federicohyo/OSCAR/data/README.md

# data

Archived result datasets — the inputs the plotting scripts in
`../measurements/` read. The shipped results cover LNA, wet-pad, array
characterisation, synaptic calibration, olfaction classification, and the
curated bias operating points.

| Directory | Contents |
|---|---|
| `olfaction/` | Olfaction classification: `olf_validate/*.npz` (nine held-out acquisitions), `olfaction_class_curve.json` / `_emul.json`, `olfaction_k3.json`, the hybrid score/slot/payoff JSONs, comparator JSONs, and the extra-panel inputs that ship here (`selfheal_*.json` drift summaries, the hybrid transfer/run arrays). |
| `synapse/` | Synaptic calibration: `onset_n5*.json` / `.csv` (weight-code ladder) and the rate-transfer CSVs. |
| `array/` | Array characterisation: `neuron_fi_allneurons.csv` (16-neuron FI sweep) and `scope_{14,17,20}_neu14_if.csv` (neuron-14 membrane traces used as FI insets). |
| `biases/` | Curated `*.biases` operating points referenced by the plotting table (25 MHz reference points, synapse-characterisation patterns, comparator levels, LNA biases). |

The derived result files here come from third-party metal-oxide gas-sensor
measurements; see `NOTICE` for attribution.

See `../docs/PLOTTING.md` for which figure reads which file.
