federicohyo/OSCAR/docs/figures/fig_hardware_layout.pdf

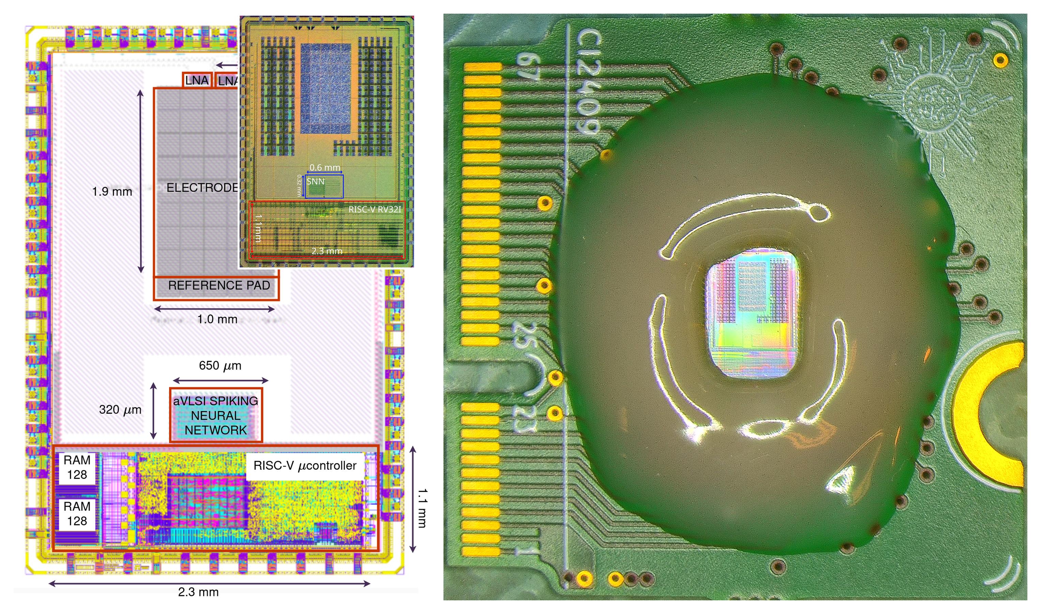
[picture p2: page 1]
