federicohyo/OSCAR/docs/figures/domain_map.pdf

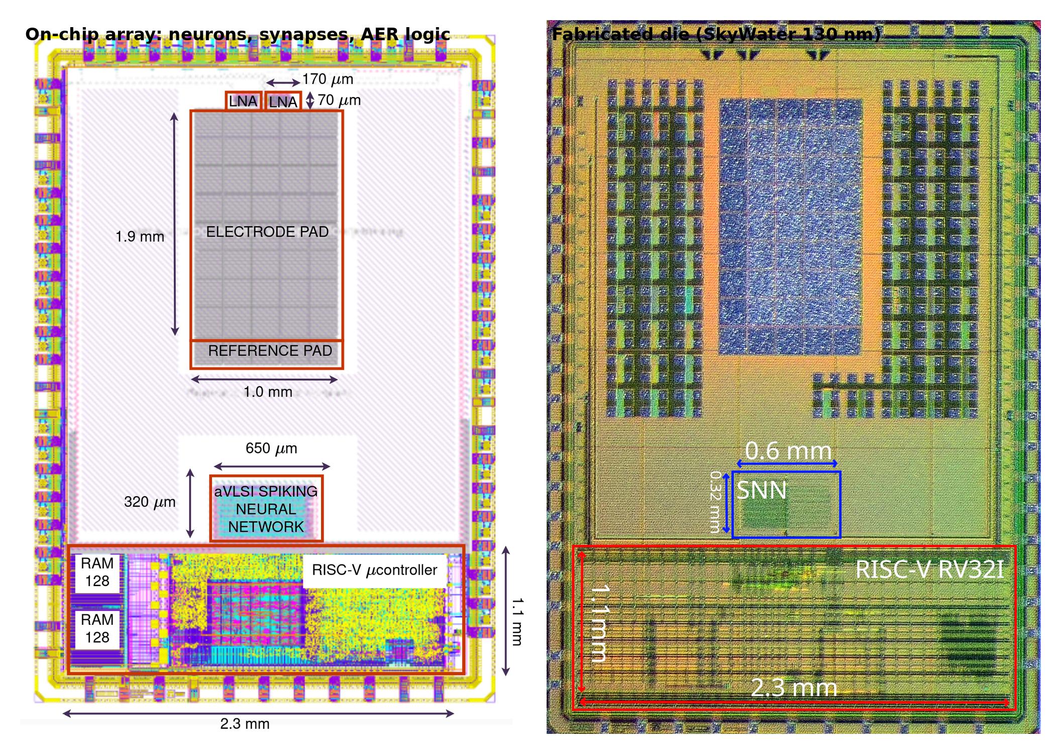
[picture p3: page 1]
