federicohyo/OSCAR/design/python/figures/neuron_analog_tb.png

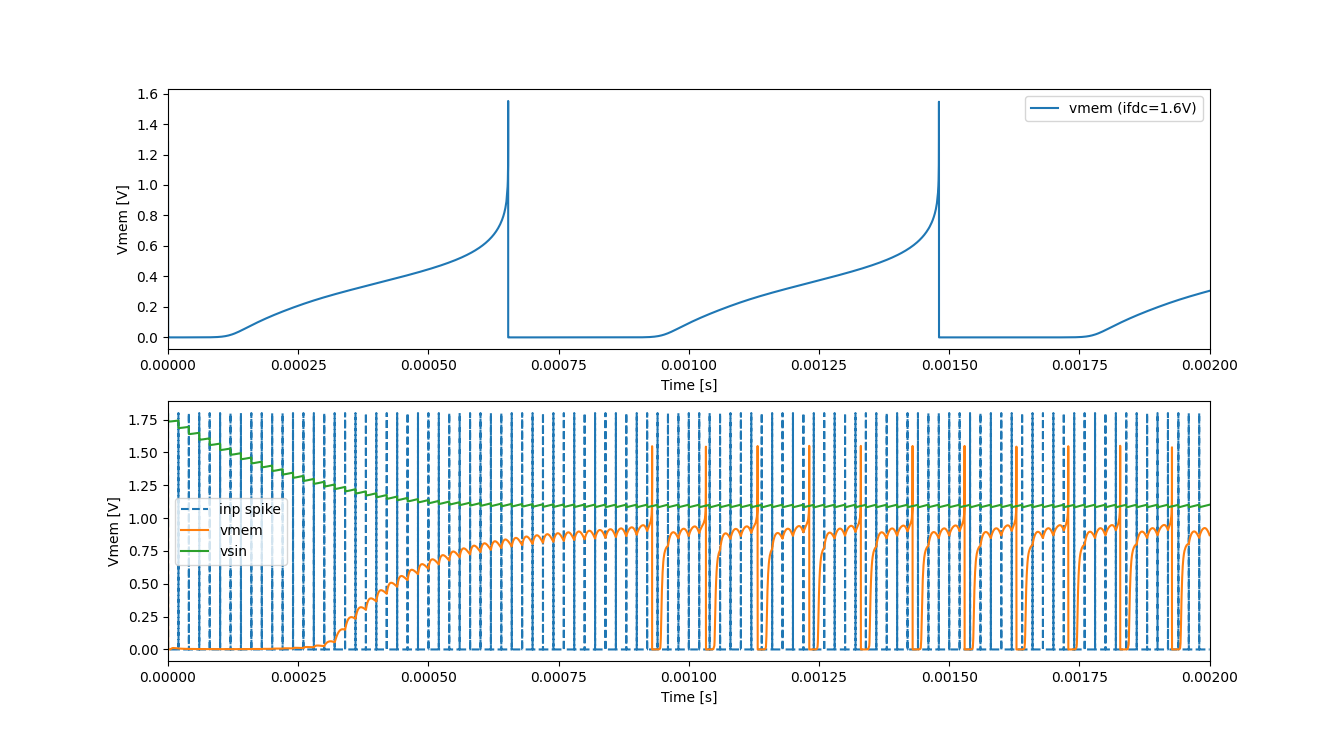
design/python/figures/neuron_analog_tb.png
