federicohyo/OSCAR/design/python/figures/neuron_analog_tb_v1.png

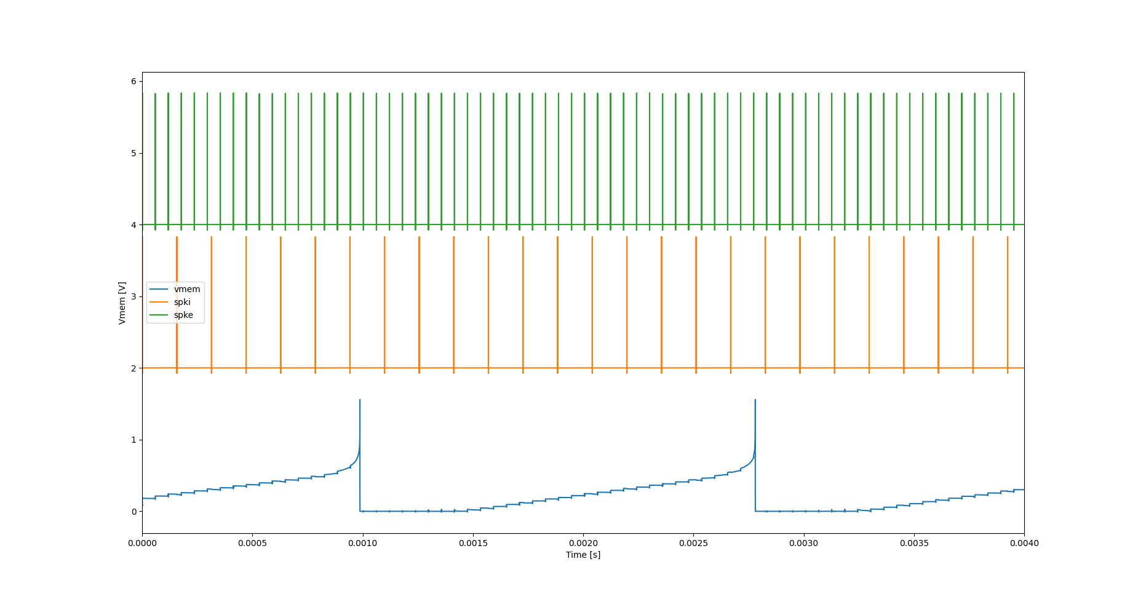
design/python/figures/neuron_analog_tb_v1.png
