federicohyo/OSCAR/design/python/figures/neuron_analog_tb_v1_ff.png

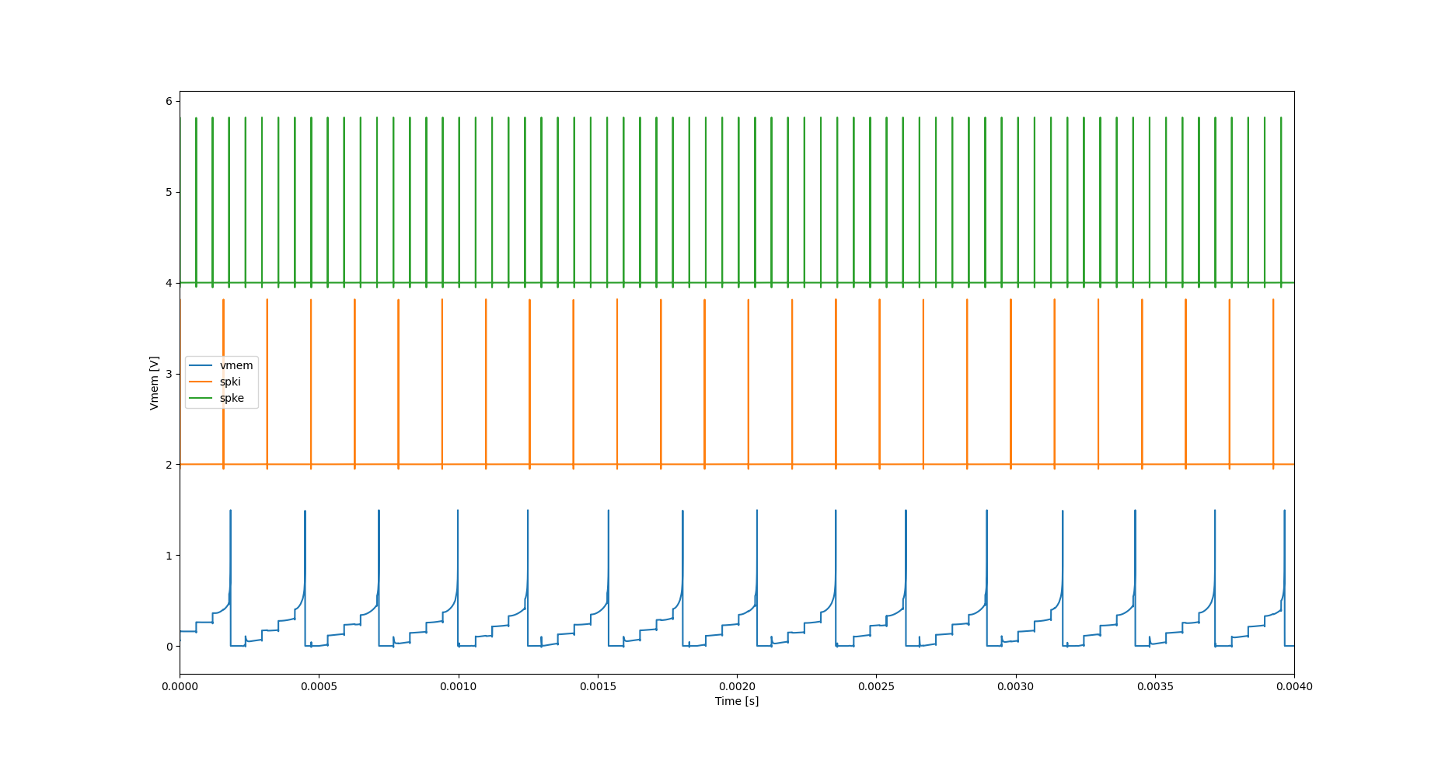
design/python/figures/neuron_analog_tb_v1_ff.png
