federicohyo/OSCAR/docs/figures/arch_overview.png

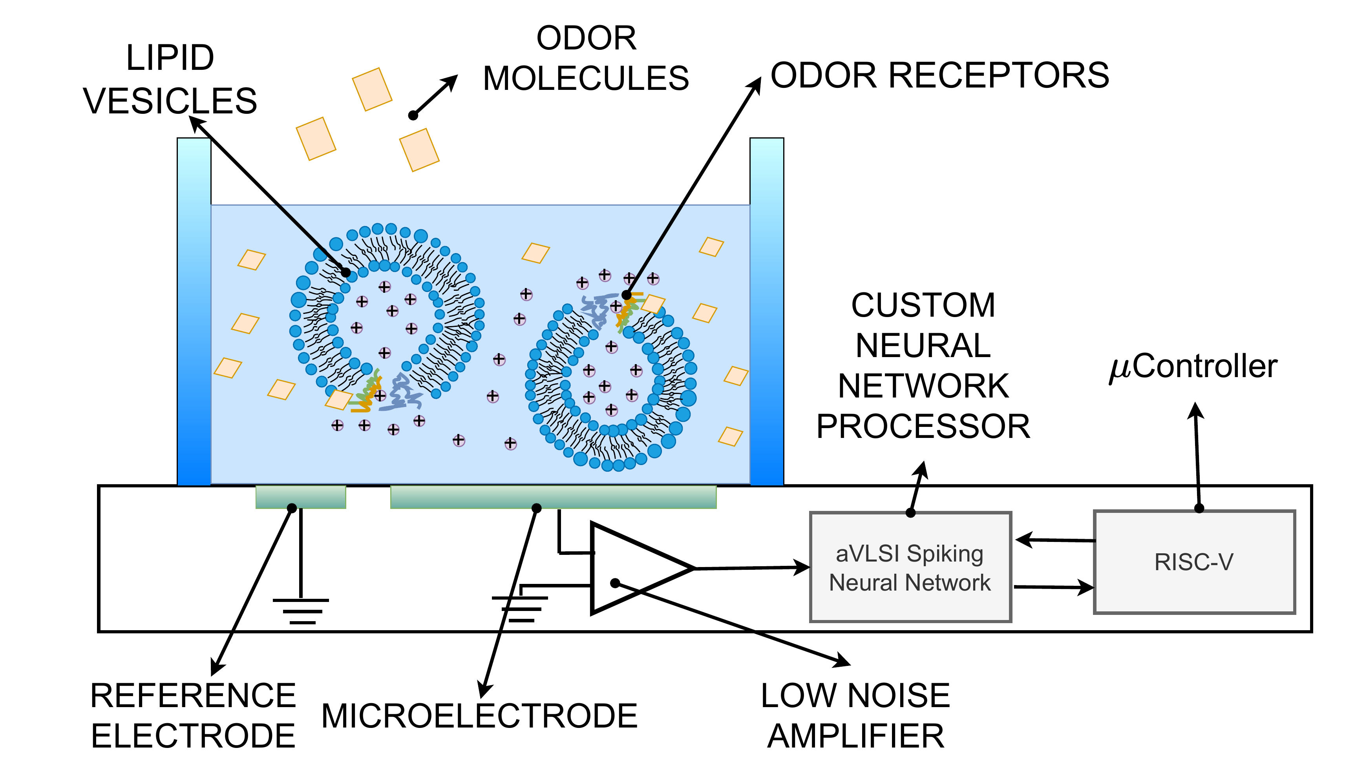
docs/figures/arch_overview.png
