federicohyo/OSCAR/measurements/plotting/figures/olfaction_cost.pdf

analog
array

all-digital
same pipeline

0

5000

10000

15000

20000

25000

30000

35000

40000

### energy per decision (μJ)

projection

kernel
features

0.76 voted 0.82 voted

tree kernels 158--220 μJ

(a)

input DSP: projection + encode output DSP: kernel features + classi

fier
AER interface (LA handshake) neurons: analog rail
neurons: digital emulation

digital
emulation

analog
array

0

10

20

30

40

50

### energy per neuron-step (nJ)

bar to beat

(b)

43.4 nJ

19.3 nJ

analog rail
AER read-out

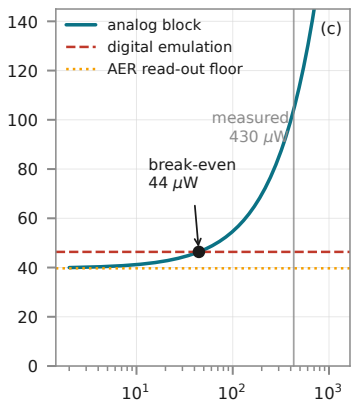
[picture p8: figure]
break-even 44 μW; measured 430 μW; analog block; digital emulation AER read-out; floor

a

n

### alo

g

r

### ail p

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
### neuron block, energy per chunk (μJ)
