federicohyo/OSCAR/measurements/lna/figures/tio2_dilute3x.pdf

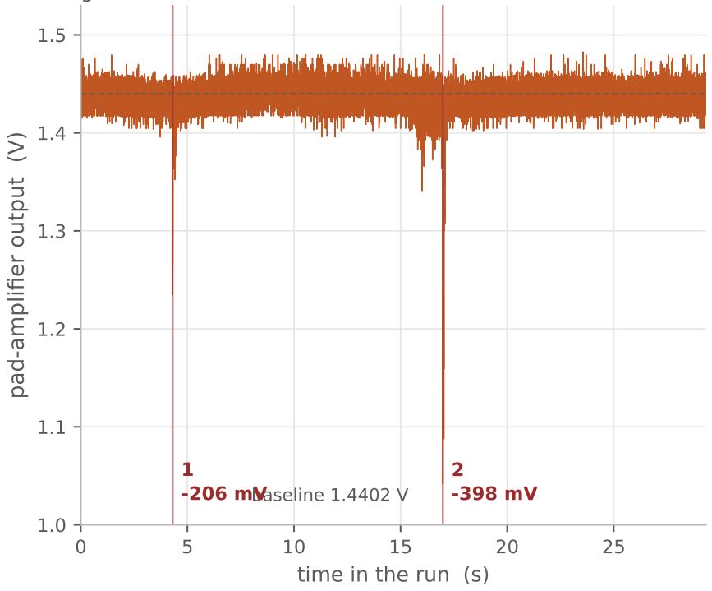
[picture p9: figure]
time in the run (s); pad-ampli; fier output (V); baseline 1.4402 V
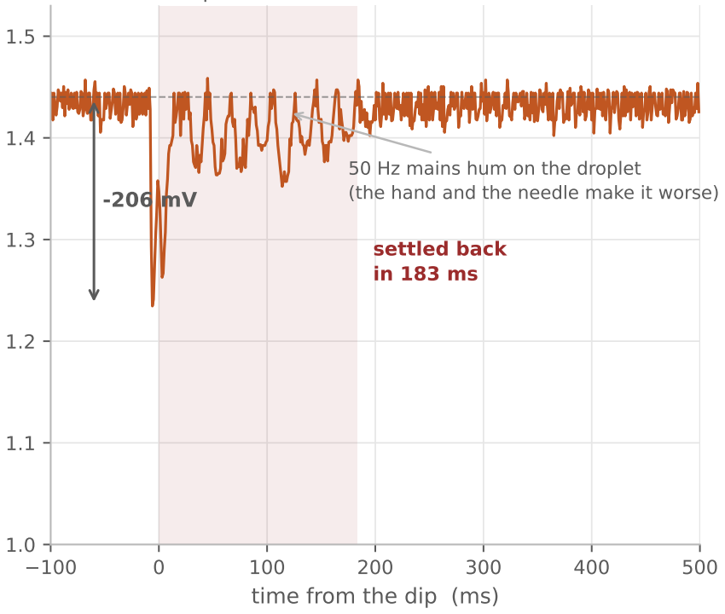
[picture p10: figure]
time from the dip (ms); settled back in 183 ms; 50 Hz mains hum on the droplet (the hand and the needle make it worse)
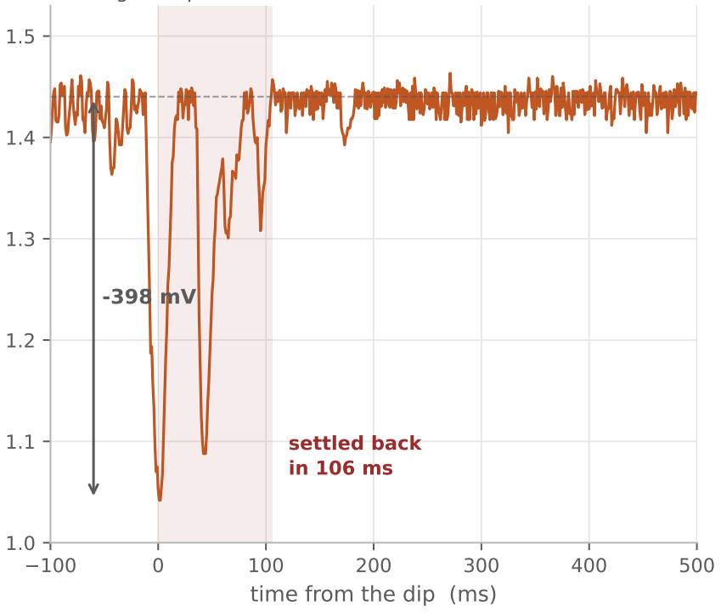
[picture p11: figure]
time from the dip (ms); settled back in 106 ms

graded, and the baseline comes back both times

## 1 — two injections

the smaller aliquot: -206 mV, no residual offset

## 2 — first injection

the larger aliquot: -398 mV, no residual offset

## 3 — second injection

# TiO₂ pad, saline diluted 3× and the biases moved off the clamp

scope_20260829_103015.csv, one continuous 1 kHz record, lna_iref = 1.157 V. Two injections into the droplet: both are graded, both recover, nothing saturates.
