federicohyo/OSCAR/measurements/lna/figures/tio2_injection_recovery.pdf

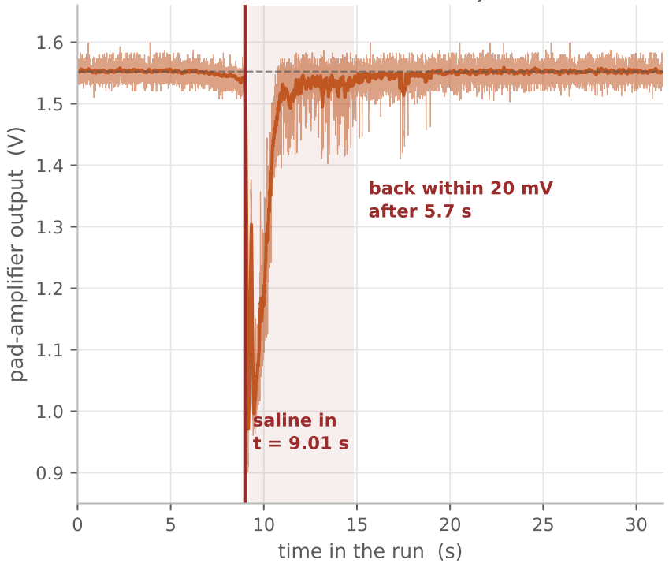
[picture p12: figure]
time in the run (s); pad-ampli; fier output (V); saline in t = 9.01 s; back within 20 mV after 5.7 s
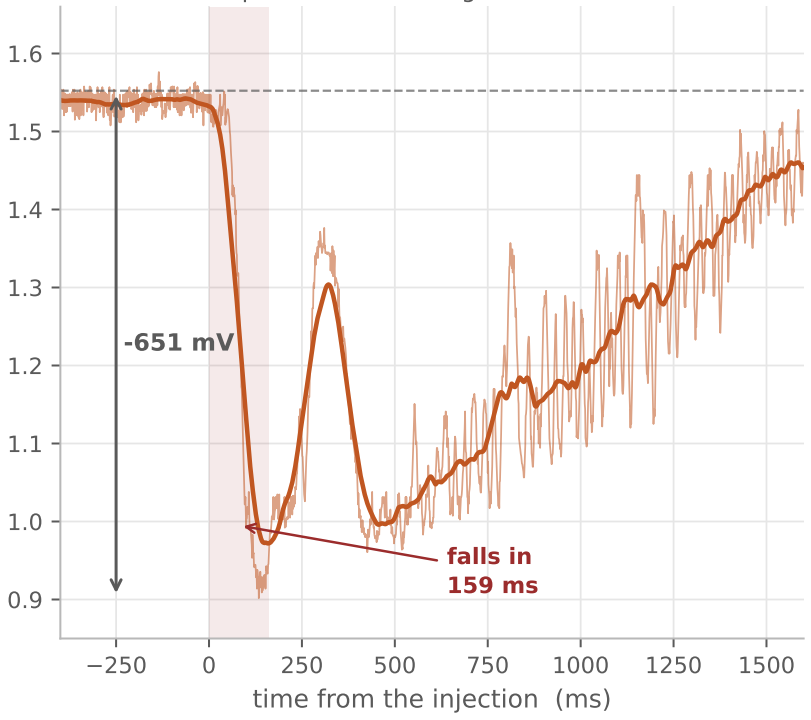
[picture p13: figure]
time from the injection (ms); falls in 159 ms
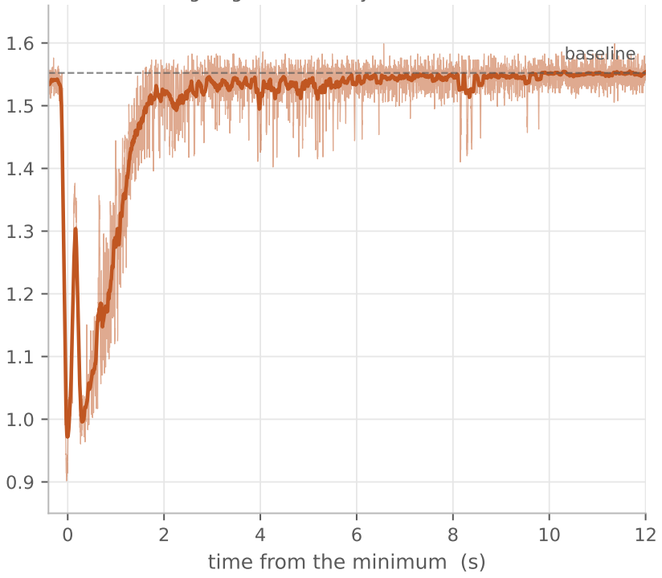
[picture p14: figure]
time from the minimum (s); baseline

baseline 1.5523 V, and it comes all the way back

### 1 — one injection

fast in, and far past the linear range

### 2 — the edge

the whole rising edge, all the way back

### 3 — the recovery

## TiO₂ pad: one saline injection, and the recovery

scope_20260829_110950-saline-injection&recovery.csv, one continuous 1 kHz record. Thin trace raw, thick trace smoothed over 101 ms (which nulls the 50 Hz mains pickup on the droplet).
