federicohyo/OSCAR/measurements/lna/figures/tio2_three_panel.pdf

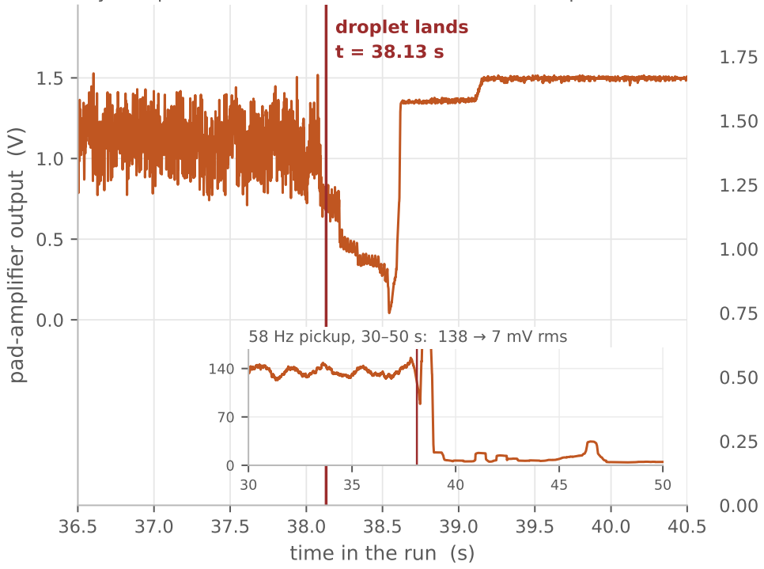
[picture p15: figure]
time in the run (s); pad-ampli; fier output (V); droplet lands t = 38.13 s; 58 Hz pickup, 30–50 s: 138 → 7 mV rms

dry, the pad is an antenna; water lands and that stops

### 1 — wetting

output holds 1.497 V for 5 s; 7 mV rms

### 2 — it settles, and stays quiet

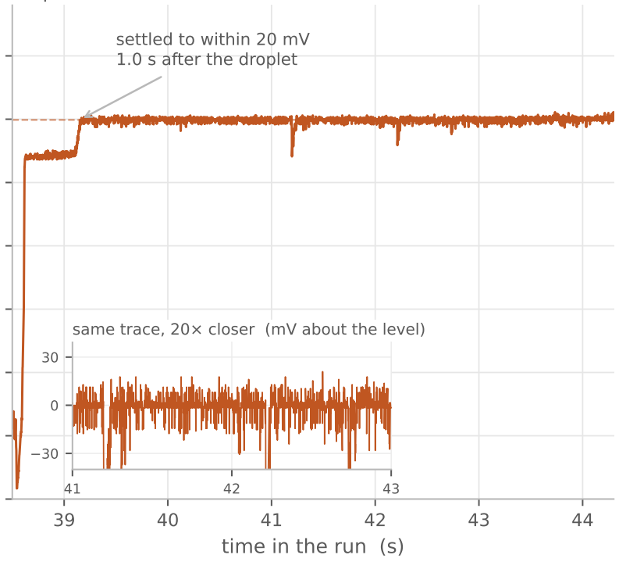
[picture p16: figure]
time in the run (s); settled to within 20 mV 1.0 s after the droplet

same trace, 20× closer (mV about the level) the salt drives the output +308 mV, up to the rail

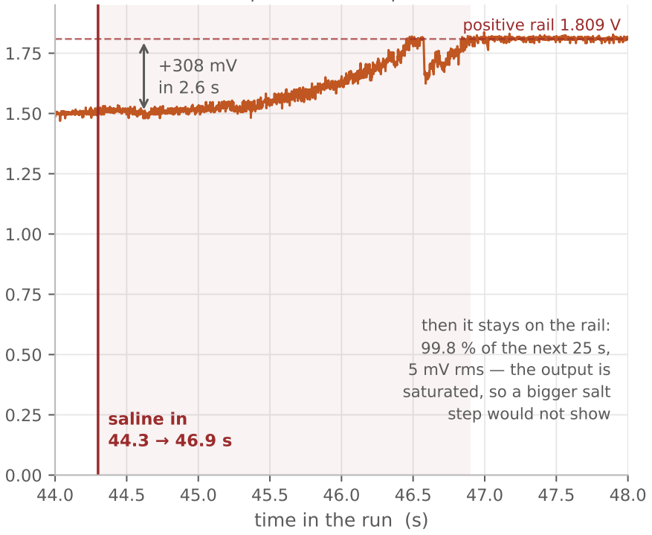
[picture p17: figure]
time in the run (s); positive rail 1.809 V

| | then it stays on the rail: 99.8 % of the next 25 s,
saline in | 5 mV rms — the output is saturated, so a bigger salt | step would not show

### 3 — saline, and the output signal

## TiO₂ water pad — output of the on-chip pad amplifier (scope ch2)

one continuous 1 kHz record, scope_20260829_094236.csv. The second amplifier (ch1, jack input) is not driven here and is not shown.
