federicohyo/OSCAR/measurements/plotting/figures/ecg_frontier.pdf

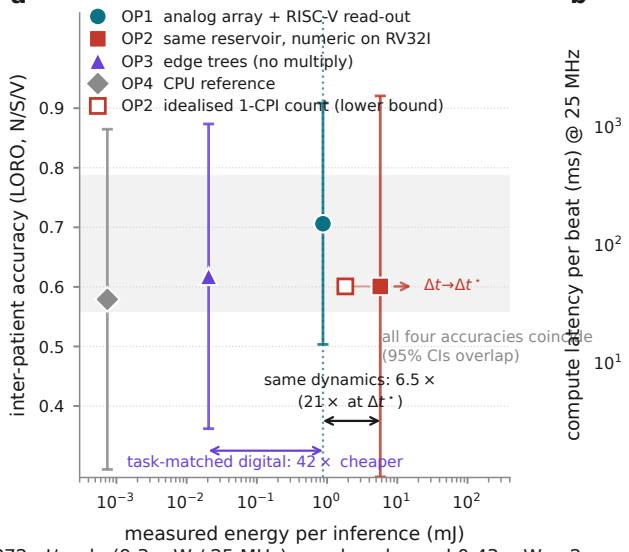
[picture p18: figure]
measured energy per inference (mJ); inter-patient accuracy (LORO, N/S/V); all four accuracies coincide (95% CIs overlap) same dynamics: 6.5 × (21 × at Δt; task-matched digital: 42 × cheaper; OP1 analog array + RISC-V read-out OP2 same reservoir, numeric on RV32I OP3 edge trees (no multiply) OP4 CPU reference OP2 idealised 1-CPI count (lower bound); compute latency per beat (ms) @ 25 MHz

372 pJ/cycle (9.3 mW / 25 MHz) · analog charged 0.43 mW × 2 s

a

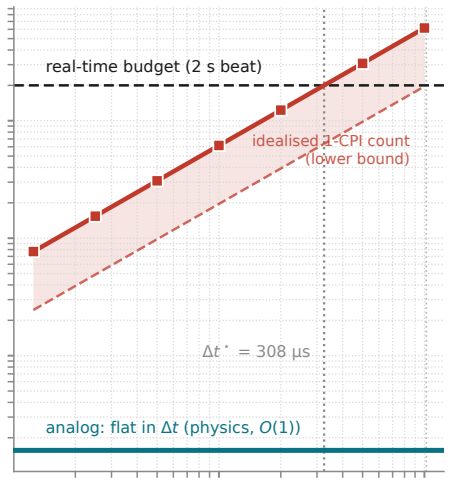
[picture p19: figure]
idealised 1-CPI count (lower bound); real-time budget (2 s beat); analog: flat in Δt (physics, O(1))

10

3 | 10

4
temporal-resolution demand 1/Δt (Hz)

numeric, measured: ∝ N/Δt

b
