federicohyo/OSCAR/measurements/lna/clean_2026-08-26/derived/transfer.csv

tag | block | utc | freq_hz | jack_vpp | divider | vin_pp | settle_s | window_s | vout_pp | gain | gain_db | dc_v | peak_v | trough_v | h2 | h3 | resid_rms_v | amp_se_v | drift_mv_s | n_samples | frac_at_rail | frac_at_zero | raw_npz | flag
quiet_before | transfer | 18:14:03 | 88.5700 | 0.00000 | 0.028 | 0.000000 | 20.0 | 8.0 | 0.000460 | nan |  | 1.6757 | 1.6759 | 1.6755 | 1.7291 | 1.1520 | 0.015729 | 0.000248 | 0.169 | 8046 | 0.0000 | 0.0000 | raw/transfer/quiet_before.npz | no drive
F00_0.2125Hz | transfer | 18:15:32 | 0.2125 | 0.01786 | 0.028 | 0.000500 | 60.0 | 28.235294117647058 | 0.003534 | 7.07 | 16.986 | 1.6757 | 1.6774 | 1.6739 | 0.1312 | 0.1439 | 0.015769 | 0.000132 | 0.024 | 28380 | 0.0000 | 0.0000 | raw/transfer/F00_0.2125Hz.npz
F01_0.3099Hz | transfer | 18:16:52 | 0.3099 | 0.01786 | 0.028 | 0.000500 | 60.0 | 19.36108422071636 | 0.008686 | 17.37 | 24.797 | 1.6754 | 1.6798 | 1.6711 | 0.1153 | 0.1061 | 0.015800 | 0.000160 | -0.089 | 19456 | 0.0000 | 0.0000 | raw/transfer/F01_0.3099Hz.npz
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
