federicohyo/OSCAR/measurements/plotting/figures/bias_mismatch_heatmap.pdf

0.20

0.21

## Vleakn (V)

n0 | n1 | n2 | n3

0.20

0.21

## Vleakn (V)

n4 | n5 | n6 | n7

0.20

0.21

## Vleakn (V)

n8 | n9 | n10 | n11

1.275 1.300 Ifdcp (V)

0.20

0.21

## Vleakn (V)

n12

1.275 1.300 Ifdcp (V)

n13

1.275 1.300 Ifdcp (V)

n14

1.275 1.300 Ifdcp (V)

n15

### Firing rate (Hz)
