federicohyo/OSCAR/measurements/plotting/figures/comparator_drift2.pdf

## (a) die 1: five-day drift, then repair

## (b) die 2: one session, top of the ladder wanders

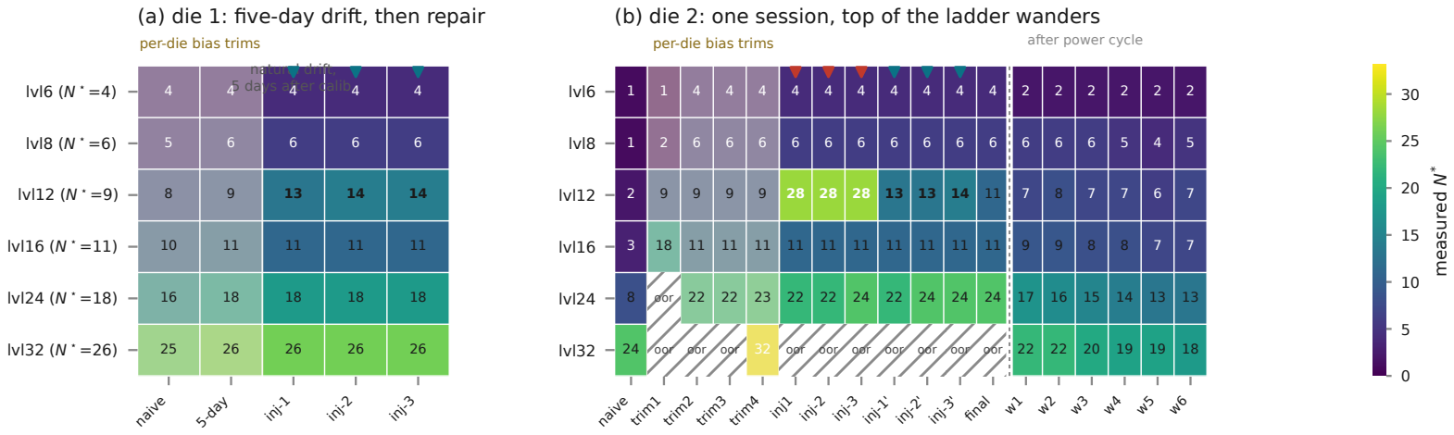
[picture p20: page 1]

naive

5-day
inj-1

inj-2

inj-3

lvl6 (N

⋆ =4)

lvl8 (N

⋆ =6)

lvl12 (N

⋆ =9)

lvl16 (N

⋆ =11)

lvl24 (N

⋆ =18)

lvl32 (N

⋆ =26)

per-die bias trims
natural drift,
5 days after calib.
4 | 4 | 4 | 4 | 4
5 | 6 | 6 | 6 | 6
8 | 9 | 13 | 14 | 14
10 | 11 | 11 | 11 | 11
16 | 18 | 18 | 18 | 18
25 | 26 | 26 | 26 | 26

naive
trim1

trim2

trim3

trim4

inj1

inj-2

inj-3

inj-1'

inj-2'
inj-3'

final
w1

w2

w3

w4

w5

w6

lvl6

lvl8

lvl12

lvl16

lvl24

lvl32

per-die bias trims | after power cycle
1 | 1 | 4 | 4 | 4 | 4 | 4 | 4 | 4 | 4 | 4 | 4 | 2 | 2 | 2 | 2 | 2 | 2
1 | 2 | 6 | 6 | 6 | 6 | 6 | 6 | 6 | 6 | 6 | 6 | 6 | 6 | 6 | 5 | 4 | 5
2 | 9 | 9 | 9 | 9 | 28 | 28 | 28 | 13 | 13 | 14 | 11 | 7 | 8 | 7 | 7 | 6 | 7
3 | 18 | 11 | 11 | 11 | 11 | 11 | 11 | 11 | 11 | 11 | 11 | 9 | 9 | 8 | 8 | 7 | 7
8 | oor | 22 | 22 | 23 | 22 | 22 | 24 | 22 | 24 | 24 | 24 | 17 | 16 | 15 | 14 | 13 | 13
24 | oor | oor | oor | 32 | oor | oor | oor | oor | oor | oor | oor | 22 | 22 | 20 | 19 | 19 | 18
0

5

10

15

20

25

30

### measured N

*
