federicohyo/OSCAR/measurements/plotting/figures/comparator_drift2_a.pdf

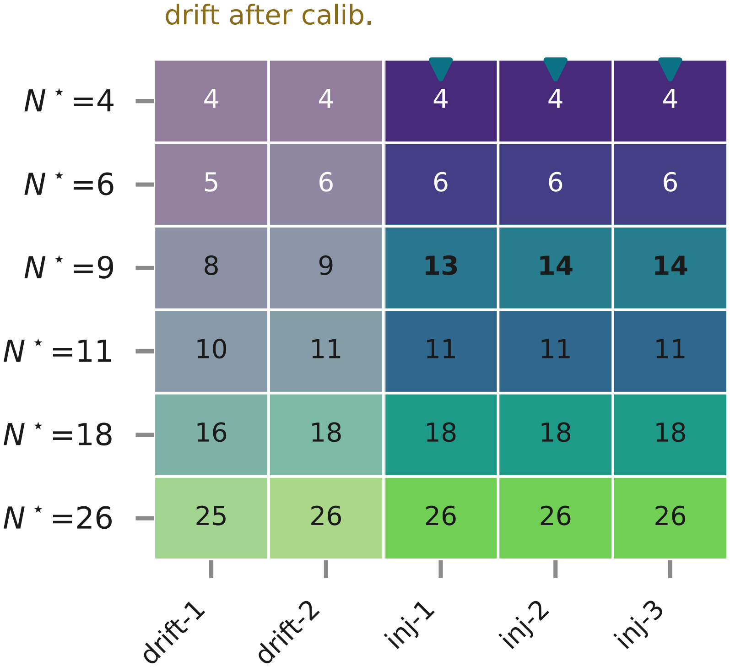
[picture p21: page 1]

drift-1

drift-2

inj-1

inj-2

inj-3

N

⋆ =4

N

⋆ =6

N

⋆ =9

N

⋆ =11

N

⋆ =18

N

⋆ =26

drift after calib.

4 | 4 | 4 | 4 | 4
5 | 6 | 6 | 6 | 6
8 | 9 | 13 | 14 | 14
10 | 11 | 11 | 11 | 11
16 | 18 | 18 | 18 | 18
25 | 26 | 26 | 26 | 26
