federicohyo/OSCAR/measurements/plotting/figures/comparator_drift2d.pdf

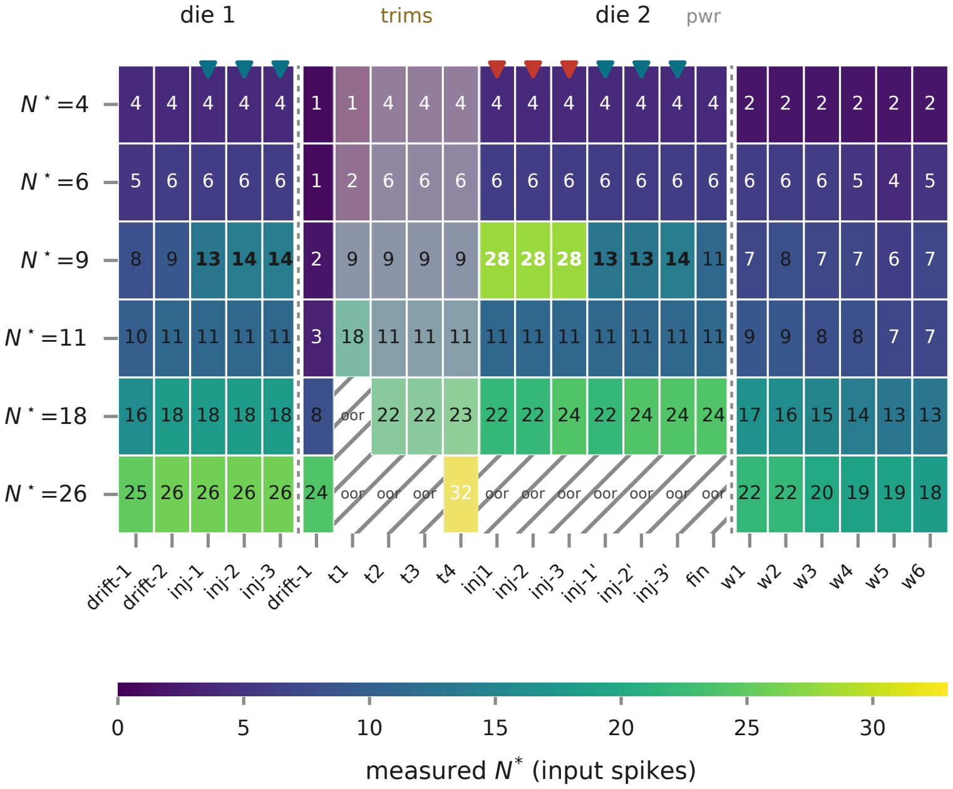
[picture p22: page 1]

drift-1

drift-2
inj-1
inj-2

inj-3

drift-1
t1
t2

t3

t4

inj1

inj-2

inj-3
inj-1'
inj-2'

inj-3'
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
⋆ =4

N

⋆ =6

N

⋆ =9

N

⋆ =11

N

⋆ =18

N

⋆ =26

die 1 | trims | die 2 | pwr
4 | 4 | 4 | 4 | 4 | 1 | 1 | 4 | 4 | 4 | 4 | 4 | 4 | 4 | 4 | 4 | 4 | 2 | 2 | 2 | 2 | 2 | 2
5 | 6 | 6 | 6 | 6 | 1 | 2 | 6 | 6 | 6 | 6 | 6 | 6 | 6 | 6 | 6 | 6 | 6 | 6 | 6 | 5 | 4 | 5
8 | 9 | 13 | 14 | 14 | 2 | 9 | 9 | 9 | 9 | 28 | 28 | 28 | 13 | 13 | 14 | 11 | 7 | 8 | 7 | 7 | 6 | 7
10 | 11 | 11 | 11 | 11 | 3 | 18 | 11 | 11 | 11 | 11 | 11 | 11 | 11 | 11 | 11 | 11 | 9 | 9 | 8 | 8 | 7 | 7
16 | 18 | 18 | 18 | 18 | 8 | oor | 22 | 22 | 23 | 22 | 22 | 24 | 22 | 24 | 24 | 24 | 17 | 16 | 15 | 14 | 13 | 13
25 | 26 | 26 | 26 | 26 | 24 | oor | oor | oor | 32 | oor | oor | oor | oor | oor | oor | oor | 22 | 22 | 20 | 19 | 19 | 18
0 | 5 | 10 | 15 | 20 | 25 | 30

### measured N

*

### (input spikes)
