federicohyo/OSCAR/measurements/plotting/figures/olfaction_scaling.pdf

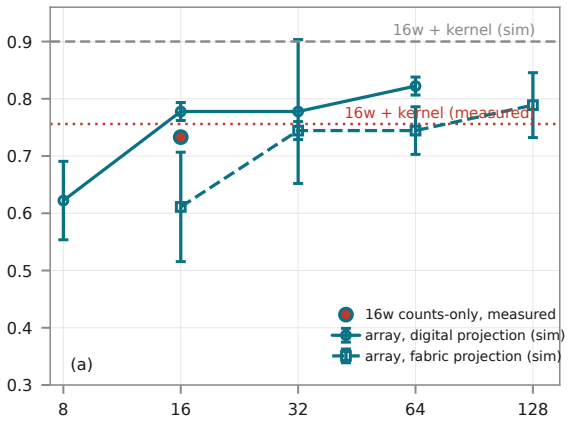
[picture p23: figure]
16w + kernel (sim); 16w + kernel (measured); 16w counts-only, measured; array, digital projection (sim) array, fabric projection (sim)

### neurons in the layer

### voted accuracy (counts only)

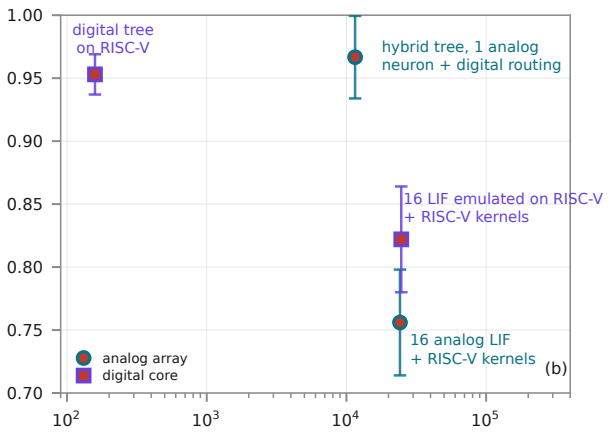
[picture p24: figure]
16 analog LIF + RISC-V kernels; 16 LIF emulated on RISC-V + RISC-V kernels; digital tree; on RISC-V; hybrid tree, 1 analog; neuron + digital routing; digital core; (b) analog array

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
### cisio

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
### voted accuracy
