federicohyo/OSCAR/measurements/plotting/figures/olfaction_scaling_b.pdf

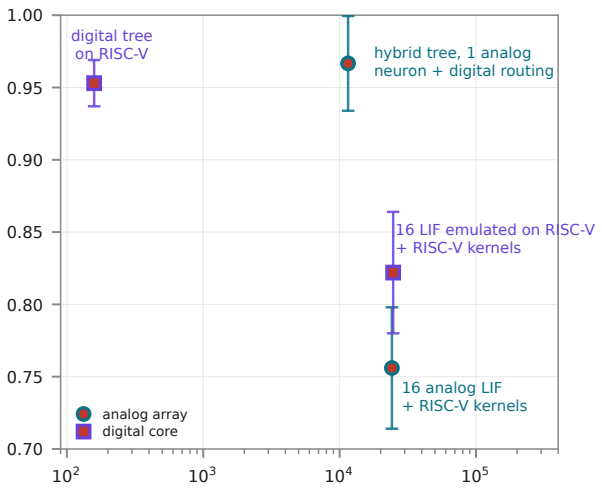
[picture p25: figure]
16 analog LIF + RISC-V kernels; 16 LIF emulated on RISC-V + RISC-V kernels; digital tree; on RISC-V; hybrid tree, 1 analog; neuron + digital routing; analog array digital core

### energy per decision (μJ), voted over 5 chunks

### voted accuracy
