federicohyo/OSCAR/measurements/plotting/figures/positive_controls.pdf

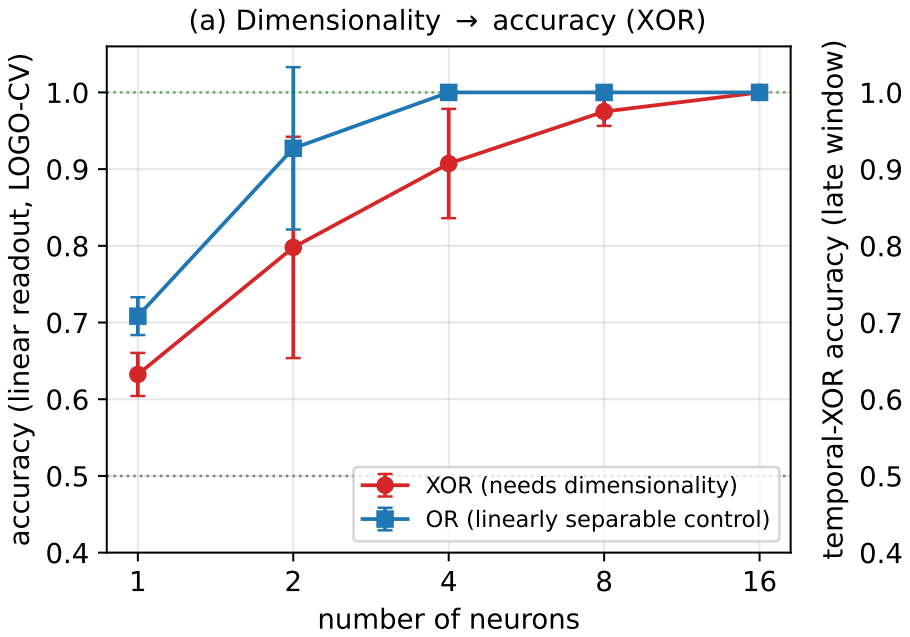
[picture p26: figure]
number of neurons; accuracy (linear readout, LOGO-CV); Dim; sio; alit; XOR (needs dimensionality) OR (linearly separable control); temporal-XOR accuracy (late window)
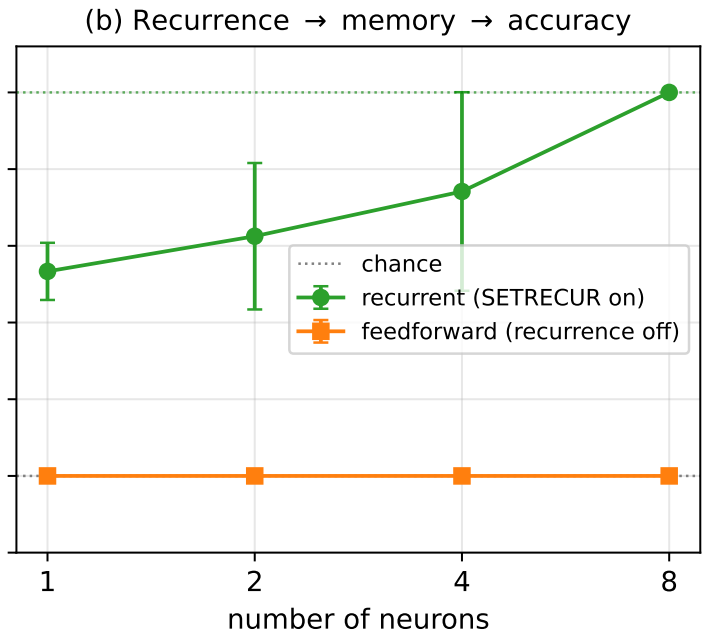
[picture p27: figure]
number of neurons; chance recurrent (SETRECUR on) feedforward (recurrence o
