federicohyo/OSCAR/measurements/plotting/figures/synfire_raster.pdf

0 | 500 | 1000 | 1500 | 2000
Time (ms)

0369

12

15

Neuron index (AER)
