federicohyo/OSCAR/measurements/plotting/figures/weight_vs_rate.pdf

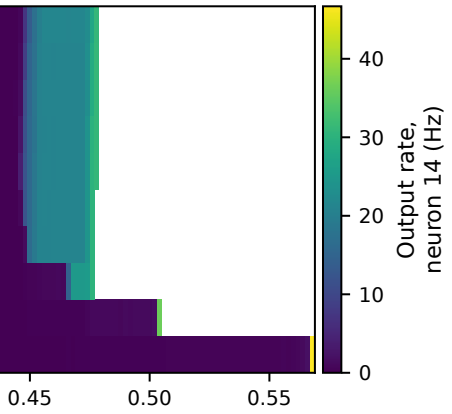
[picture p28: figure]
Output rate,; neuron 14 (Hz)

Excitatory synaptic weight bias JExcWn0 (V)

200

400

600

800

1000
Input stimulation rate (Hz)
