federicohyo/OSCAR/measurements/lna/clean_2026-08-26/derived/gain_crosscheck.csv

tag | block | utc | freq_hz | jack_vpp | divider | vin_pp | settle_s | window_s | vout_pp | gain | gain_db | dc_v | peak_v | trough_v | h2 | h3 | resid_rms_v | amp_se_v | drift_mv_s | n_samples | frac_at_rail | frac_at_zero | raw_npz | flag
C0_100uVpp | gain_crosscheck | 18:56:27 | 88.5700 | 0.00357 | 0.028 | 0.000100 | 60.0 | 12.0 | 0.027581 | 275.81 | 48.812 | 1.6328 | 1.6466 | 1.6190 | 0.0139 | 0.0082 | 0.014245 | 0.000183 | -0.028 | 12142 | 0.0000 | 0.0000 | raw/gain_crosscheck/C0_100uVpp.npz
C1_150uVpp | gain_crosscheck | 18:57:40 | 88.5700 | 0.00536 | 0.028 | 0.000150 | 60.0 | 12.0 | 0.042609 | 284.06 | 49.068 | 1.6551 | 1.6764 | 1.6338 | 0.0054 | 0.0064 | 0.015074 | 0.000193 | 0.316 | 12142 | 0.0000 | 0.0000 | raw/gain_crosscheck/C1_150uVpp.npz
C2_200uVpp | gain_crosscheck | 18:58:53 | 88.5700 | 0.00714 | 0.028 | 0.000200 | 60.0 | 12.0 | 0.056725 | 283.63 | 49.055 | 1.6531 | 1.6815 | 1.6247 | 0.0073 | 0.0086 | 0.015204 | 0.000195 | -0.231 | 12142 | 0.0000 | 0.0000 | raw/gain_crosscheck/C2_200uVpp.npz
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
