federicohyo/OSCAR/measurements/lna/clean_2026-08-26/derived/gain_vs_level.csv

tag | block | utc | freq_hz | jack_vpp | divider | vin_pp | settle_s | window_s | vout_pp | gain | gain_db | dc_v | peak_v | trough_v | h2 | h3 | resid_rms_v | amp_se_v | drift_mv_s | n_samples | frac_at_rail | frac_at_zero | raw_npz | flag
quiet_before | gain_vs_level | 18:02:15 | 88.5700 | 0.00000 | 0.028 | 0.000000 | 20.0 | 8.0 | 0.001023 | nan |  | 1.6727 | 1.6732 | 1.6722 | 0.4789 | 0.2884 | 0.015637 | 0.000247 | 0.296 | 8046 | 0.0000 | 0.0000 | raw/gain_vs_level/quiet_before.npz | no drive
L0_150uVpp | gain_vs_level | 18:03:23 | 88.5700 | 0.00536 | 0.028 | 0.000150 | 60.0 | 8.0 | 0.043991 | 293.27 | 49.345 | 1.6732 | 1.6952 | 1.6512 | 0.0142 | 0.0161 | 0.015512 | 0.000245 | -0.011 | 8046 | 0.0000 | 0.0000 | raw/gain_vs_level/L0_150uVpp.npz
L1_300uVpp | gain_vs_level | 18:04:32 | 88.5700 | 0.01071 | 0.028 | 0.000300 | 60.0 | 8.0 | 0.082796 | 275.99 | 48.818 | 1.6700 | 1.7114 | 1.6286 | 0.0222 | 0.0144 | 0.015087 | 0.000238 | -0.489 | 8045 | 0.0000 | 0.0000 | raw/gain_vs_level/L1_300uVpp.npz
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
