federicohyo/OSCAR/measurements/lna/clean_2026-08-26/derived/odor_response.csv

t_s | vout_mean_v | vout_sem_v | expected_v | n_repeats
-0.2990 | -0.0288951 | 0.0012223 | -0.0100116 | 10
-0.2980 | -0.0291031 | 0.0011557 | -0.0101982 | 10
-0.2970 | -0.0291085 | 0.0011063 | -0.0101525 | 10
-0.2960 | -0.0289025 | 0.0010783 | -0.0098826 | 10
-0.2950 | -0.0284850 | 0.0010721 | -0.0094064 | 10
-0.2940 | -0.0278627 | 0.0010836 | -0.0087482 | 10
-0.2930 | -0.0270477 | 0.0011066 | -0.0079357 | 10
-0.2920 | -0.0260561 | 0.0011346 | -0.0069965 | 10
-0.2910 | -0.0249059 | 0.0011623 | -0.0059555 | 10
-0.2900 | -0.0236169 | 0.0011867 | -0.0048329 | 10
-0.2890 | -0.0222091 | 0.0012068 | -0.0036434 | 10
-0.2880 | -0.0207026 | 0.0012235 | -0.0023965 | 10
-0.2870 | -0.0191180 | 0.0012385 | -0.0010974 | 10
-0.2860 | -0.0174759 | 0.0012538 | 0.0002512 | 10
-0.2850 | -0.0157981 | 0.0012705 | 0.0016468 | 10
-0.2840 | -0.0141076 | 0.0012889 | 0.0030852 | 10
-0.2830 | -0.0124293 | 0.0013079 | 0.0045581 | 10
-0.2820 | -0.0107902 | 0.0013257 | 0.0060513 | 10
-0.2810 | -0.0092196 | 0.0013398 | 0.0075437 | 10
-0.2800 | -0.0077487 | 0.0013481 | 0.0090069 | 10
-0.2790 | -0.0064097 | 0.0013493 | 0.0104057 | 10
-0.2780 | -0.0052348 | 0.0013431 | 0.0116992 | 10
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
