federicohyo/OSCAR/measurements/lna/clean_2026-08-26/raw/scope/scope_34.csv

x-axis | 1
second | Volt
-25.00000E-03 | +217.31157E-03
-24.97500E-03 | +209.27137E-03
-24.95000E-03 | +209.27137E-03
-24.92500E-03 | +209.27137E-03
-24.90000E-03 | +217.31157E-03
-24.87500E-03 | +209.27137E-03
-24.85000E-03 | +209.27137E-03
-24.82500E-03 | +209.27137E-03
-24.80000E-03 | +209.27137E-03
-24.77500E-03 | +209.27137E-03
-24.75000E-03 | +209.27137E-03
-24.72500E-03 | +217.31157E-03
-24.70000E-03 | +209.27137E-03
-24.67500E-03 | +209.27137E-03
-24.65000E-03 | +209.27137E-03
-24.62500E-03 | +209.27137E-03
-24.60000E-03 | +217.31157E-03
-24.57500E-03 | +209.27137E-03
-24.55000E-03 | +217.31157E-03
-24.52500E-03 | +217.31157E-03
-24.50000E-03 | +225.35177E-03
-24.47500E-03 | +241.43217E-03
-24.45000E-03 | +249.47237E-03
-24.42500E-03 | +257.51257E-03
-24.40000E-03 | +265.55277E-03
-24.37500E-03 | +265.55277E-03
-24.35000E-03 | +257.51257E-03
-24.32500E-03 | +249.47237E-03
-24.30000E-03 | +249.47237E-03
-24.27500E-03 | +241.43217E-03
-24.25000E-03 | +241.43217E-03
-24.22500E-03 | +241.43217E-03
-24.20000E-03 | +225.35177E-03
-24.17500E-03 | +209.27137E-03
-24.15000E-03 | +201.23117E-03
-24.12500E-03 | +193.19097E-03
-24.10000E-03 | +185.15076E-03
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
