federicohyo/OSCAR/measurements/array/figures/neuron_fi_reference.png

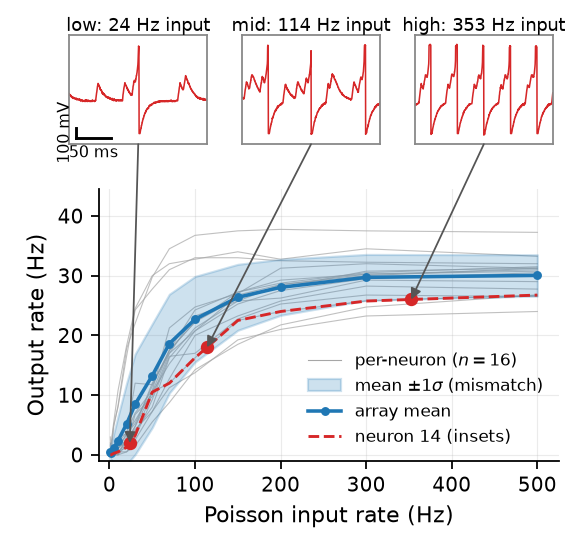
measurements/array/figures/neuron_fi_reference.png
