federicohyo/OSCAR/measurements/lna/clean_2026-08-26/figures/gain_vs_frequency.png

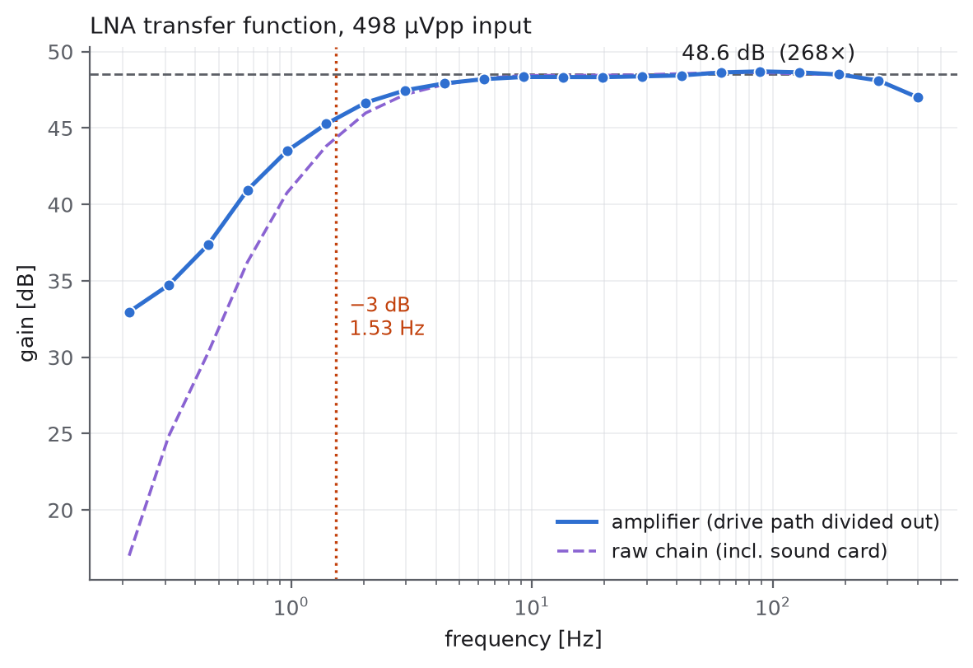
measurements/lna/clean_2026-08-26/figures/gain_vs_frequency.png
