federicohyo/OSCAR/measurements/lna/figures/chip_bath.jpg

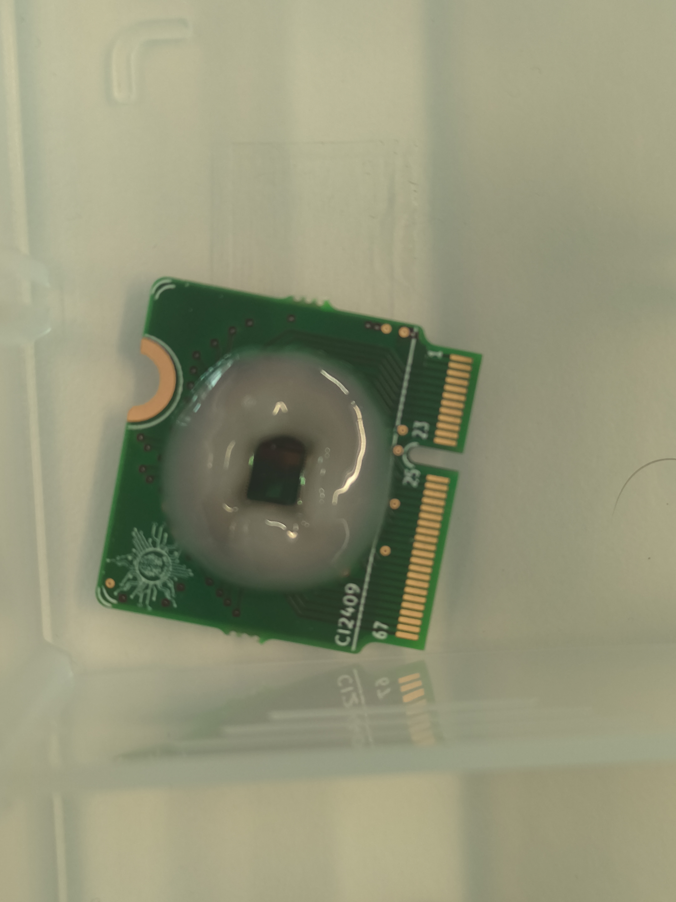
measurements/lna/figures/chip_bath.jpg
