federicohyo/OSCAR/measurements/lna/figures/fig12_lna_transfer.png

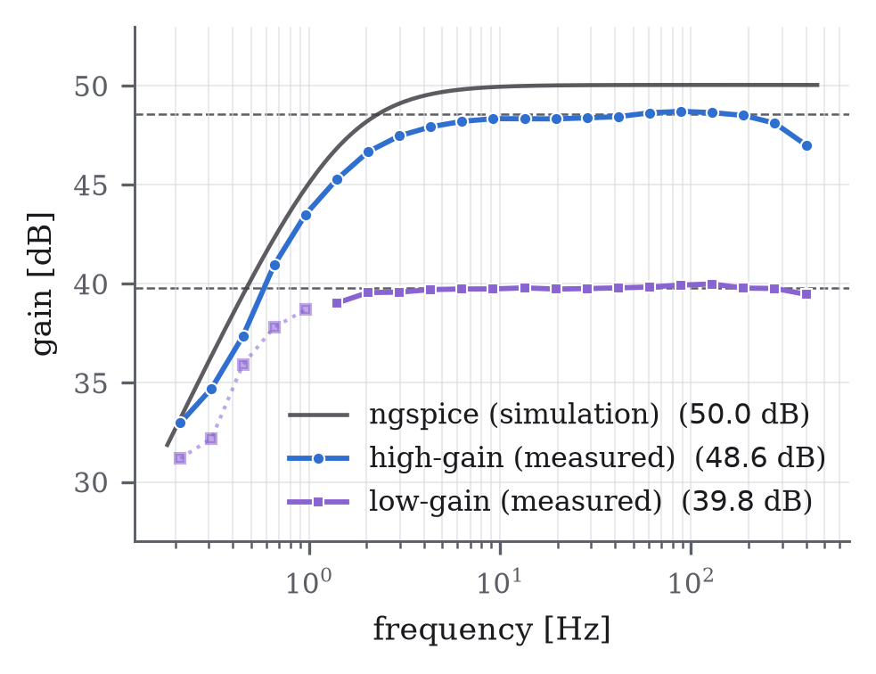
measurements/lna/figures/fig12_lna_transfer.png
