federicohyo/OSCAR/measurements/lna/figures/fig14_lna_noise.png

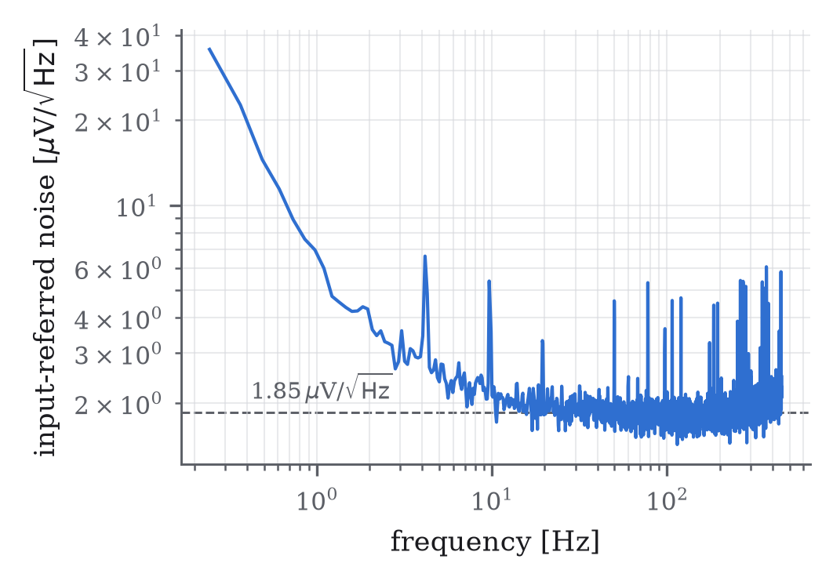
measurements/lna/figures/fig14_lna_noise.png
