federicohyo/OSCAR/measurements/lna/figures/gain_vs_level_highgain.png

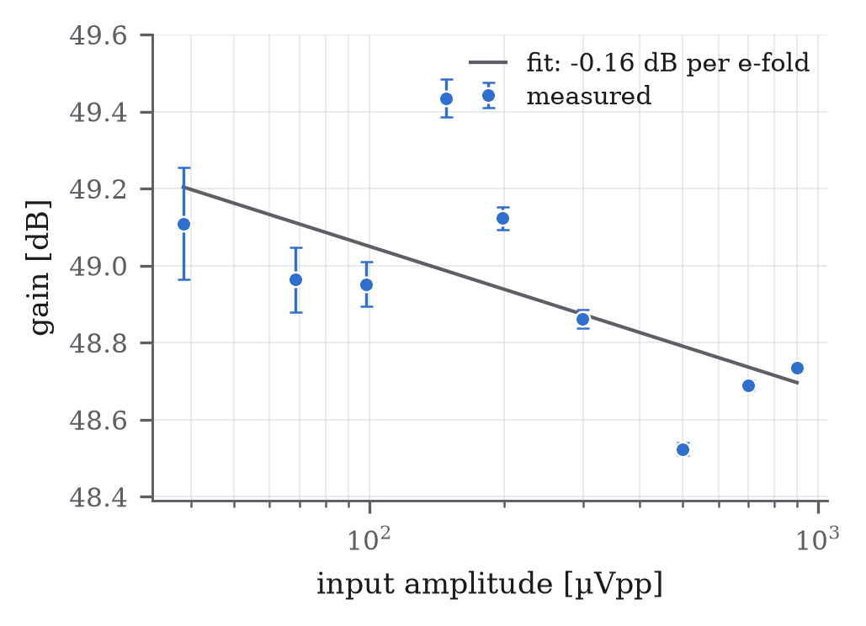
measurements/lna/figures/gain_vs_level_highgain.png
