federicohyo/OSCAR/measurements/lna/figures/lna_distortion_vs_level.png

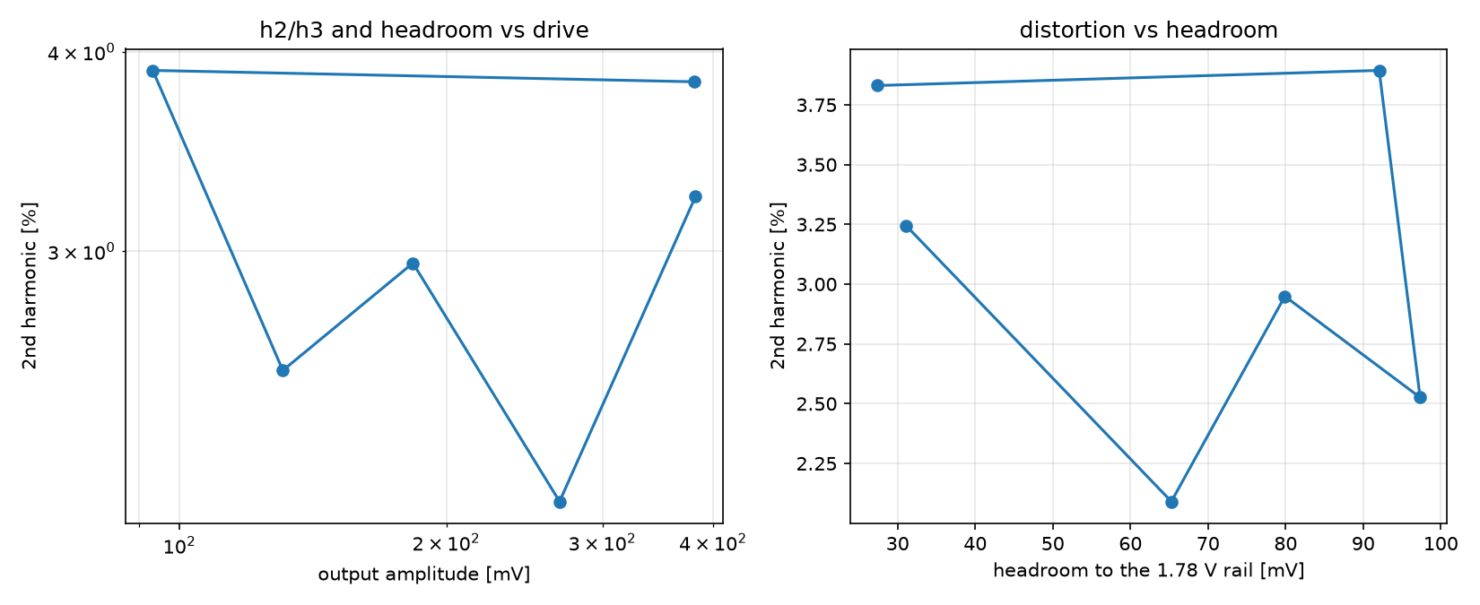
measurements/lna/figures/lna_distortion_vs_level.png
