federicohyo/OSCAR/measurements/lna/figures/lna_gain_400uv.png

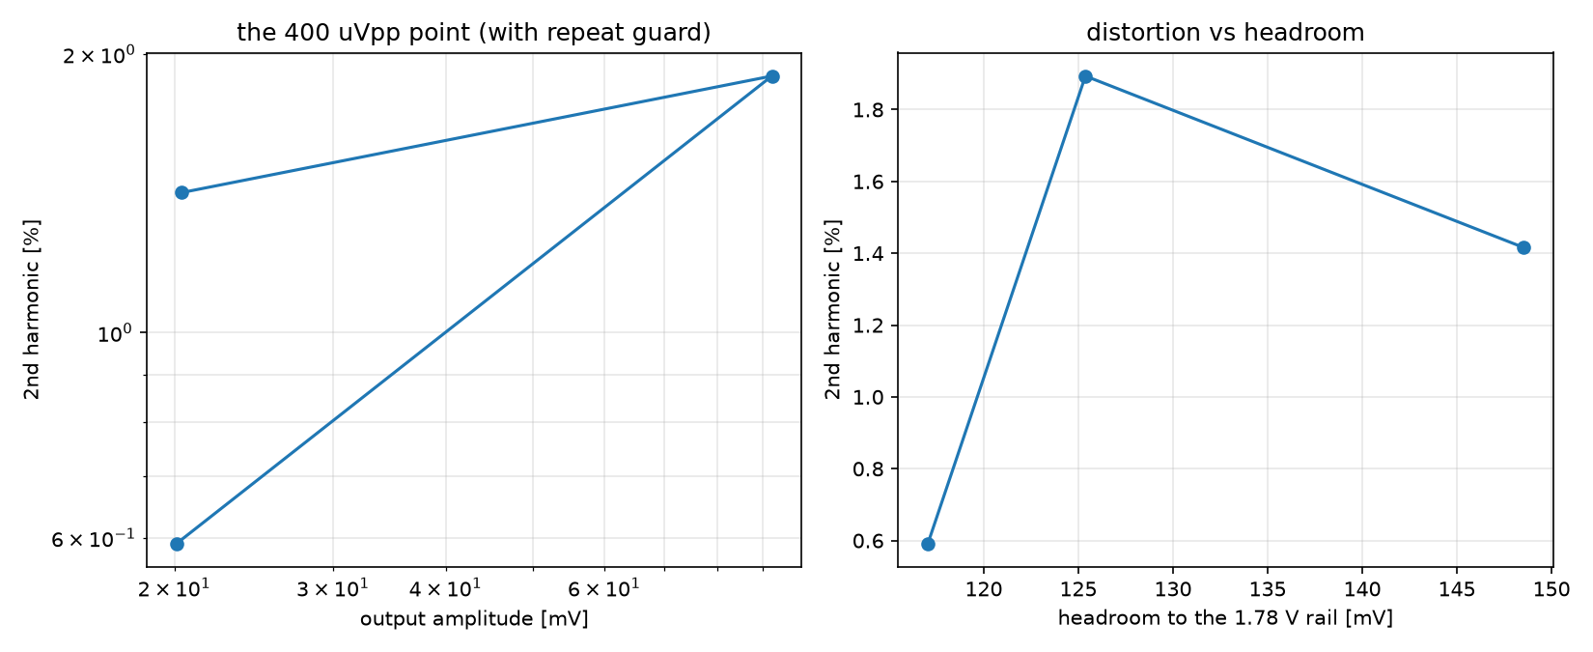
measurements/lna/figures/lna_gain_400uv.png
