federicohyo/OSCAR/measurements/lna/figures/lna_gain_vs_level.png

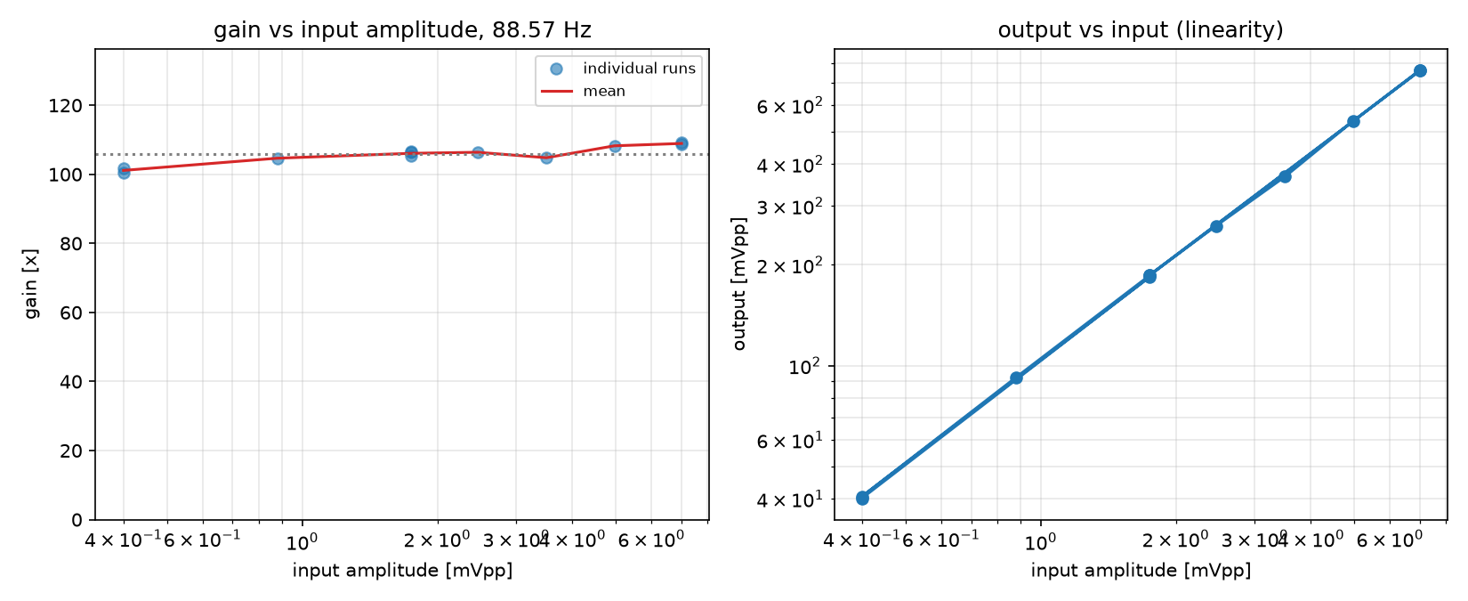
measurements/lna/figures/lna_gain_vs_level.png
