federicohyo/OSCAR/measurements/lna/figures/lna_noise.png

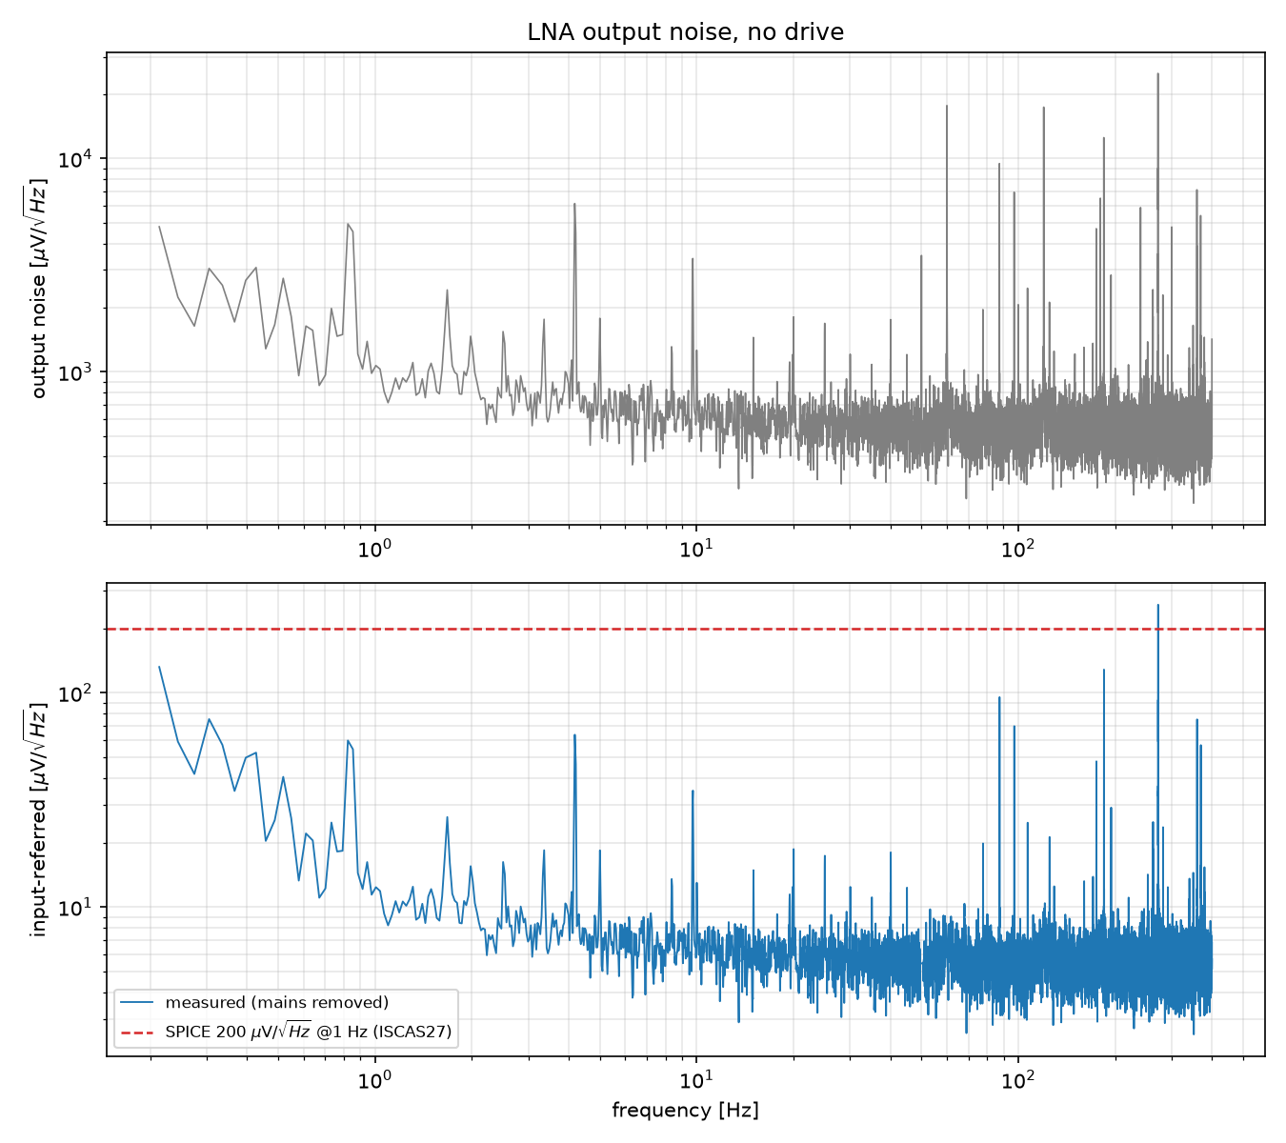
measurements/lna/figures/lna_noise.png
