federicohyo/OSCAR/measurements/lna/figures/lna_settling.png

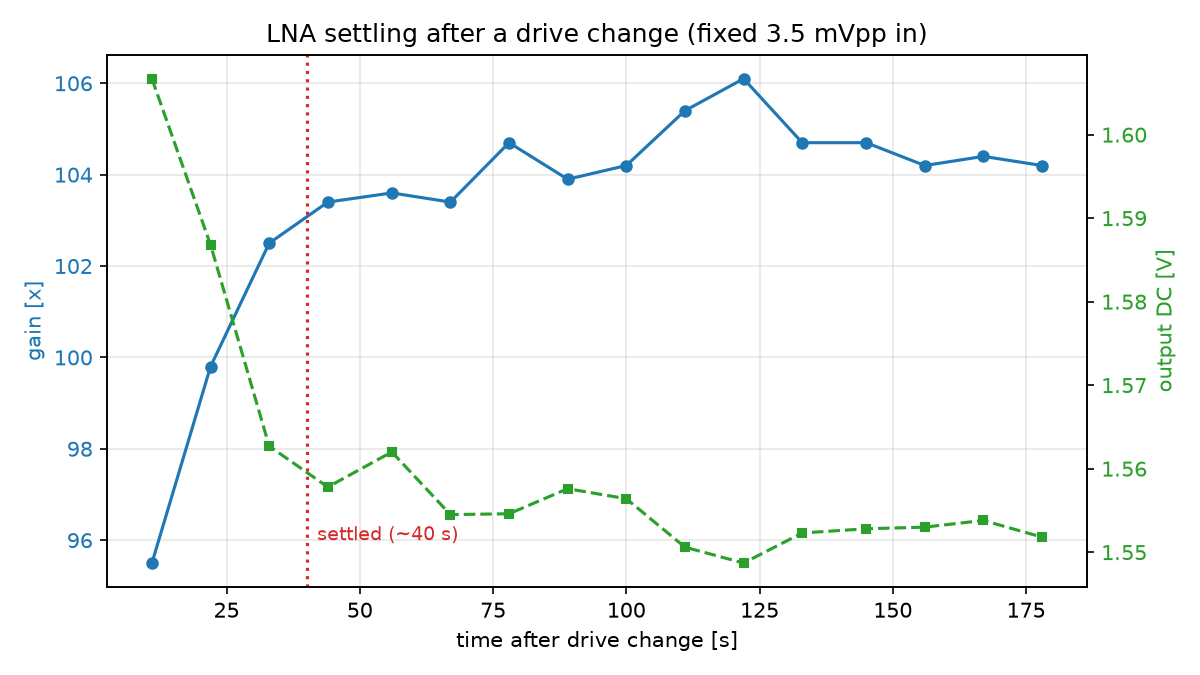
measurements/lna/figures/lna_settling.png
