federicohyo/OSCAR/measurements/lna/figures/lna_sim_vs_meas.png

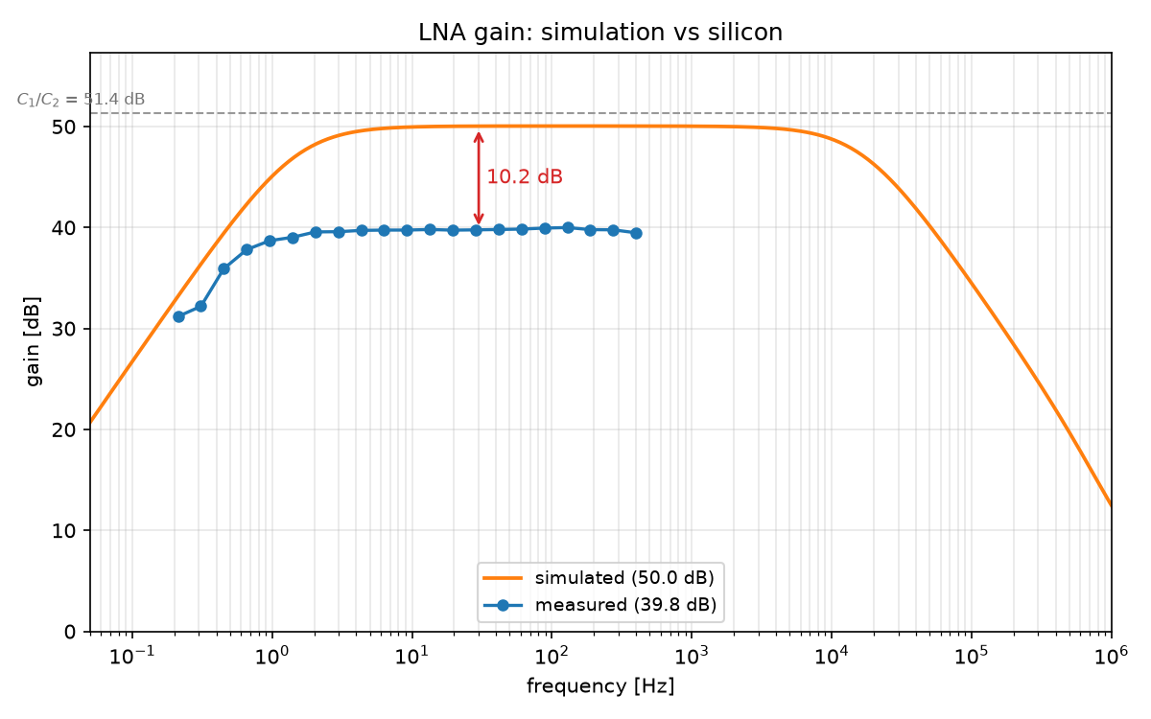
measurements/lna/figures/lna_sim_vs_meas.png
