federicohyo/OSCAR/measurements/lna/figures/lna_transfer_out.png

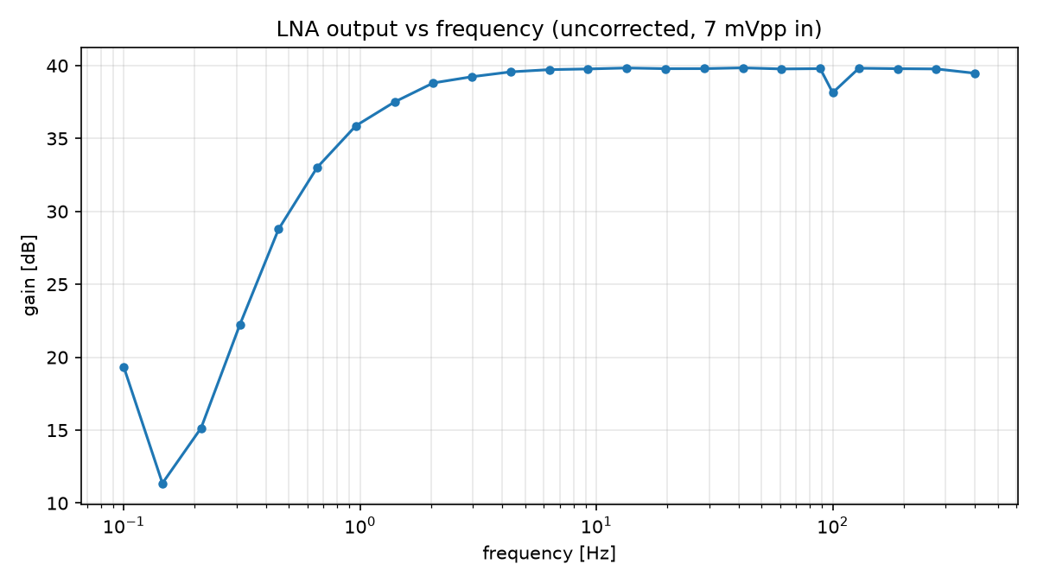
measurements/lna/figures/lna_transfer_out.png
