federicohyo/OSCAR/measurements/lna/figures/lna_transfer_ref.png

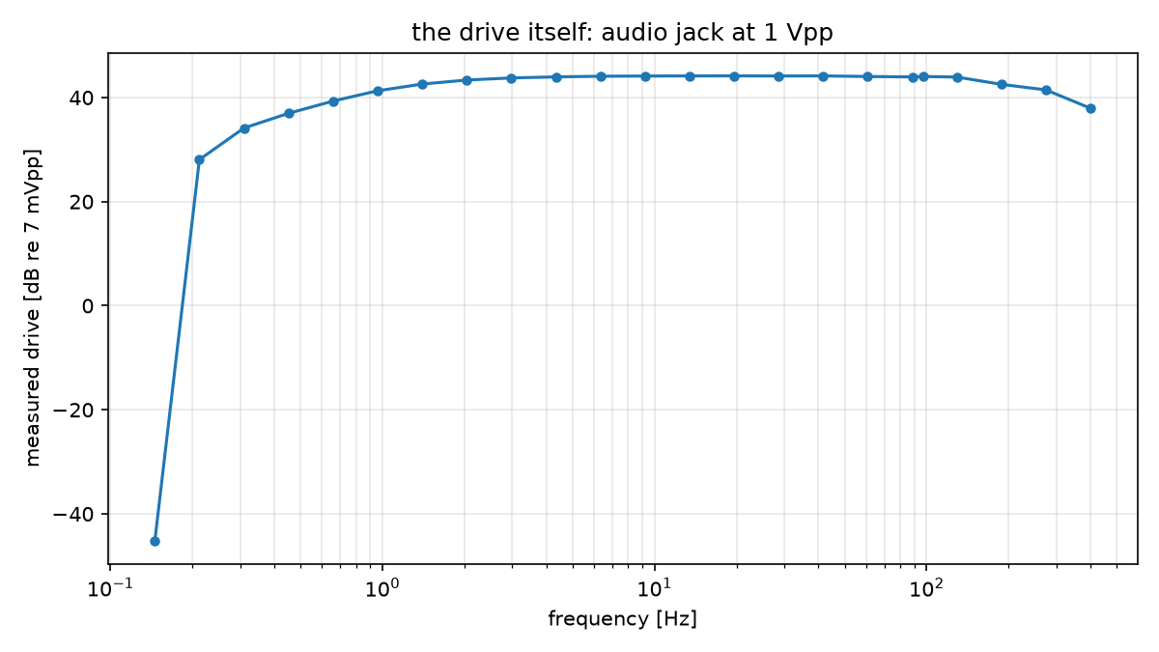
measurements/lna/figures/lna_transfer_ref.png
