federicohyo/OSCAR/measurements/lna/figures/odor_chain_dual.png

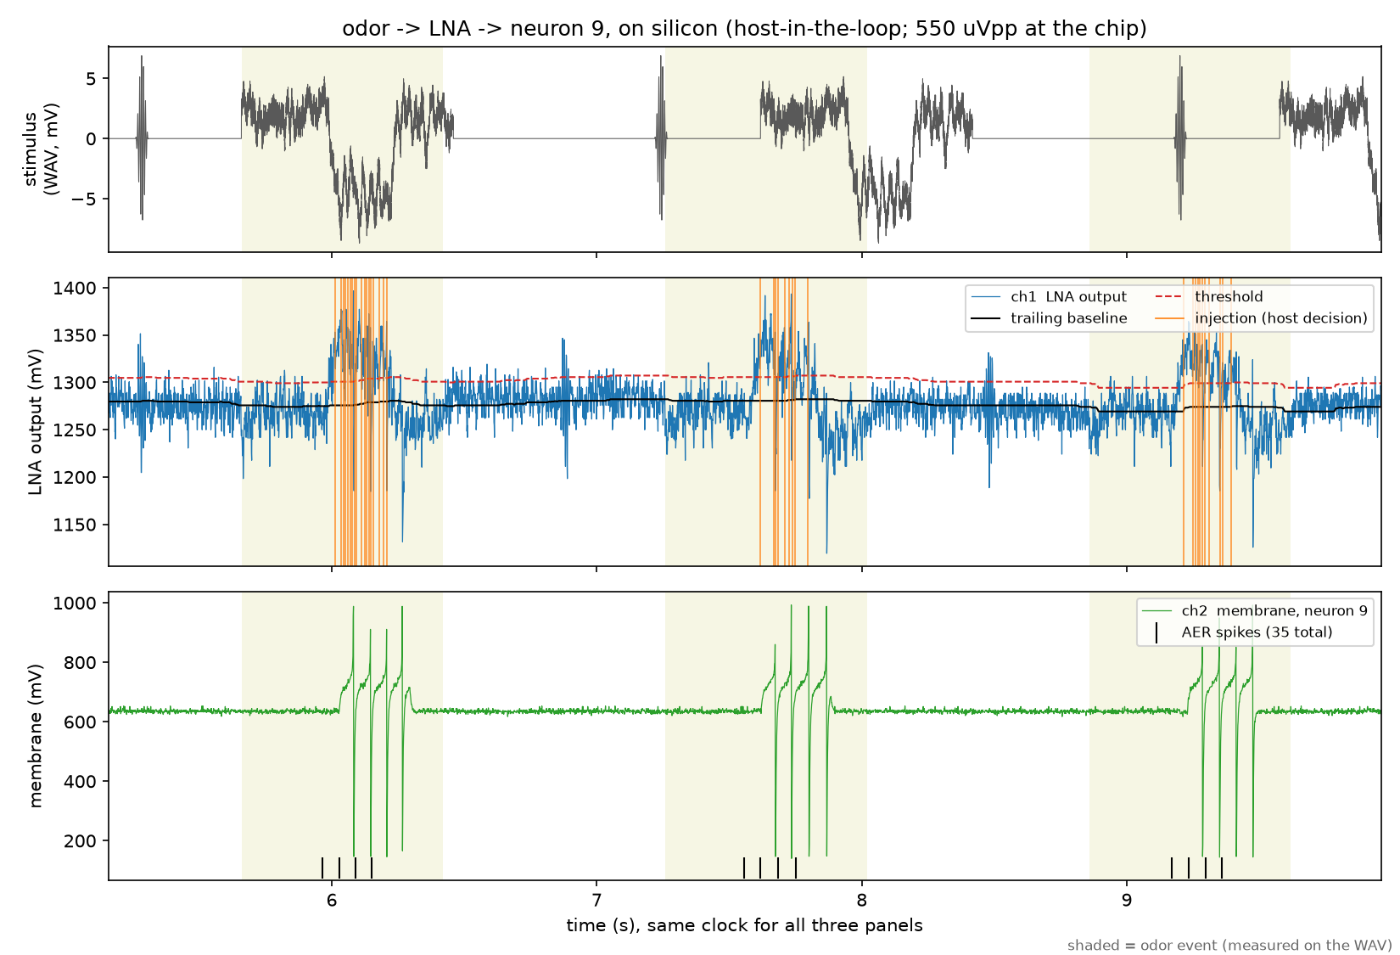
measurements/lna/figures/odor_chain_dual.png
