federicohyo/OSCAR/measurements/lna/figures/pad_evoked_chip1_n11.png

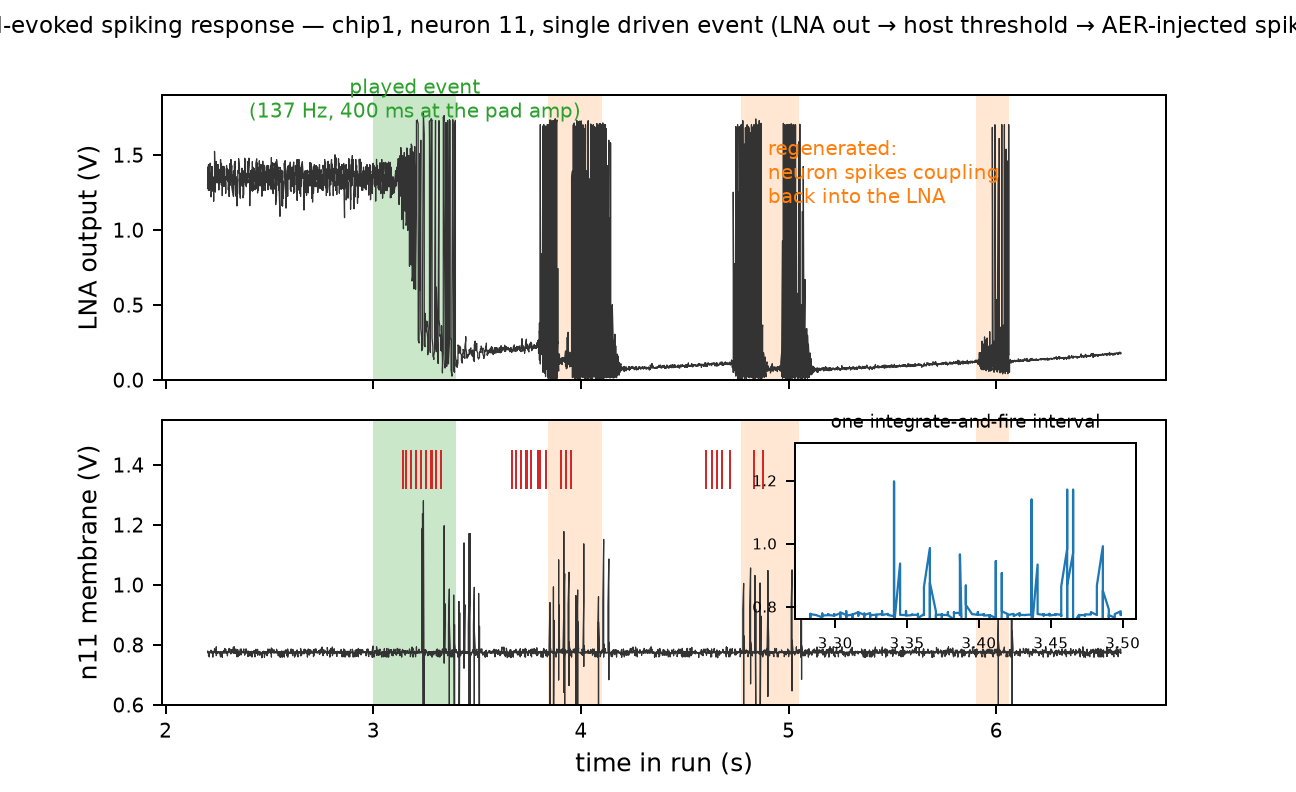
measurements/lna/figures/pad_evoked_chip1_n11.png
