federicohyo/OSCAR/measurements/lna/figures/pad_evoked_chip1_n11_saline.png

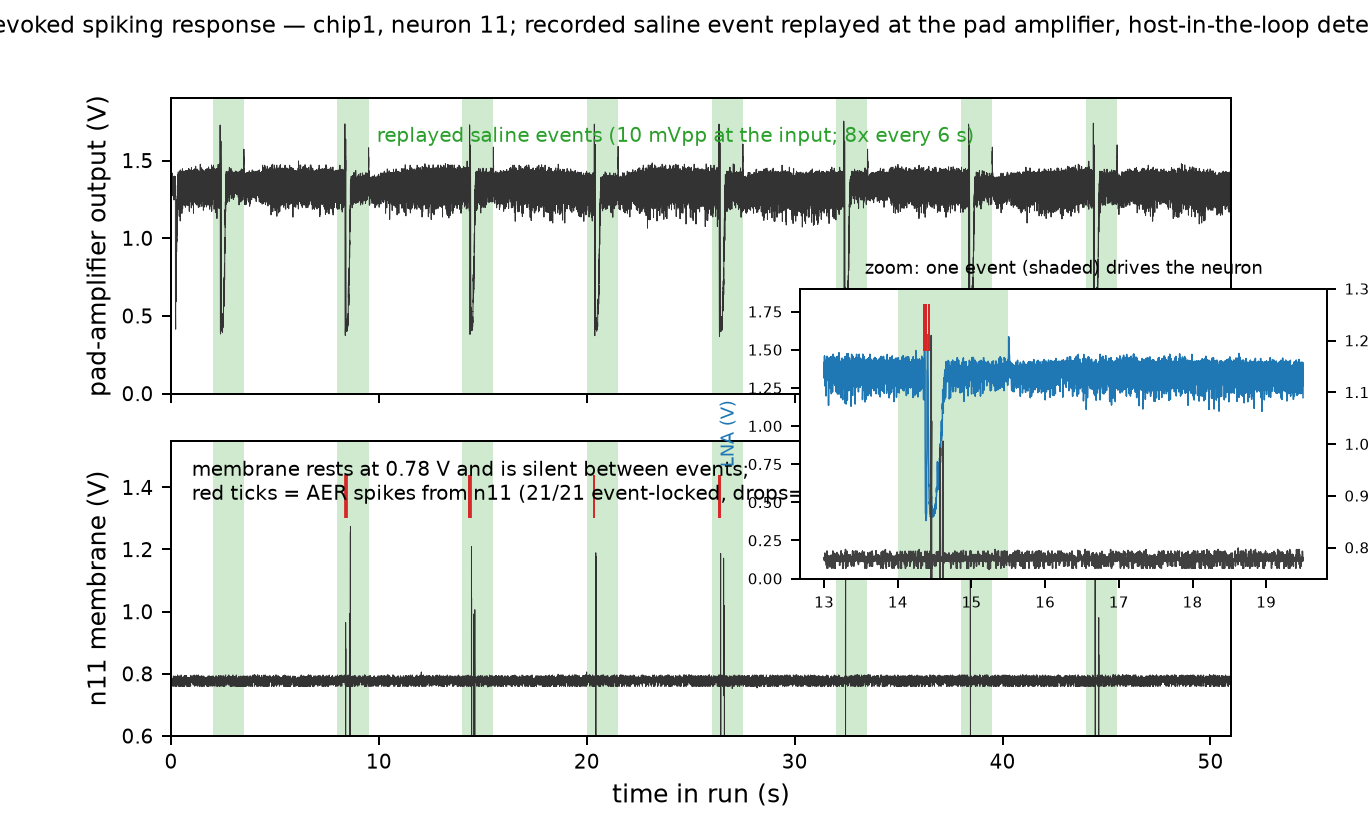
measurements/lna/figures/pad_evoked_chip1_n11_saline.png
