federicohyo/OSCAR/measurements/lna/figures/tio2_dilute3x.png

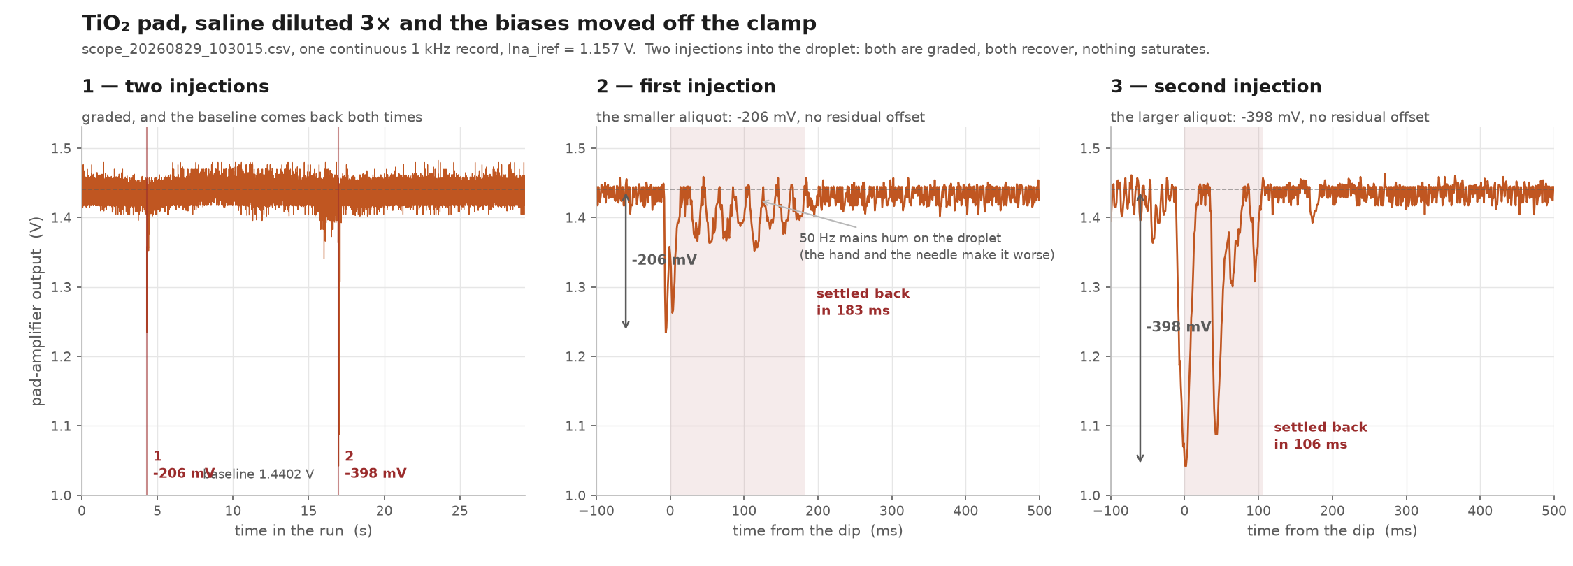
measurements/lna/figures/tio2_dilute3x.png
