federicohyo/OSCAR/measurements/lna/figures/tio2_injection_recovery.png

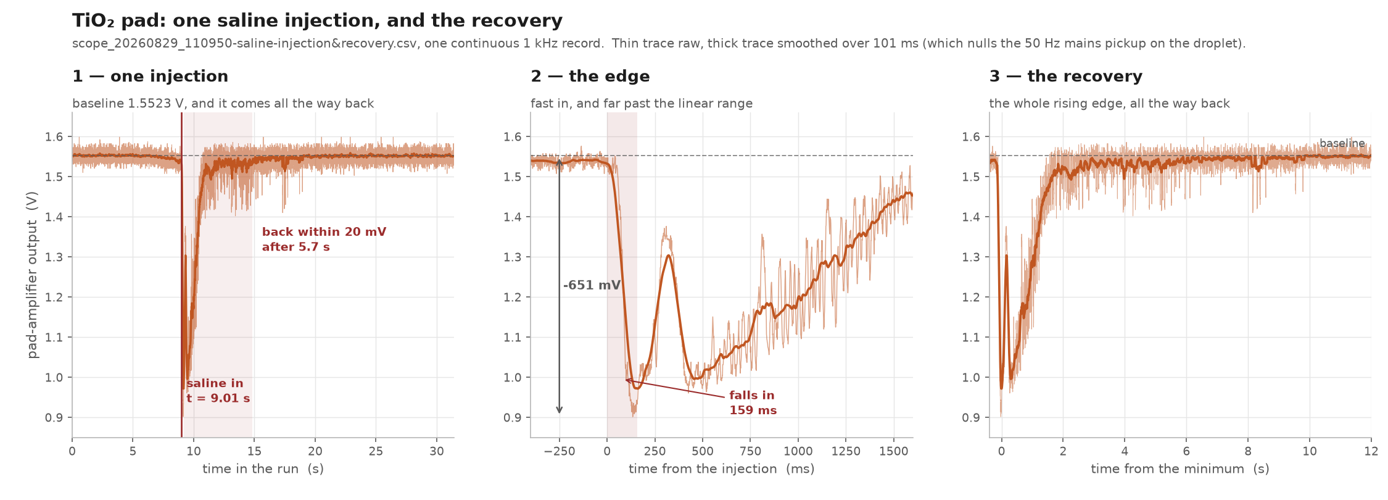
measurements/lna/figures/tio2_injection_recovery.png
