federicohyo/OSCAR/measurements/lna/figures/tio2_rerun_20260829_095121.png

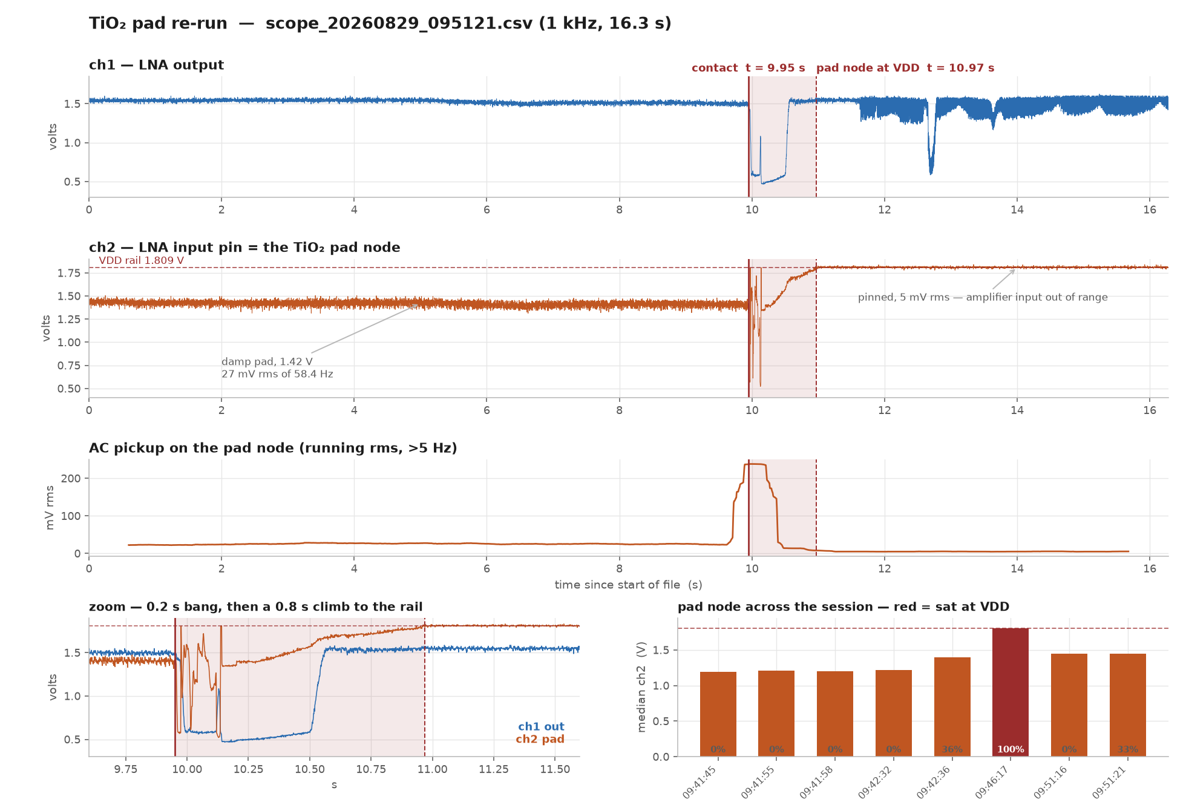
measurements/lna/figures/tio2_rerun_20260829_095121.png
