federicohyo/OSCAR/measurements/lna/figures/tio2_three_panel.png

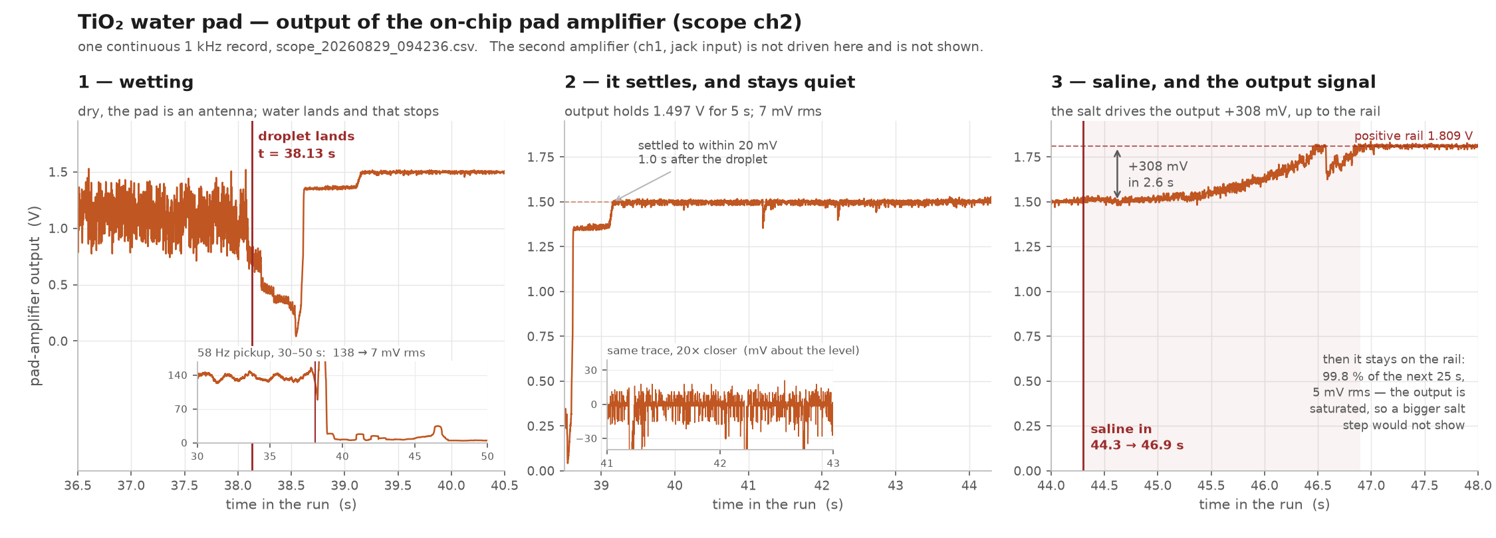
measurements/lna/figures/tio2_three_panel.png
