federicohyo/OSCAR/measurements/lna/figures/tio2_wetting_20260829_094236.png

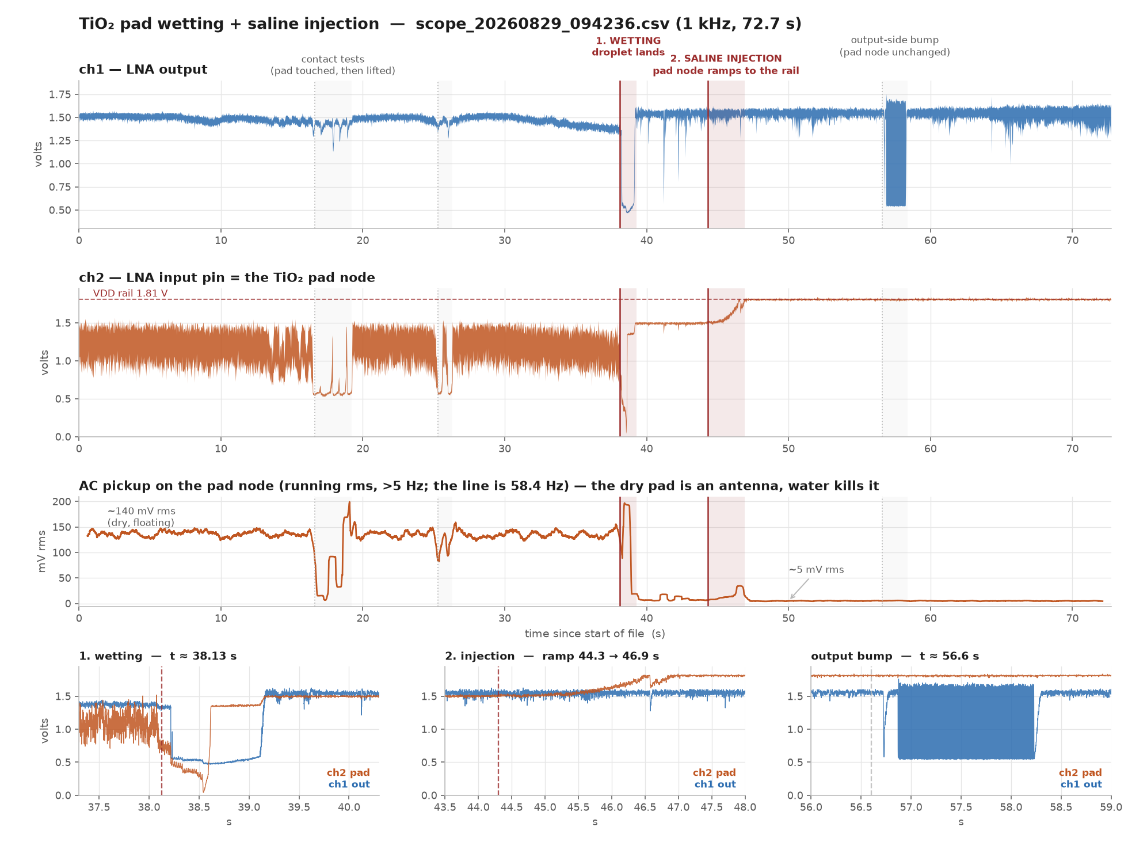
measurements/lna/figures/tio2_wetting_20260829_094236.png
