federicohyo/OSCAR/measurements/plotting/figures/aVLSIchip.png

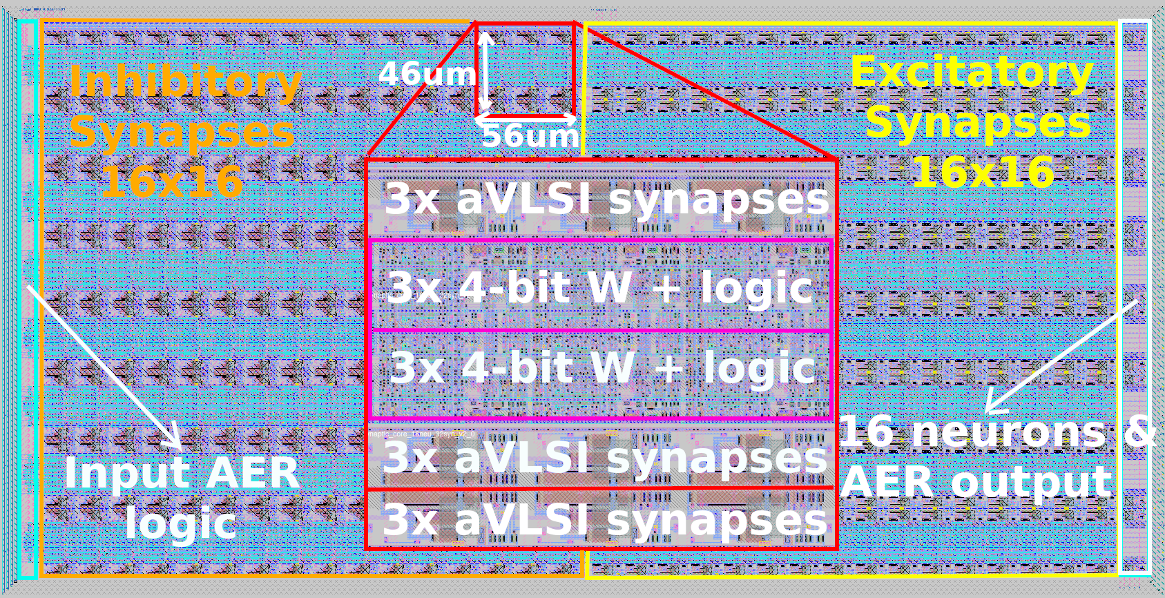
measurements/plotting/figures/aVLSIchip.png
