federicohyo/OSCAR/measurements/plotting/figures/coincidence_membrane.png

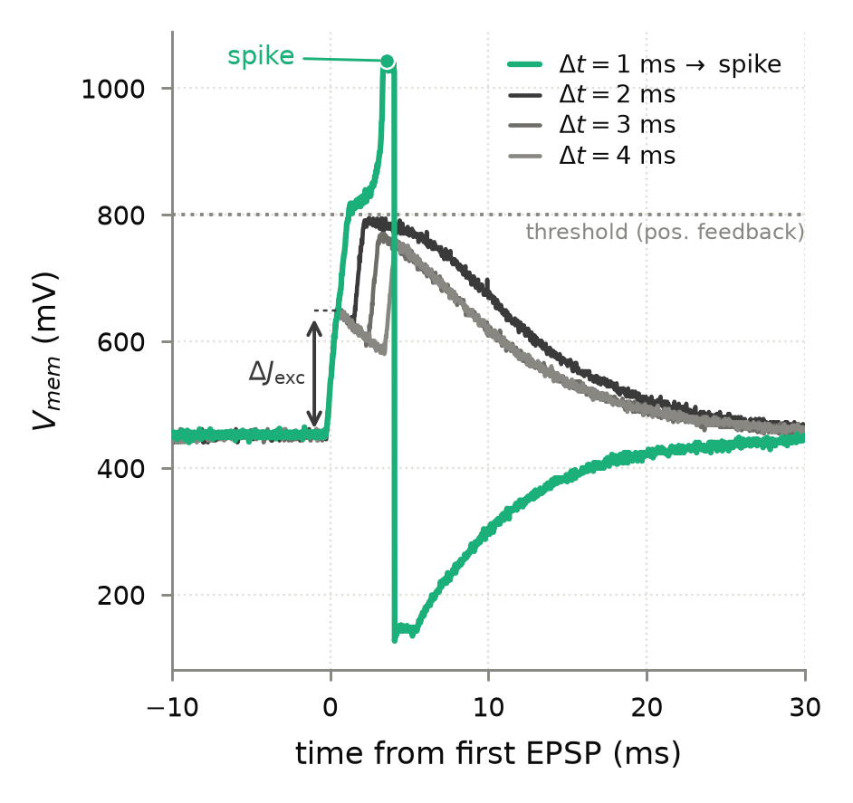
measurements/plotting/figures/coincidence_membrane.png
