federicohyo/OSCAR/measurements/plotting/figures/comparator_cal.png

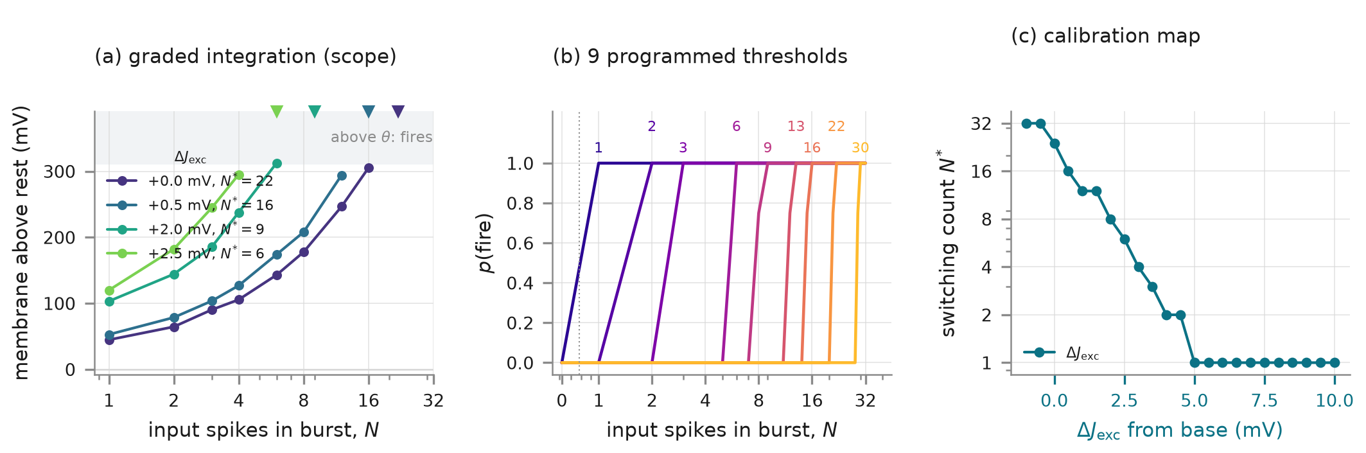
measurements/plotting/figures/comparator_cal.png
