federicohyo/OSCAR/measurements/plotting/figures/comparator_cal_ac.png

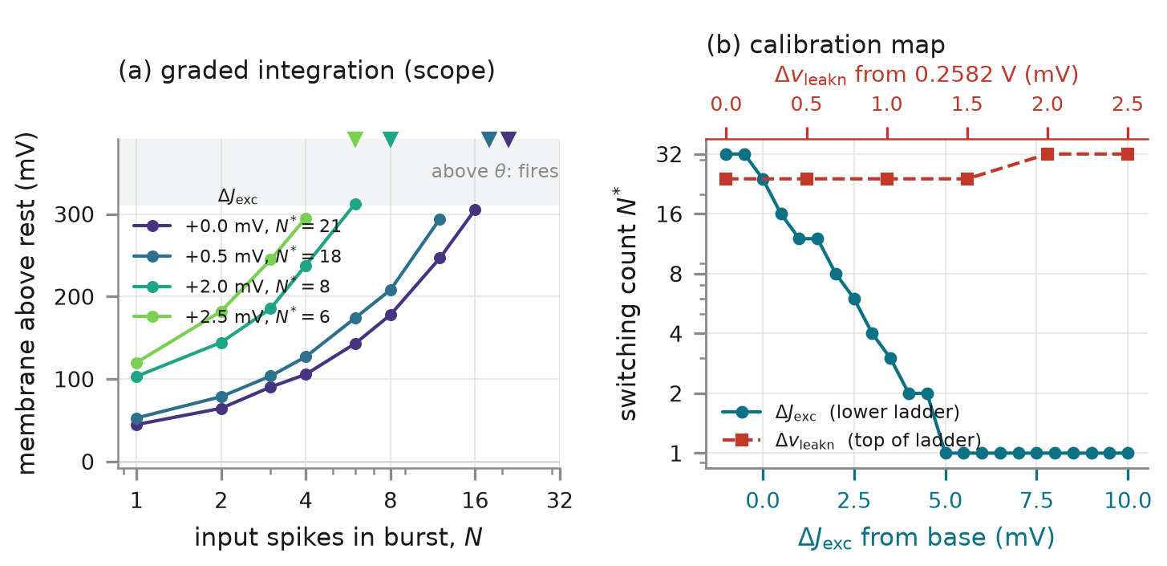
measurements/plotting/figures/comparator_cal_ac.png
