federicohyo/OSCAR/measurements/plotting/figures/comparator_cal_m.png

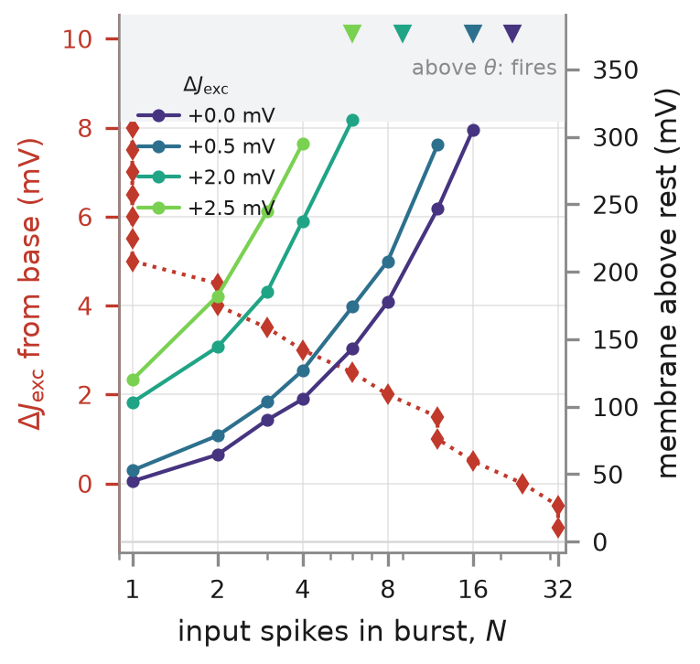
measurements/plotting/figures/comparator_cal_m.png
