federicohyo/OSCAR/measurements/plotting/figures/comparator_cal_pa.png

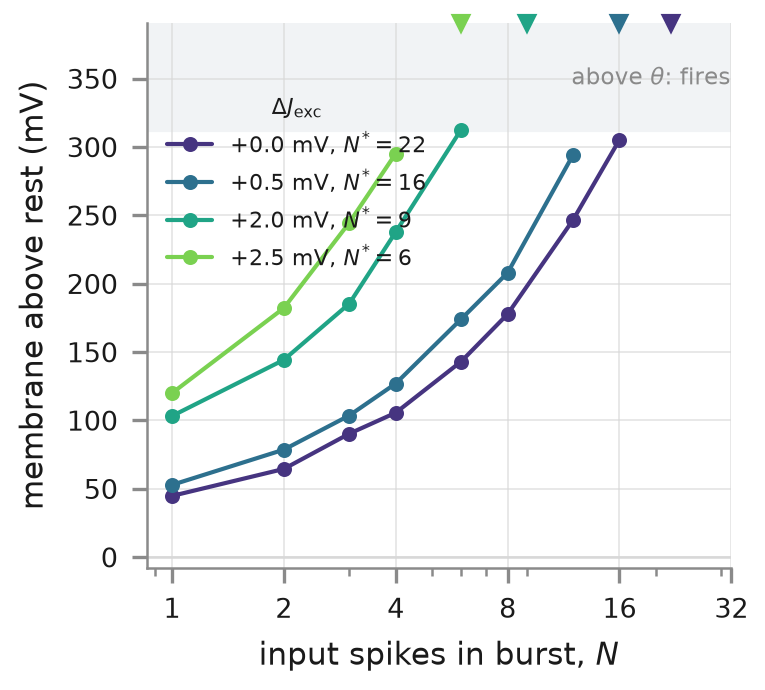
measurements/plotting/figures/comparator_cal_pa.png
