federicohyo/OSCAR/measurements/plotting/figures/comparator_cal_pb.png

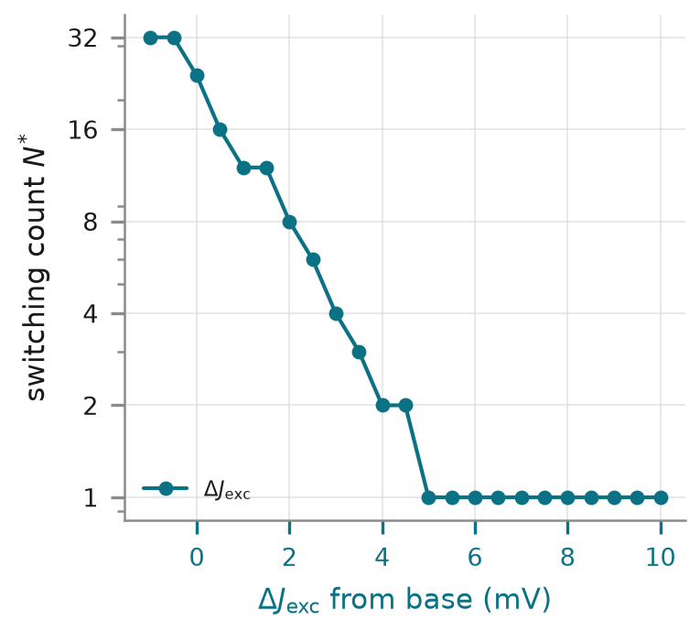
measurements/plotting/figures/comparator_cal_pb.png
