federicohyo/OSCAR/measurements/plotting/figures/comparator_drift2.png

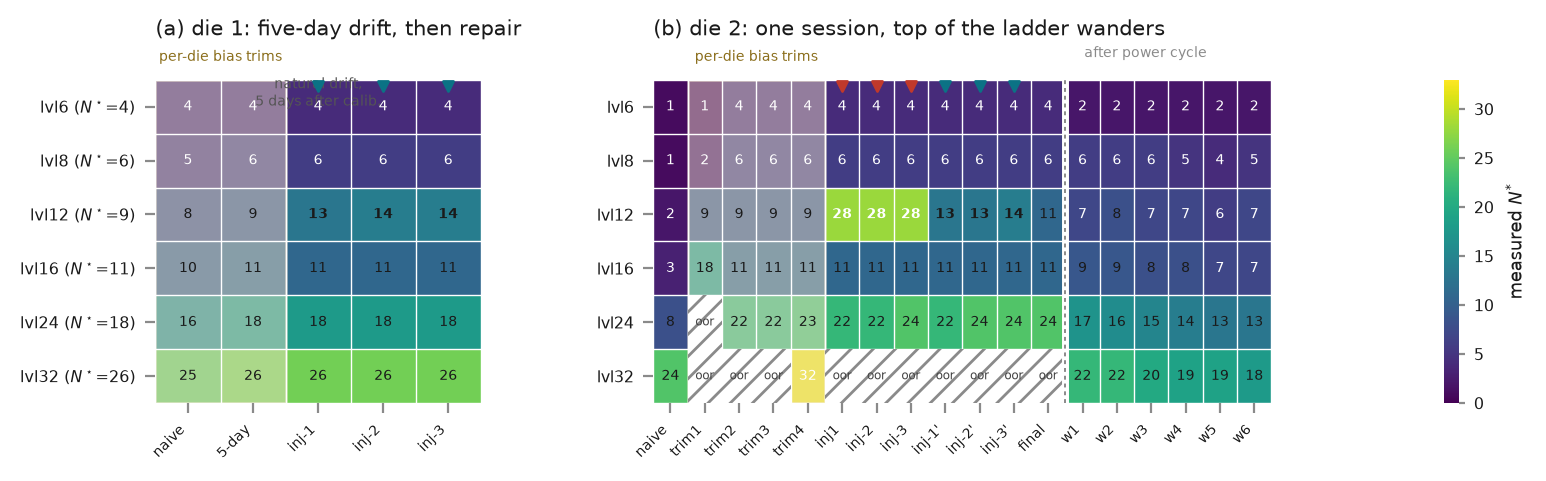
measurements/plotting/figures/comparator_drift2.png
