federicohyo/OSCAR/measurements/plotting/figures/comparator_drift2d.png

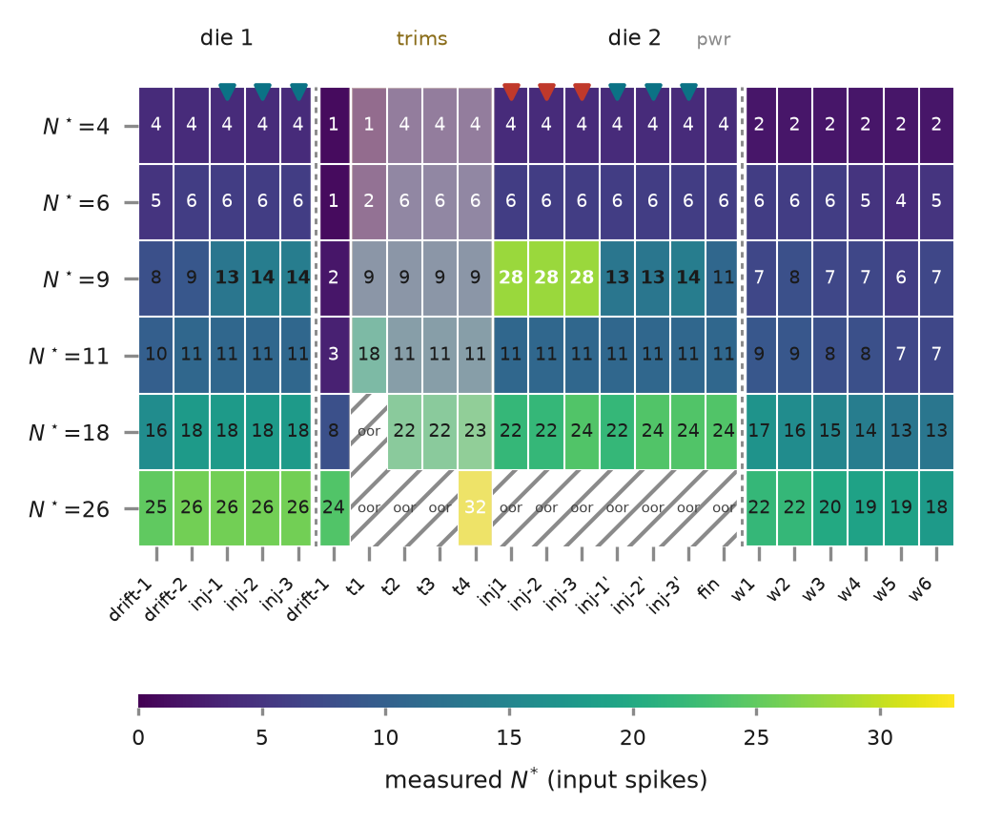
measurements/plotting/figures/comparator_drift2d.png
