federicohyo/OSCAR/measurements/plotting/figures/comparator_drift3d.png

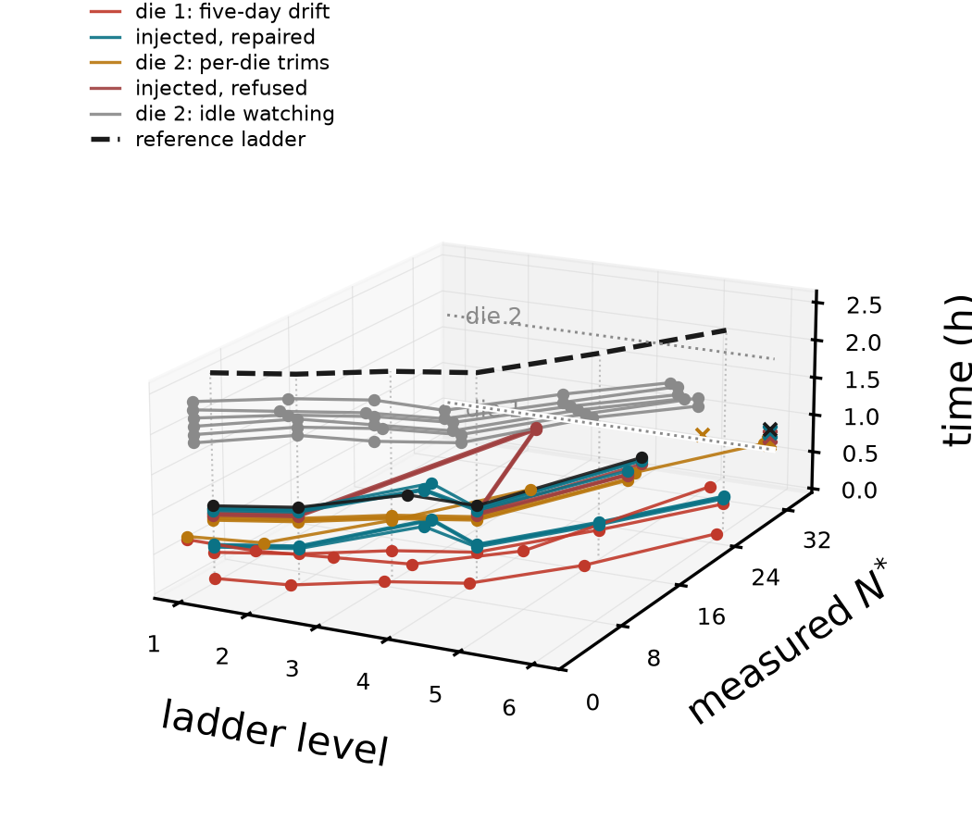
measurements/plotting/figures/comparator_drift3d.png
