federicohyo/OSCAR/measurements/plotting/figures/deff_decomp.png

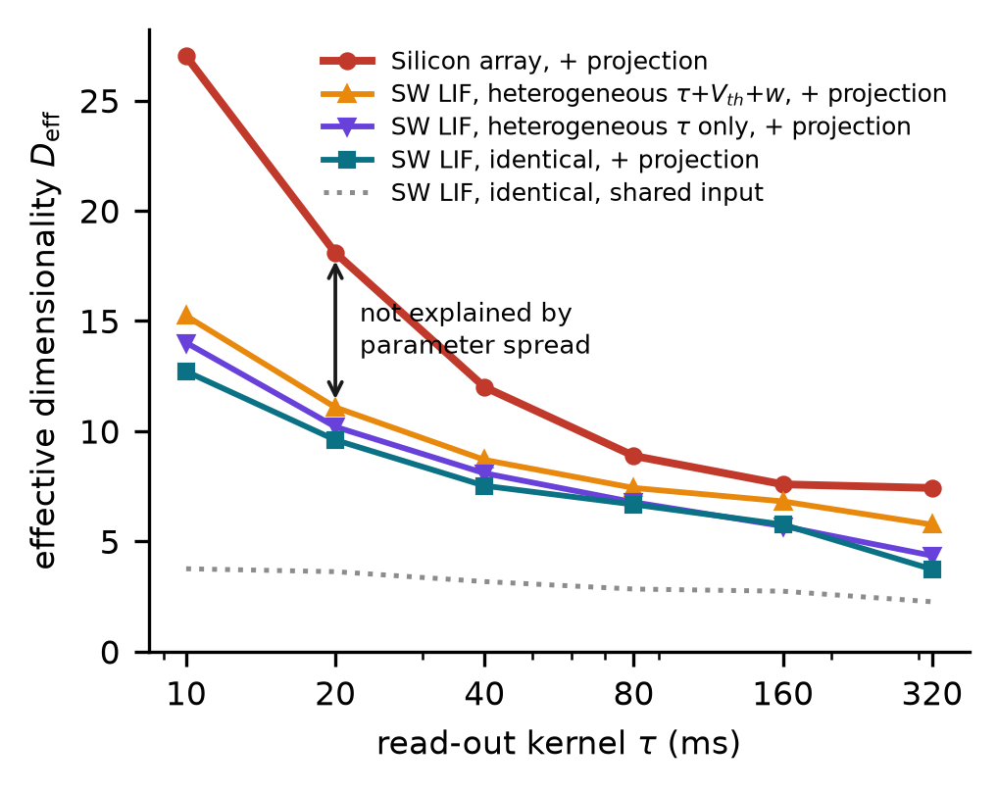
measurements/plotting/figures/deff_decomp.png
