federicohyo/OSCAR/measurements/plotting/figures/deff_decomp_v2.png

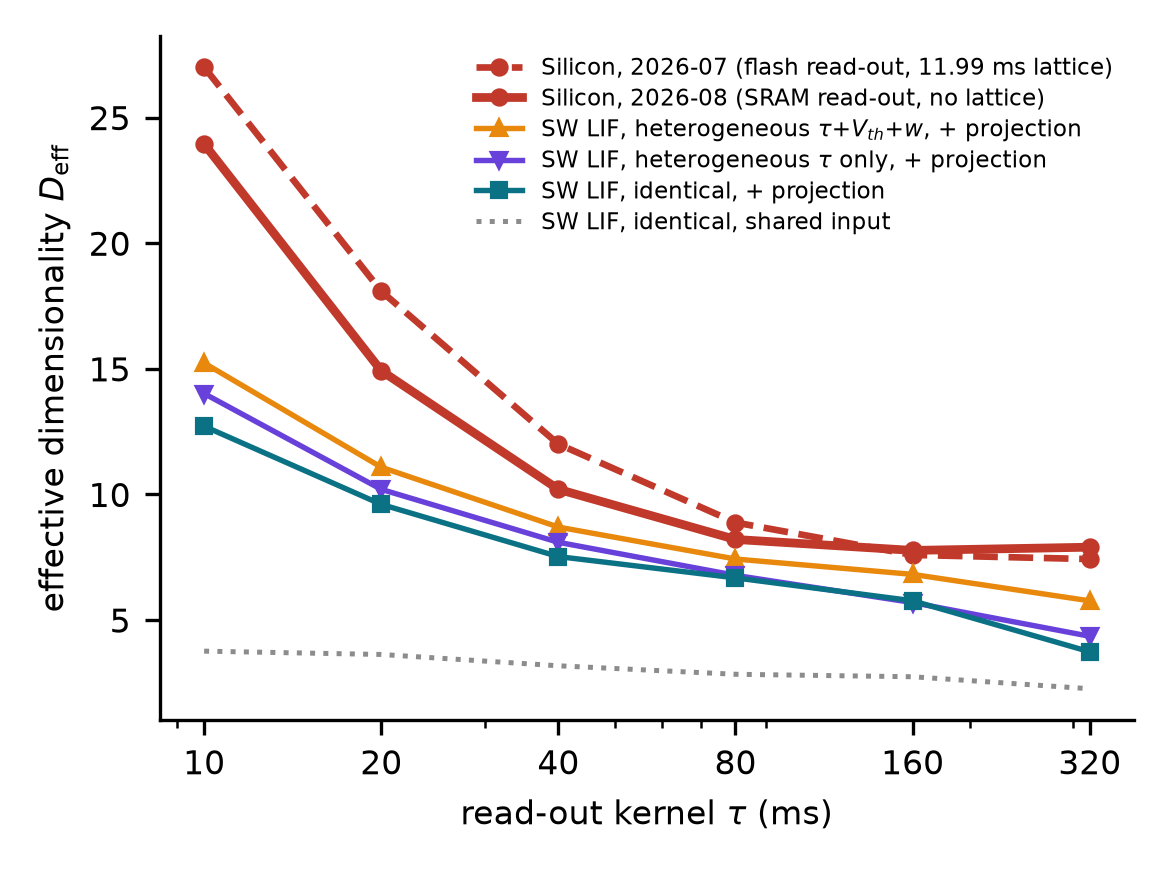
measurements/plotting/figures/deff_decomp_v2.png
