federicohyo/OSCAR/measurements/plotting/figures/deff_decomp_v3.png

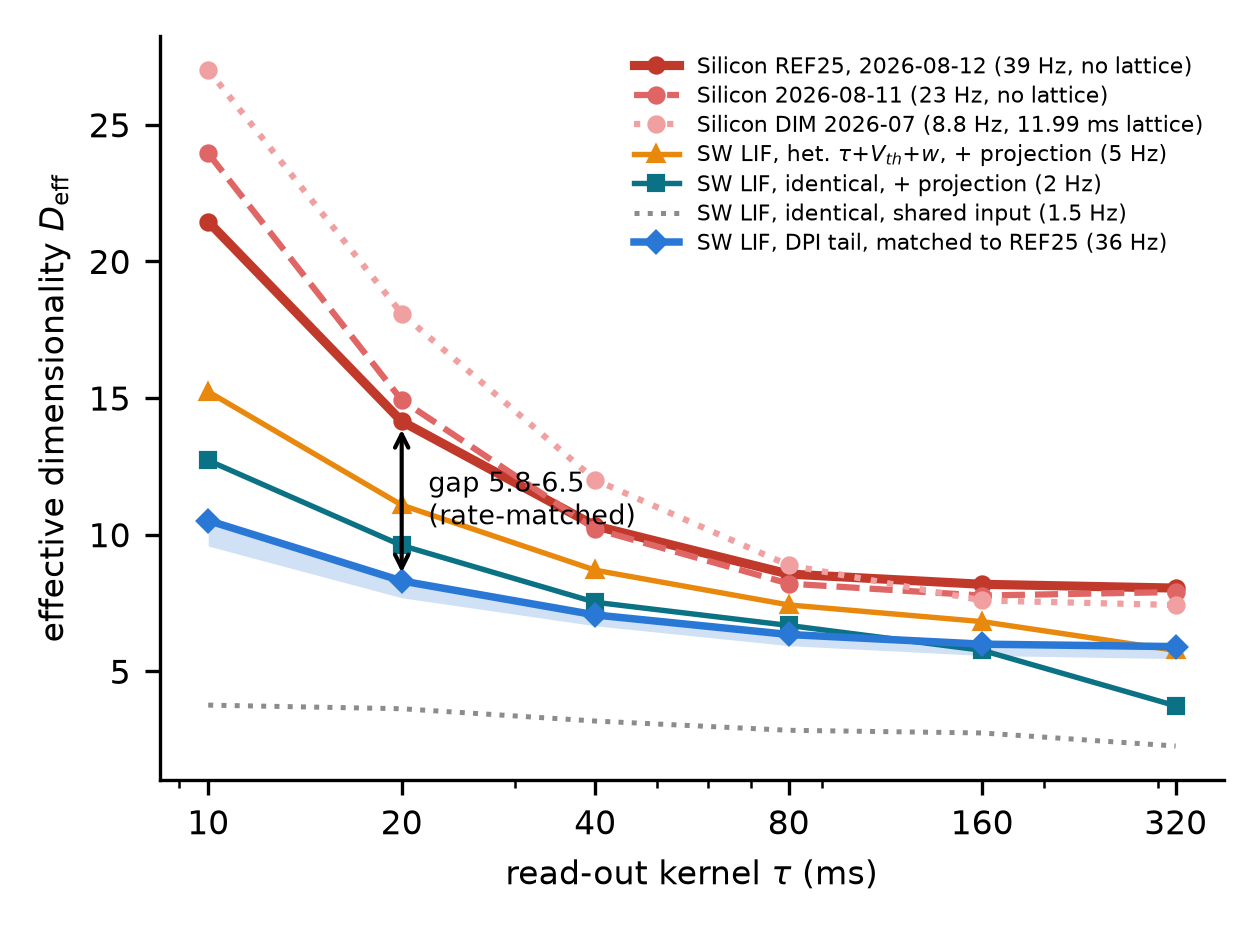
measurements/plotting/figures/deff_decomp_v3.png
