federicohyo/OSCAR/measurements/plotting/figures/ecg_frontier.png

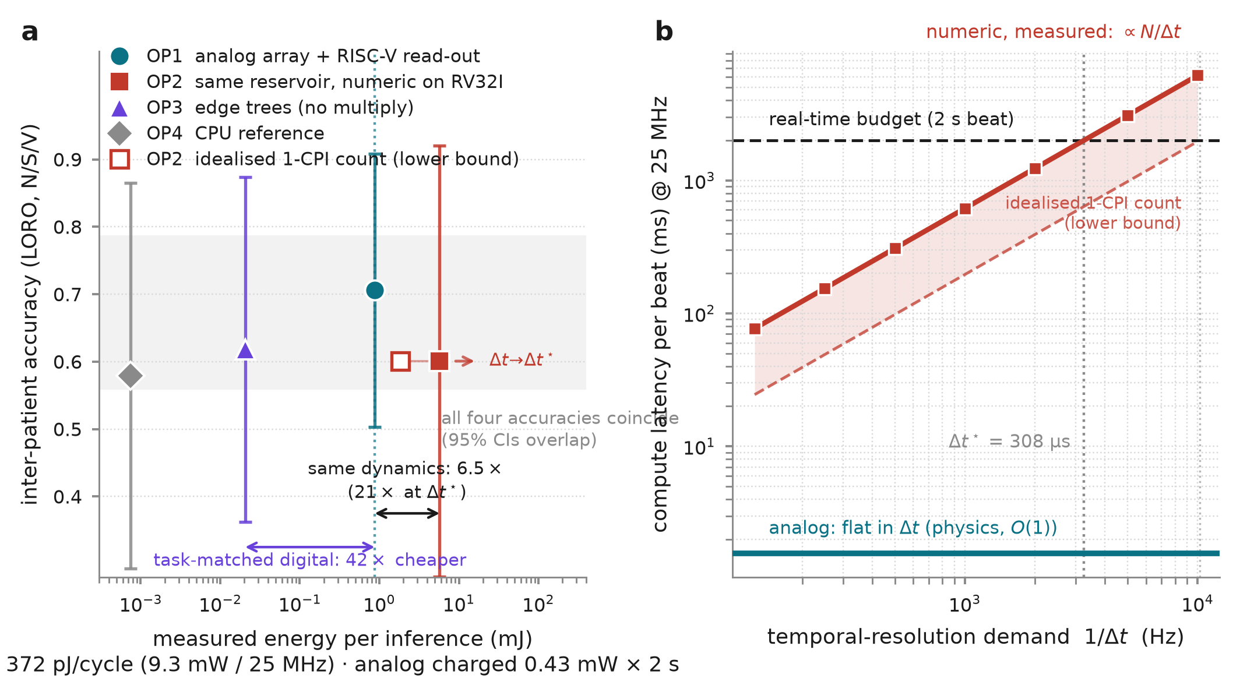
measurements/plotting/figures/ecg_frontier.png
