federicohyo/OSCAR/measurements/plotting/figures/netarch.png

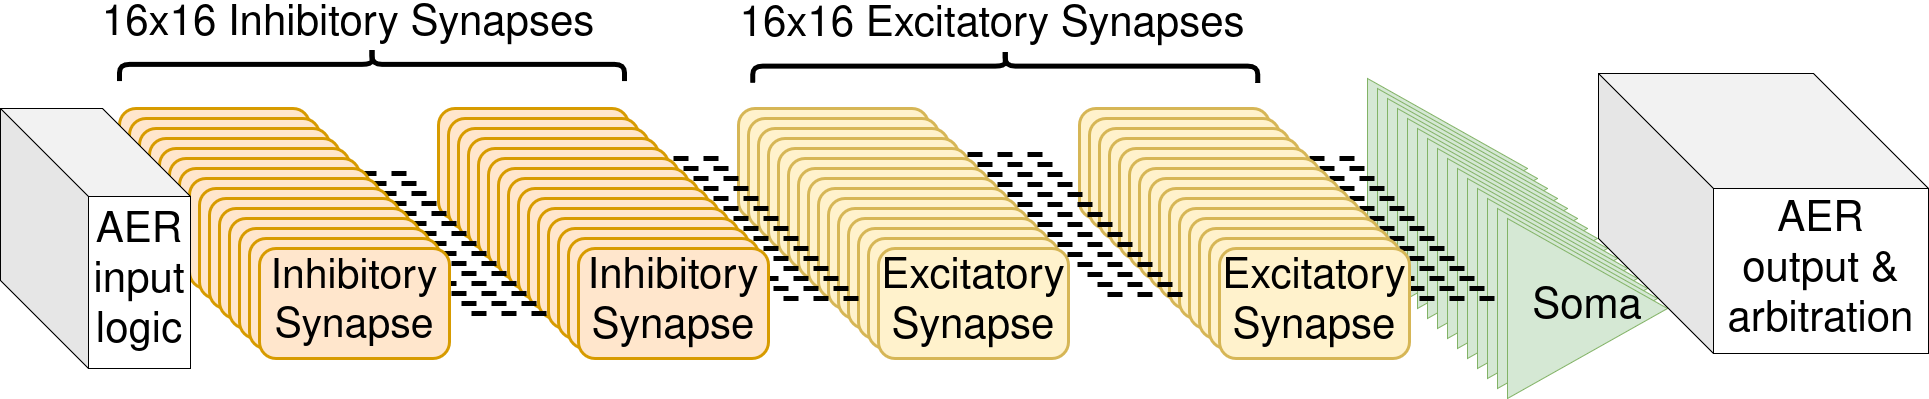
measurements/plotting/figures/netarch.png
