federicohyo/OSCAR/measurements/plotting/figures/olfaction_capacity.png

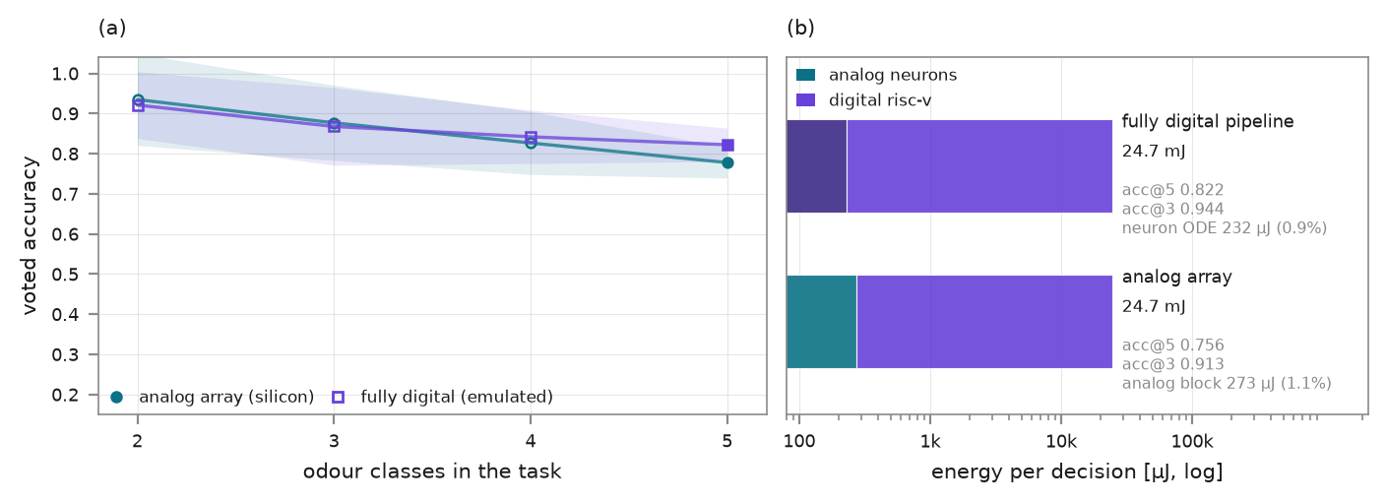
measurements/plotting/figures/olfaction_capacity.png
