federicohyo/OSCAR/measurements/plotting/figures/olfaction_scaling.png

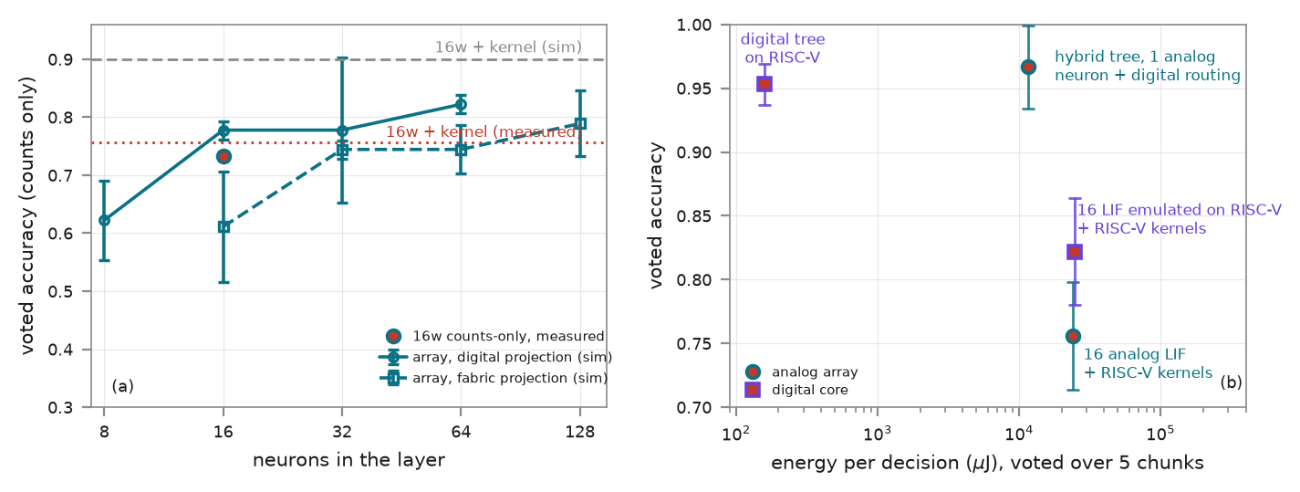
measurements/plotting/figures/olfaction_scaling.png
