federicohyo/OSCAR/measurements/plotting/figures/olfaction_scaling_b.png

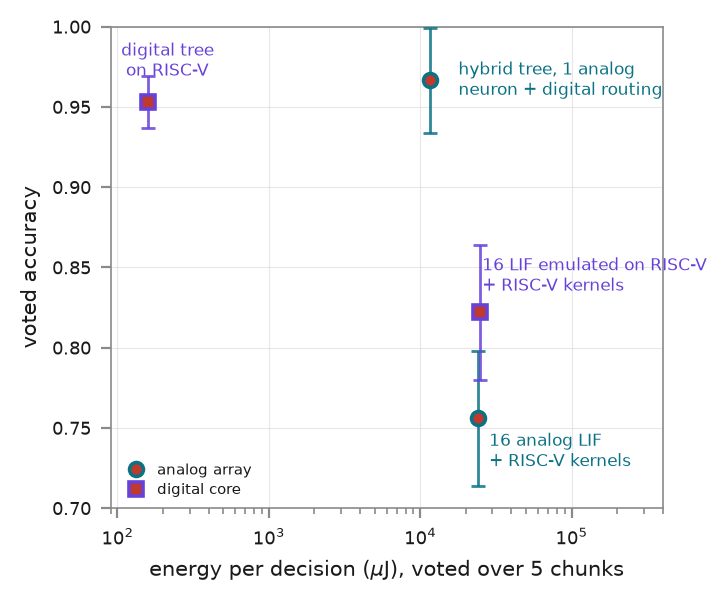
measurements/plotting/figures/olfaction_scaling_b.png
