federicohyo/OSCAR/measurements/plotting/figures/syn_dpi_exc_aVLSI.png

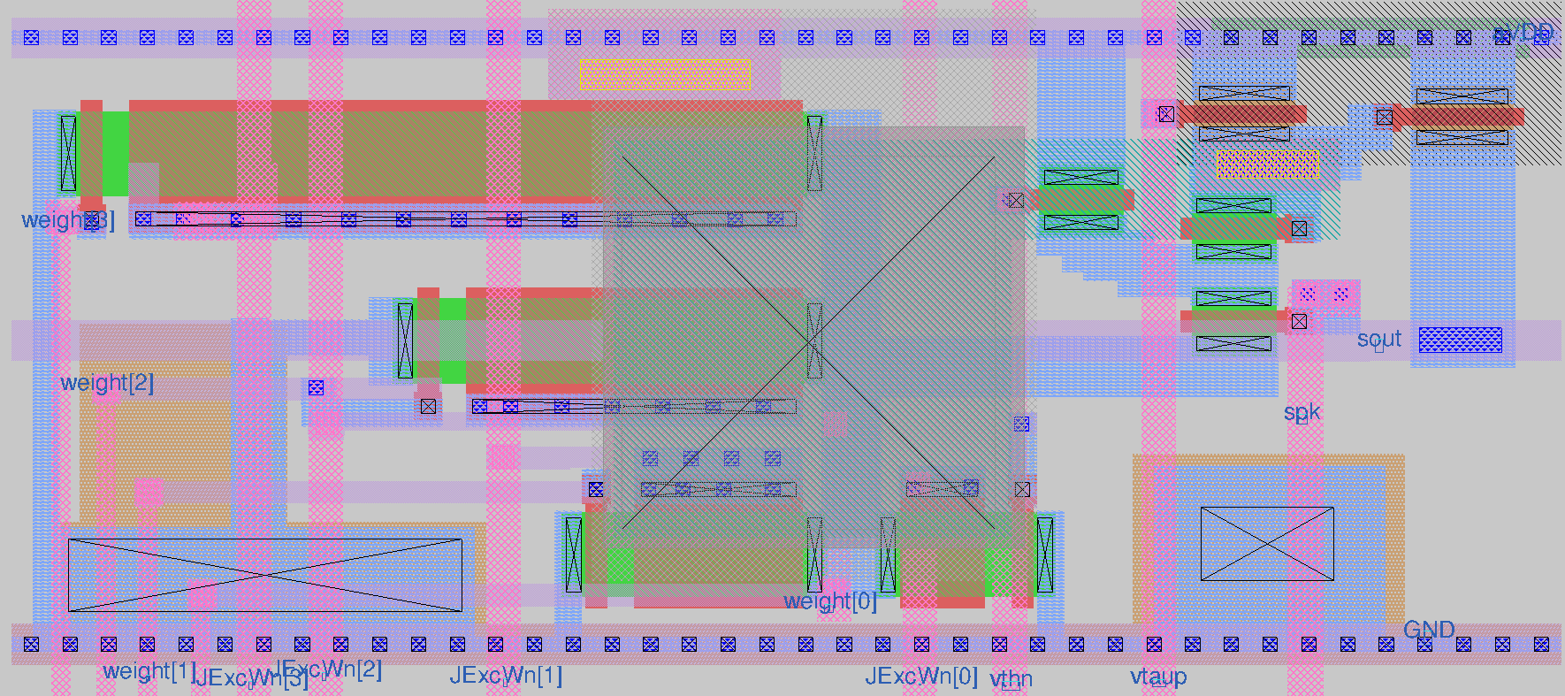
measurements/plotting/figures/syn_dpi_exc_aVLSI.png
