federicohyo/OSCAR/measurements/wet_pad/figures/fig16_tio2_wetting.png

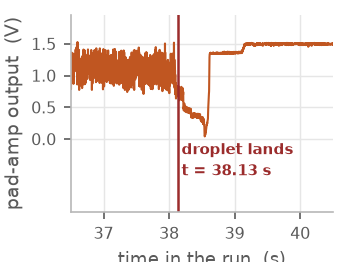
measurements/wet_pad/figures/fig16_tio2_wetting.png
