federicohyo/OSCAR/measurements/lna/clean_2026-08-26/debug/02_new_divider_level_sweep.csv

freq_hz | jack_vpp | vin_pp | vout_pp | gain | dc_v | peak_v | h2 | h3 | amp_se_v | flag
88.57 | 0.00600 | 0.000400 | 0.010606 | 26.51 | 1.7010 | 1.7063 | 0.0553 | 0.0653 | 0.000449
88.57 | 0.01319 | 0.000880 | 0.022180 | 25.21 | 1.6993 | 1.7104 | 0.0145 | 0.0225 | 0.000448
88.57 | 0.02624 | 0.001750 | 0.046196 | 26.40 | 1.6963 | 1.7194 | 0.0468 | 0.0093 | 0.000483
88.57 | 0.05247 | 0.003500 | 0.092694 | 26.48 | 1.6903 | 1.7367 | 0.0577 | 0.0048 | 0.000466
88.57 | 0.00600 | 0.000400 | 0.010611 | 26.53 | 1.6960 | 1.7013 | 0.2159 | 0.1161 | 0.000574
