federicohyo/OSCAR/docs/figures/arch_overview.pdf

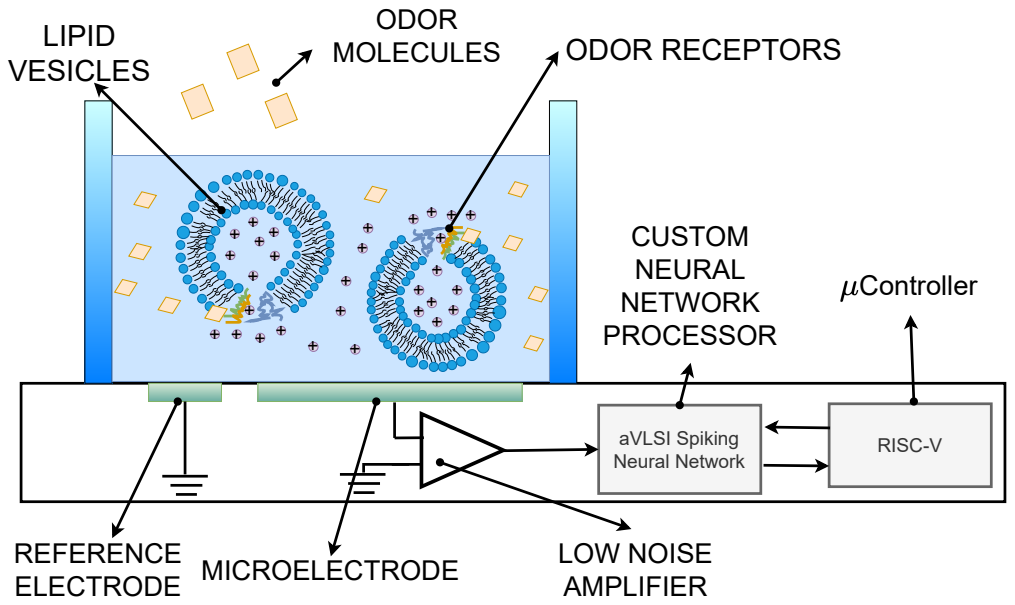
[picture p71: page 1]
MICROELECTRODE REFERENCE ELECTRODE; LOW NOISE AMPLIFIER; ODOR MOLECULES; CUSTOM NEURAL NETWORK PROCESSOR; Controller; LIPID; VESICLES; ODOR RECEPTORS

RISC-V aVLSI Spiking
Neural Network
