federicohyo/OSCAR/measurements/array/figures/neuron_fi_reference.pdf

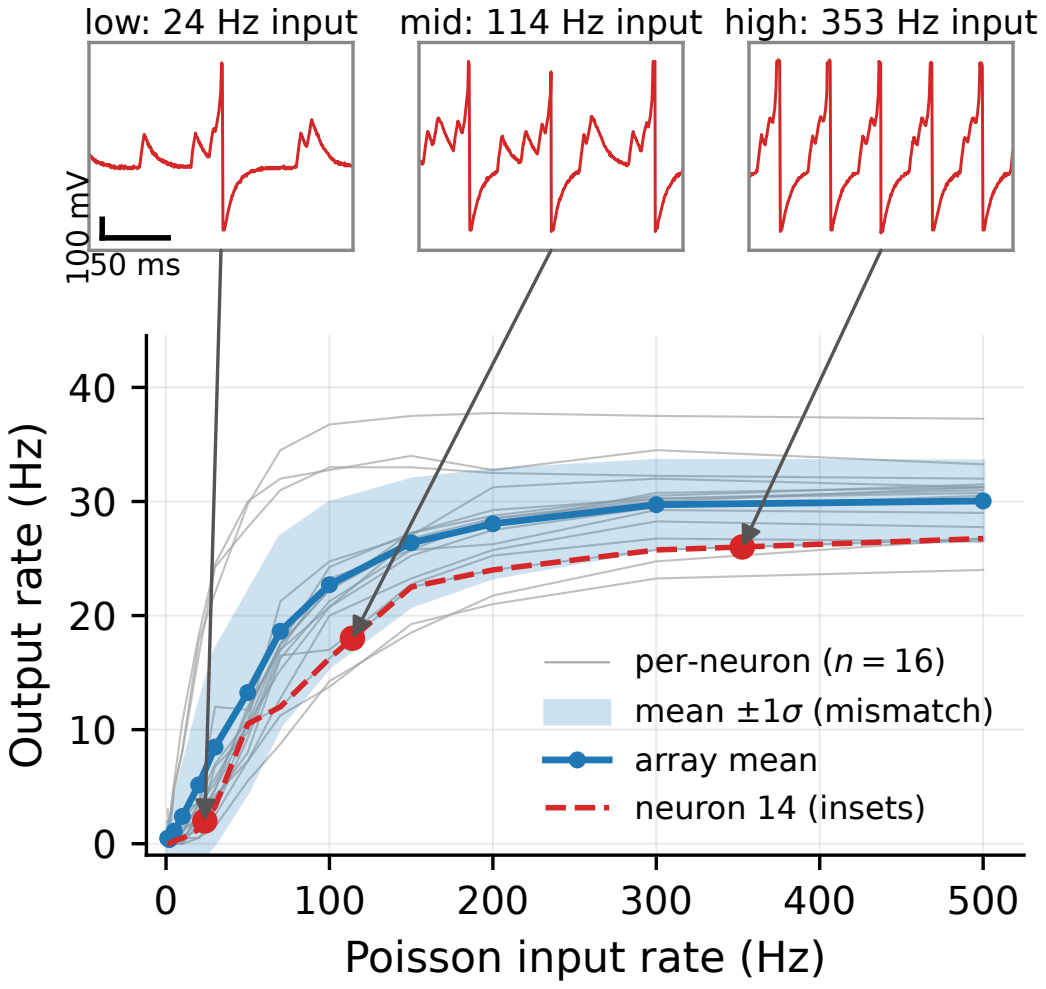
[picture p72: page 1]
mean ±1σ (mismatch)

low: 24 Hz input mid: 114 Hz input high: 353 Hz input

Output rate (Hz)

per-neuron (n = 16)

array mean neuron 14 (insets)

Poisson input rate (Hz)
