federicohyo/OSCAR/measurements/lna/figures/lna_gain_vs_level.pdf

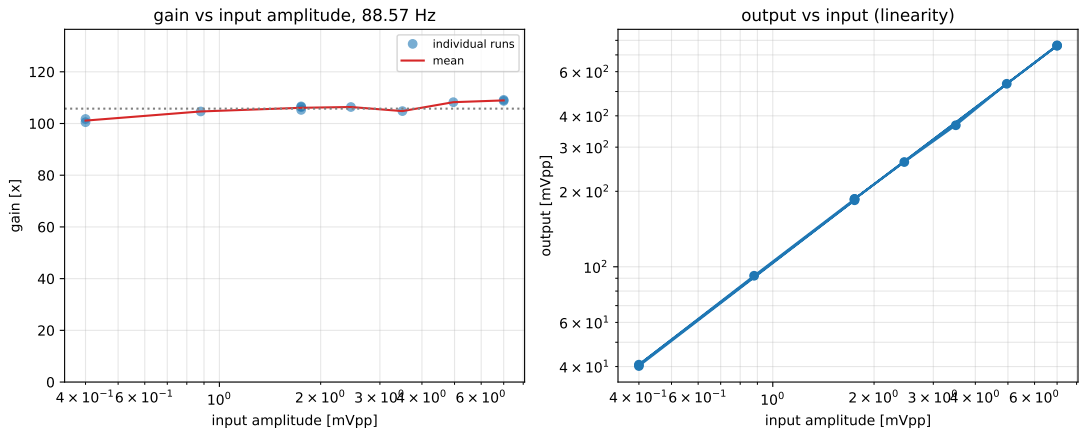
[picture p73: page 1]
gain [x]; individual runs mean; output [mVpp]

gain vs input amplitude, 88.57 Hz

output vs input (linearity)

input amplitude [mVpp]
