federicohyo/OSCAR/measurements/plotting/figures/coincidence_frontier.pdf

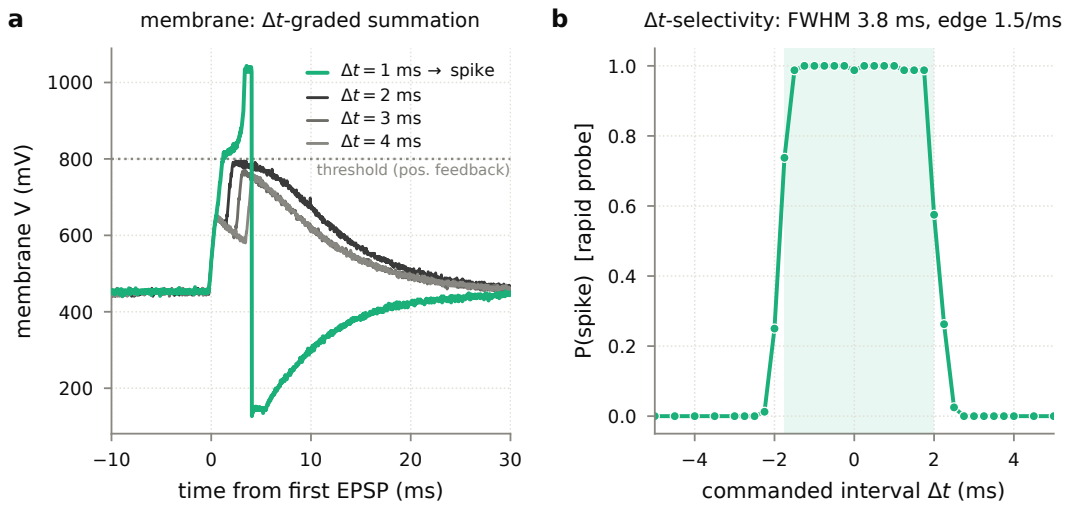
[picture p74: page 1]
membrane V (mV); membrane: Δt-graded summation; Δt-selectivity: FWHM 3.8 ms, edge 1.5/ms

Δt = 1 ms → spike

P(spike) [rapid probe]

threshold (pos. feedback)

commanded interval Δt (ms)

time from first EPSP (ms)
