federicohyo/OSCAR/measurements/plotting/figures/comparator_cal.pdf

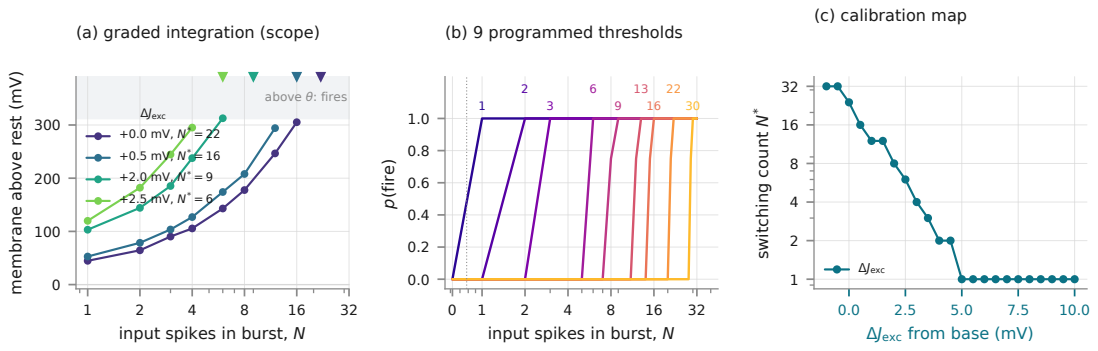
[picture p75: page 1]
above θ: fires; ΔJexc; p(fire); (b) 9 programmed thresholds; switching count N; (c) calibration map

(a) graded integration (scope)

membrane above rest (mV)

input spikes in burst, N

ΔJexc from base (mV)
