federicohyo/OSCAR/measurements/plotting/figures/comparator_cal_ac.pdf

## (a) graded integration (scope)

## (b) calibration map

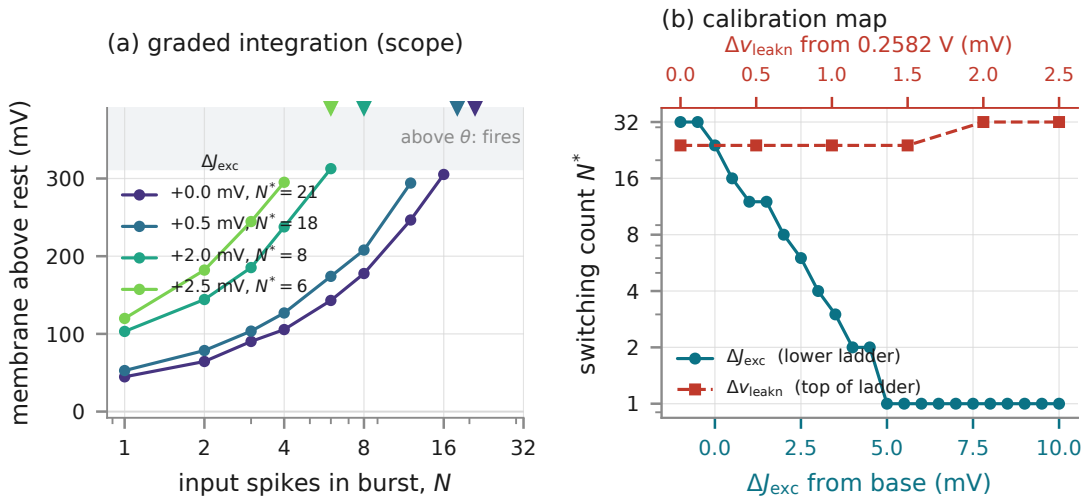
[picture p76: page 1]
above θ: fires; ΔJexc; switching count N

Δvleakn from 0.2582 V (mV)

membrane above rest (mV)

ΔJexc (lower ladder)
Δvleakn (top of ladder)

input spikes in burst, N

ΔJexc from base (mV)
