federicohyo/OSCAR/measurements/plotting/figures/comparator_cal_pb.pdf

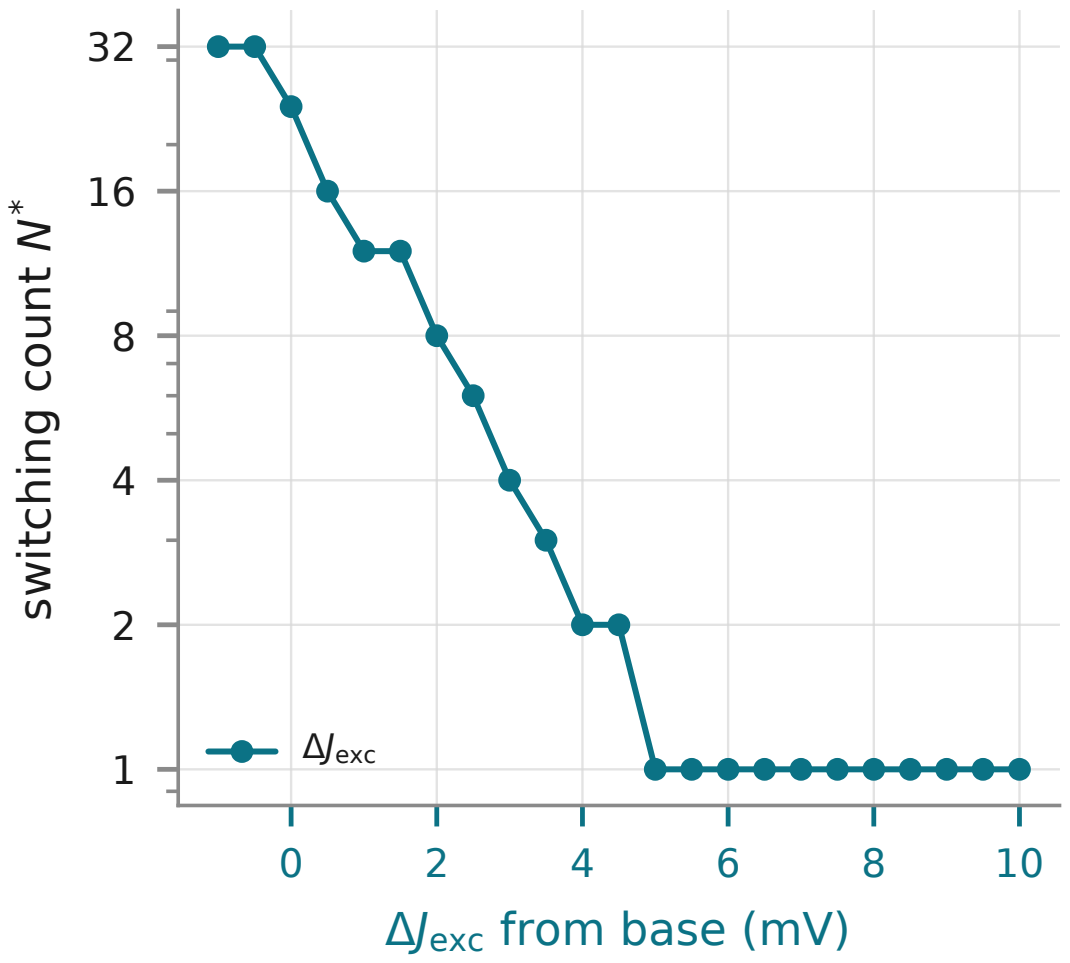
[picture p77: page 1]
switching count N; ΔJexc

ΔJexc from base (mV)
