federicohyo/OSCAR/measurements/plotting/figures/comparator_drift.pdf

## (a) the ladder over a session

## (b) hours matter, minutes do not

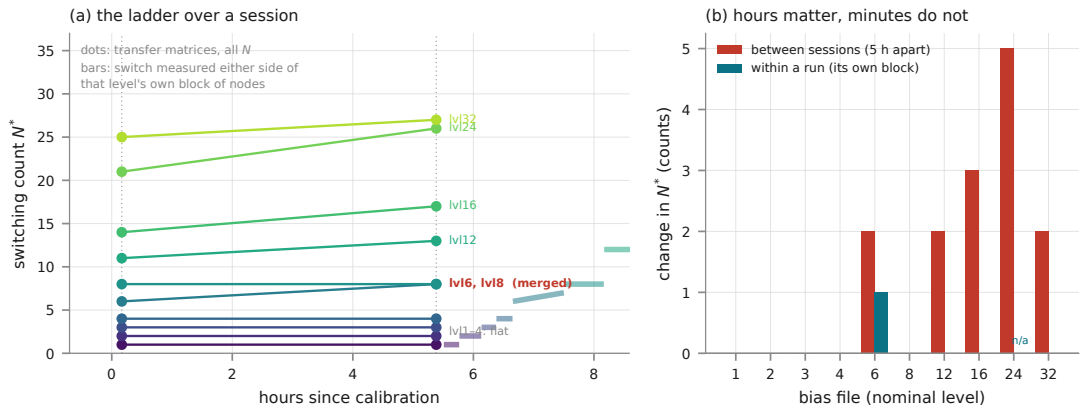
[picture p78: page 1]
switching count N; lvl6, lvl8 (merged); lvl12; lvl16; lvl24 lvl32; lvl1–4: flat; change in N; (counts)

dots: transfer matrices, all N

between sessions (5 h apart)
within a run (its own block)

bars: switch measured either side of
that level's own block of nodes

hours since calibration

bias file (nominal level)
