federicohyo/OSCAR/measurements/plotting/figures/deff_decomp_v3.pdf

25

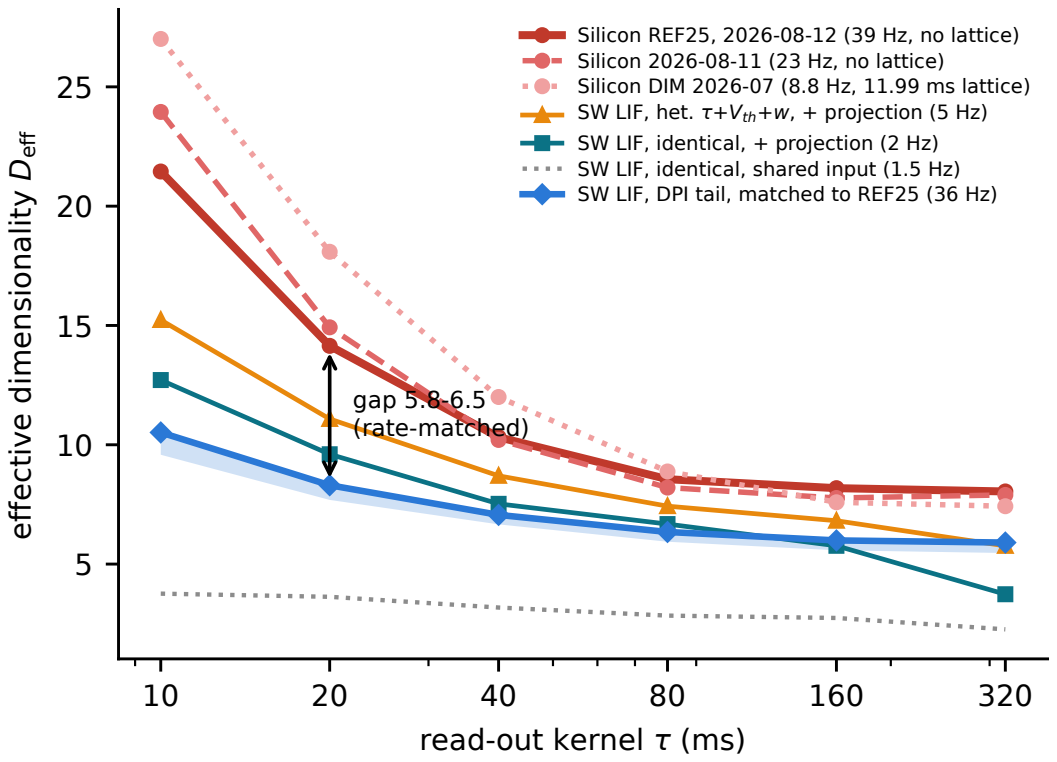
[picture p79: page 1]
gap 5.8-6.5 (rate-matched)

Silicon REF25, 2026-08-12 (39 Hz, no lattice)
Silicon 2026-08-11 (23 Hz, no lattice)
Silicon DIM 2026-07 (8.8 Hz, 11.99 ms lattice)
SW LIF, het. τ+Vth+w, + projection (5 Hz)
SW LIF, identical, + projection (2 Hz)
SW LIF, identical, shared input (1.5 Hz)
SW LIF, DPI tail, matched to REF25 (36 Hz)

effective dimensionality Deff

read-out kernel τ (ms)
