federicohyo/OSCAR/measurements/plotting/figures/neuron_fi_all16_insets.pdf

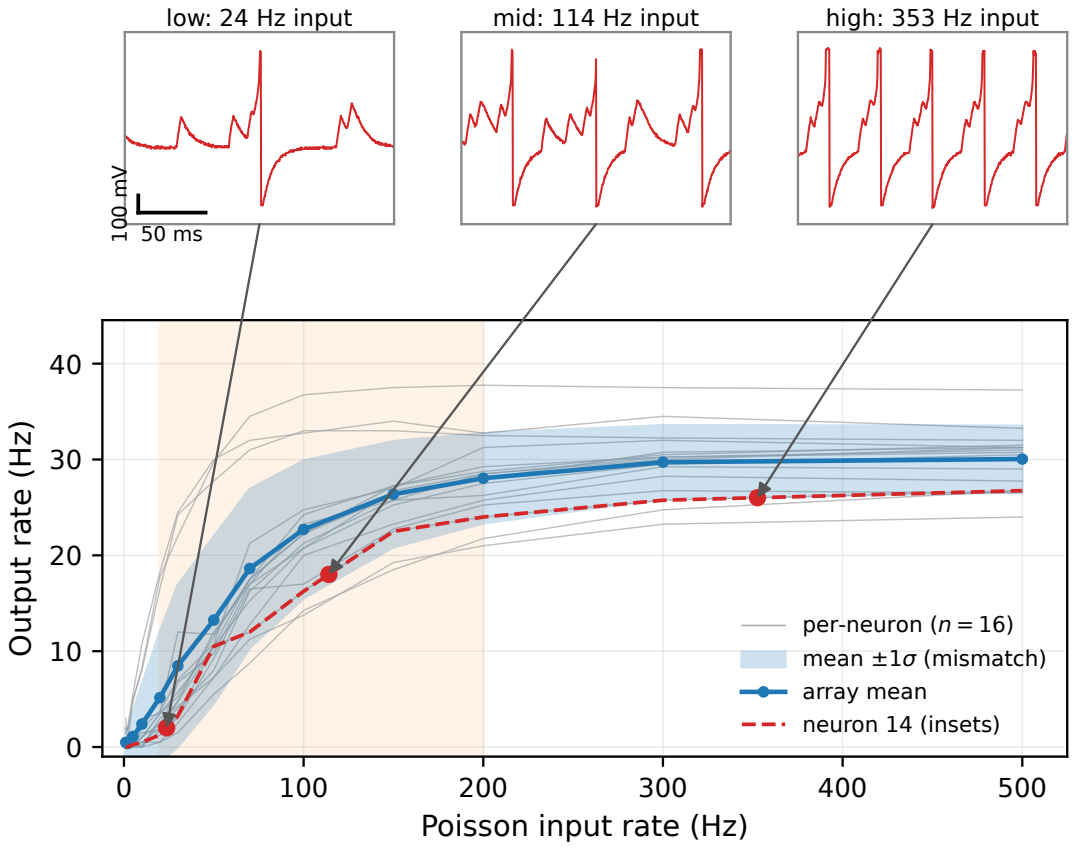
[picture p80: page 1]
low: 24 Hz input; mid: 114 Hz input; high: 353 Hz input

Output rate (Hz)

per-neuron (n = 16)
mean ±1σ (mismatch) array mean neuron 14 (insets)

Poisson input rate (Hz)
