federicohyo/OSCAR/measurements/plotting/figures/weight_code.pdf

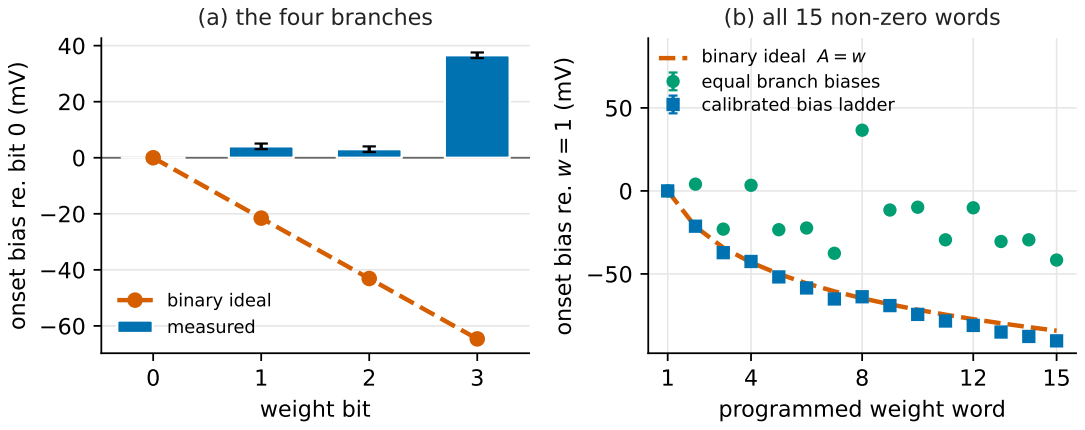
[picture p81: page 1]
weight bit; binary ideal measured

(a) the four branches

(b) all 15 non-zero words
bin
equal branch biases
calibrated bias ladder

onset bias re. bit 0 (mV)

onset bias re. w = 1 (mV)

programmed weight word
