federicohyo/OSCAR/measurements/plotting/figures/weight_code_words.pdf

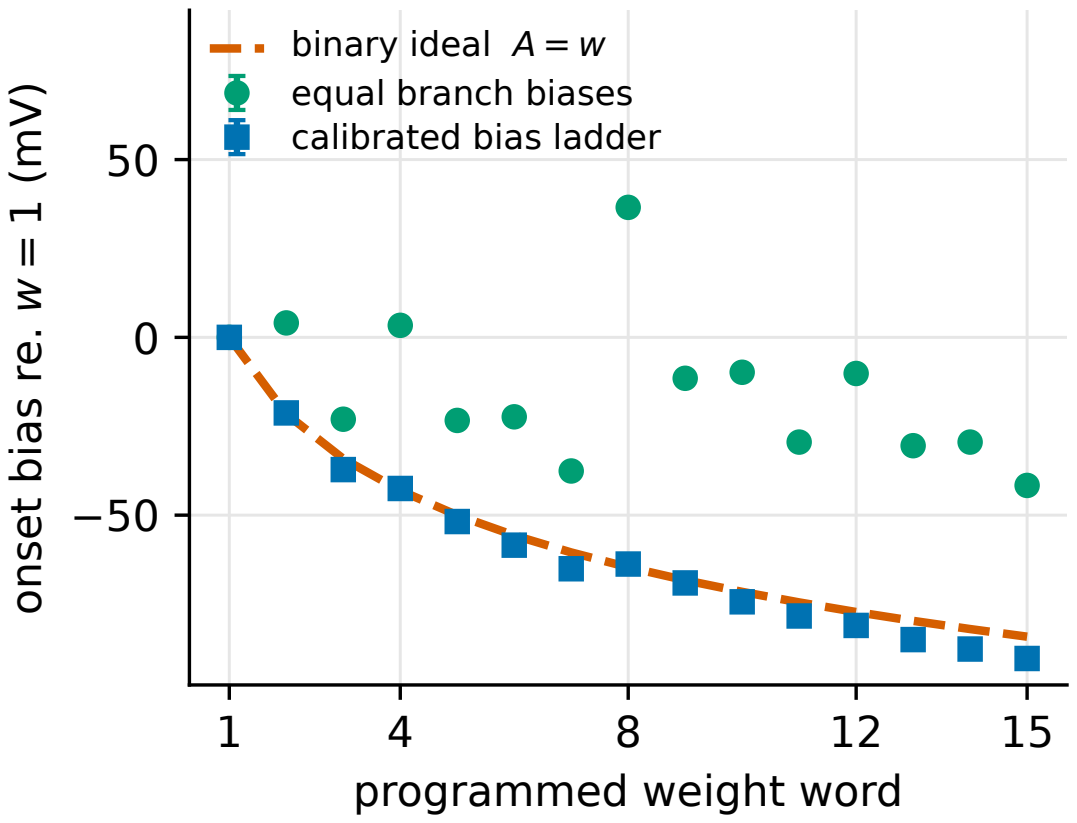
[picture p82: page 1]

binary ideal A = w
equal branch biases
calibrated bias ladder

nset bias re. w

programmed weight word
