federicohyo/OSCAR/measurements/wet_pad/figures/fig17_tio2_dilute3x.pdf

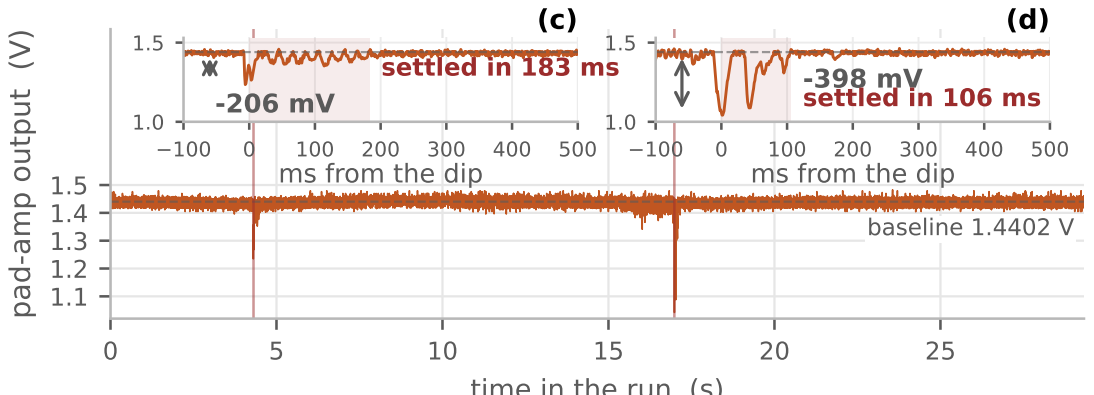
[picture p83: page 1]
ms from the dip

pad-amp output (V)

settled in 183 ms

-398 mV settled in 106 ms

ms from the dip
baseline 1.4402 V

time in the run (s)
