federicohyo/OSCAR/measurements/lna/clean_2026-08-26/figures/gain_vs_frequency.pdf

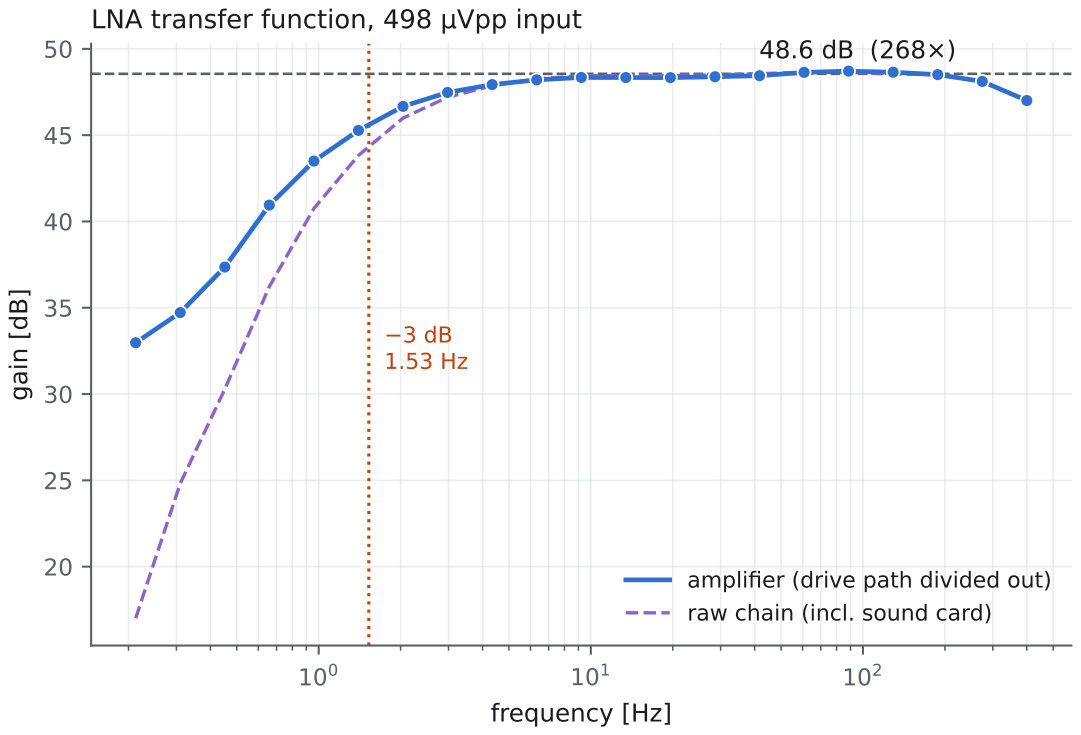
[picture p84: page 1]
frequency [Hz]; gain [dB]; amplifier (drive; path divided out); raw chain (incl.; sound card)

LNA transfer function, 498 µVpp input
