federicohyo/OSCAR/measurements/lna/figures/fig12_lna_gain_noise.pdf

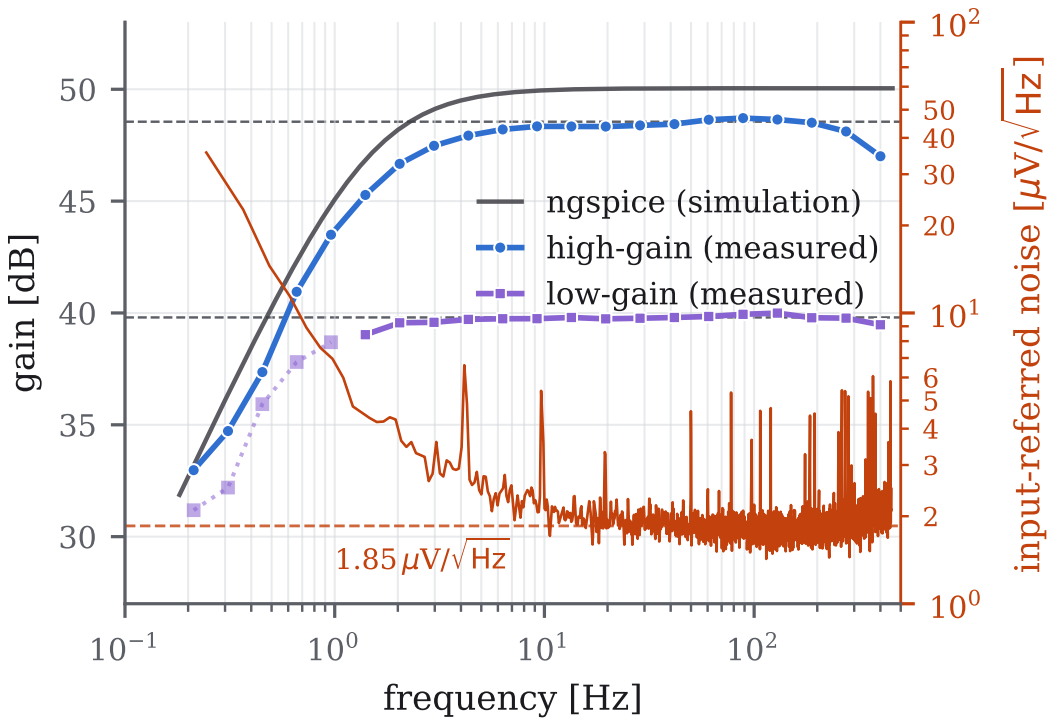
[picture p85: page 1]
frequency [Hz]; gain [dB]; input-referred noise [μV/√ Hz]

ngspice (simulation)
high-gain (measured) low-gain (measured)
