federicohyo/OSCAR/measurements/lna/figures/fig12_lna_transfer.pdf

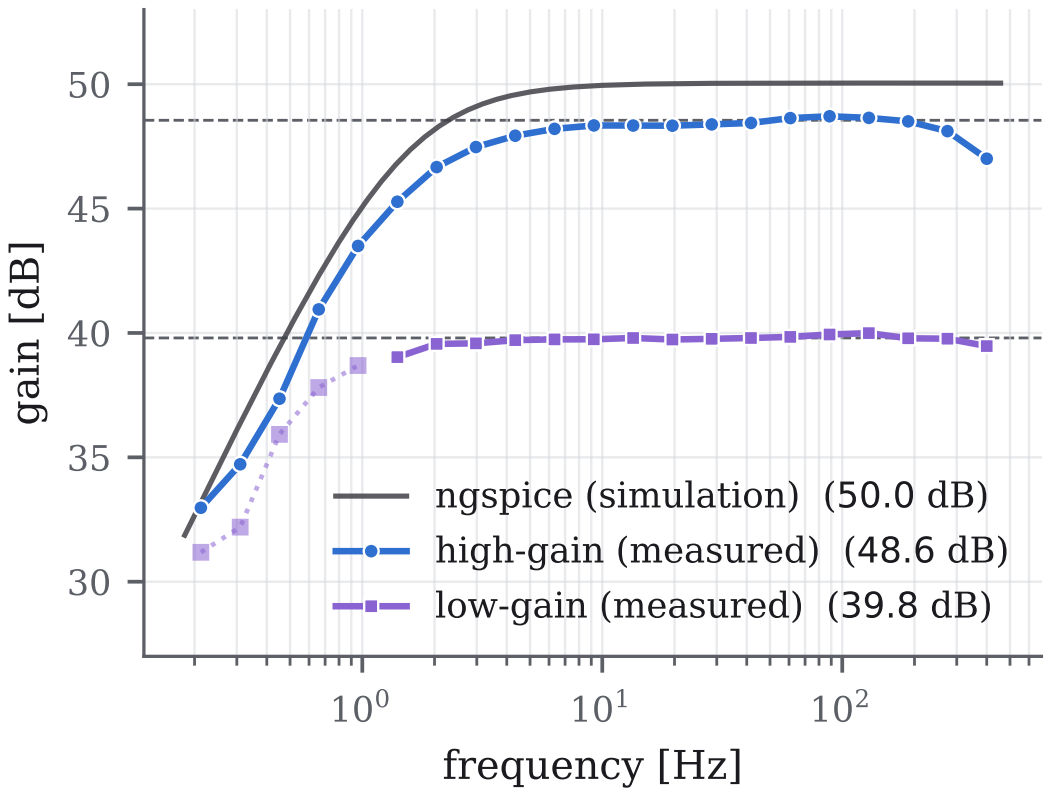
[picture p86: page 1]
frequency [Hz]; gain [dB]

ngspice (simulation) high-gain (measured) | (50.0 dB) (48.6 dB)

low-gain (measured) | (39.8 dB)
