federicohyo/OSCAR/measurements/lna/figures/fig14_lna_noise.pdf

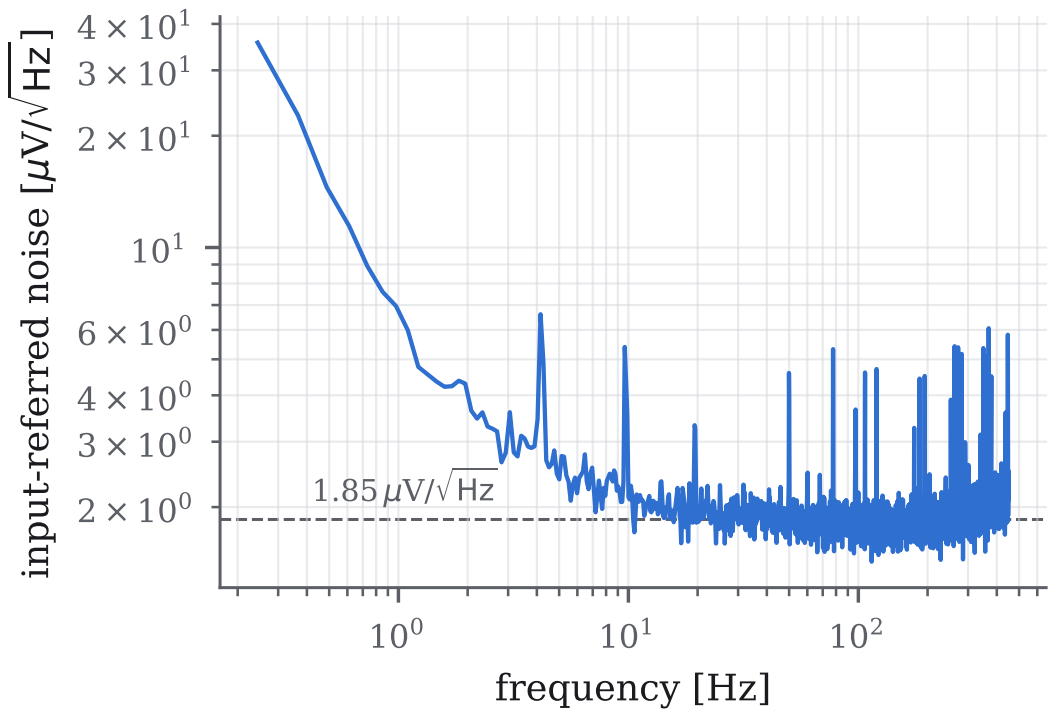
[picture p87: page 1]
frequency [Hz]

input-referred noise [μV/√ Hz]
