federicohyo/OSCAR/measurements/lna/figures/gain_vs_level_highgain.pdf

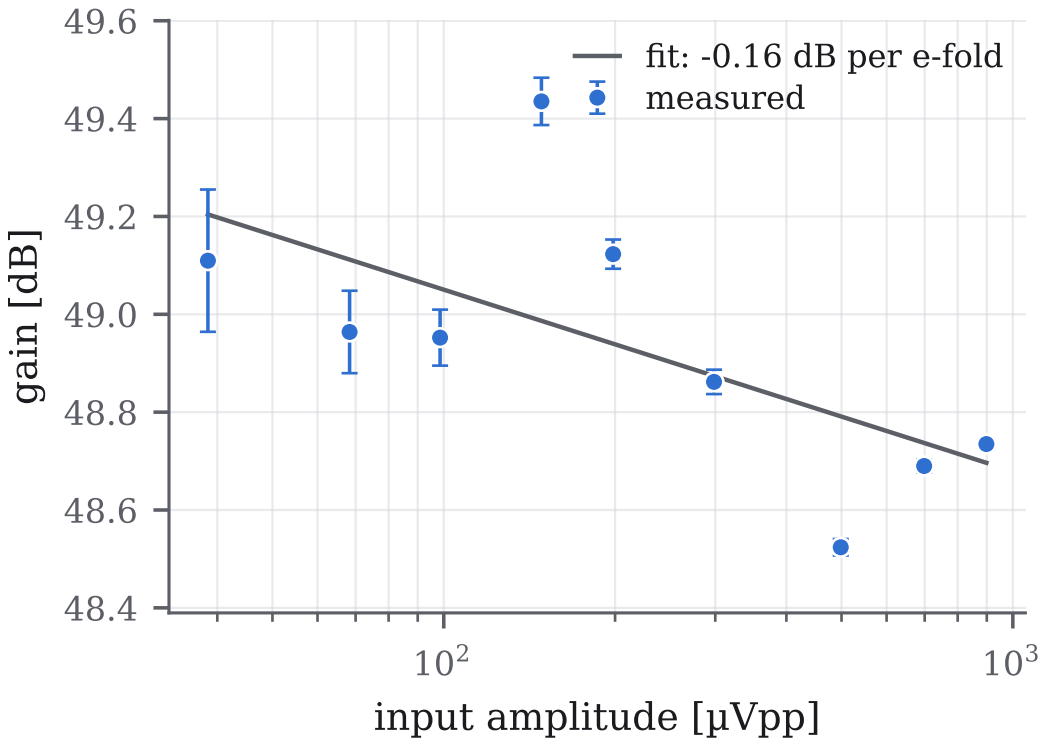
[picture p88: page 1]
gain [dB]

fit: -0.16 dB per e-fold
measured

input amplitude [µVpp]
