federicohyo/OSCAR/measurements/lna/figures/lna_noise_input_referred.pdf

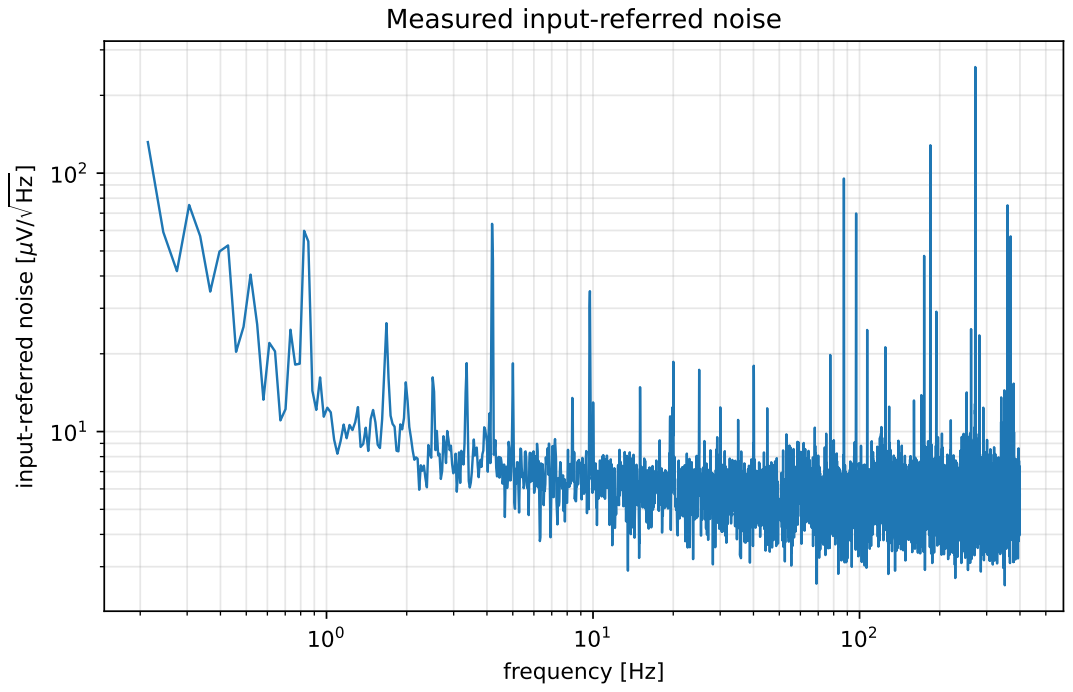
[picture p89: page 1]
frequency [Hz]; ut-referre; oise [μ

Measured input-referred noise
