federicohyo/OSCAR/measurements/lna/figures/lna_phase_vs_sim.pdf

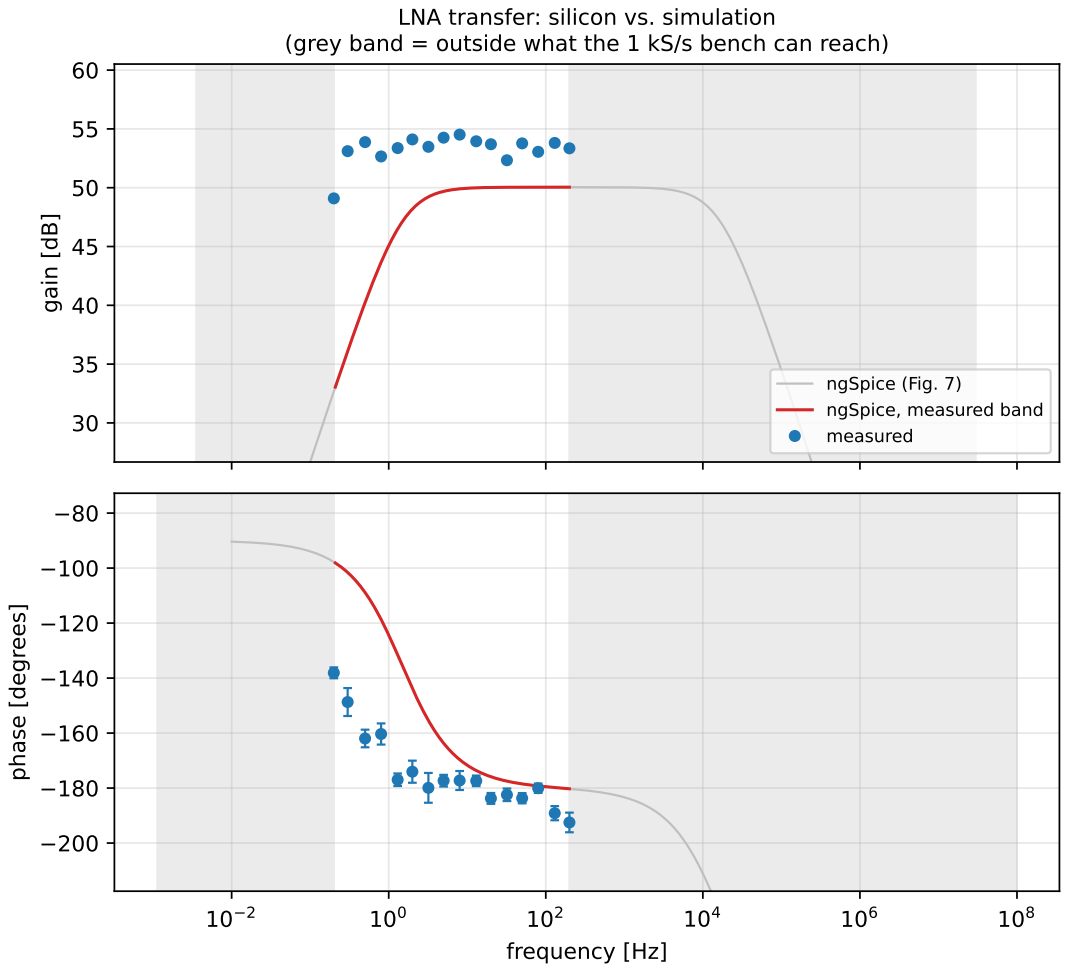
[picture p90: page 1]
gain [dB]; frequency [Hz]; phase [degrees]

LNA transfer: silicon vs. simulation

(grey band = outside what the 1 kS/s bench can reach)

ngSpice (Fig. 7) ngSpice, measured band

measured
