federicohyo/OSCAR/measurements/lna/figures/lna_transfer_final.pdf

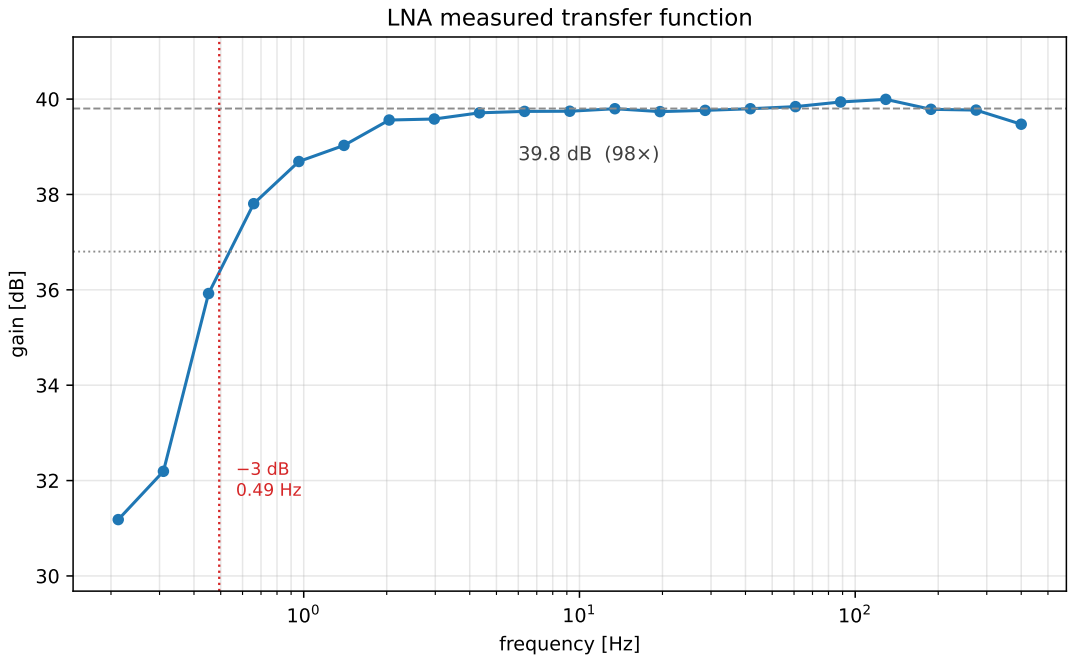
[picture p91: page 1]
frequency [Hz]; gain [dB]

LNA measured transfer function

−3 | dB
0.49 | | Hz
