federicohyo/OSCAR/measurements/lna/figures/tio2_dilute3x_report.pdf

## 1 — two injections

## 2 — first injection

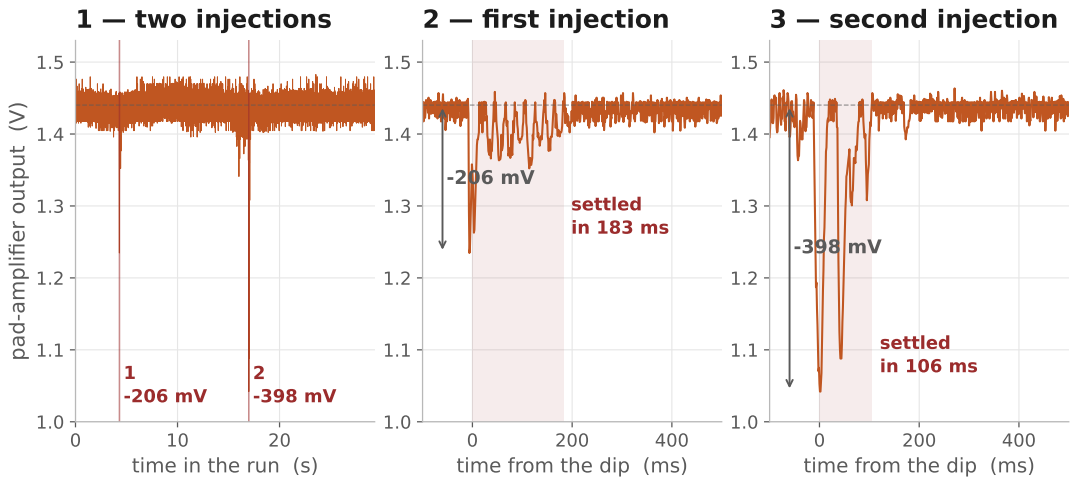
[picture p92: page 1]
time in the run (s); pad-ampli; fier output (V); settled in 183 ms; settled in 106 ms; 3 — second injection

time from the dip (ms)
