federicohyo/OSCAR/measurements/lna/figures/tio2_injection_recovery_report.pdf

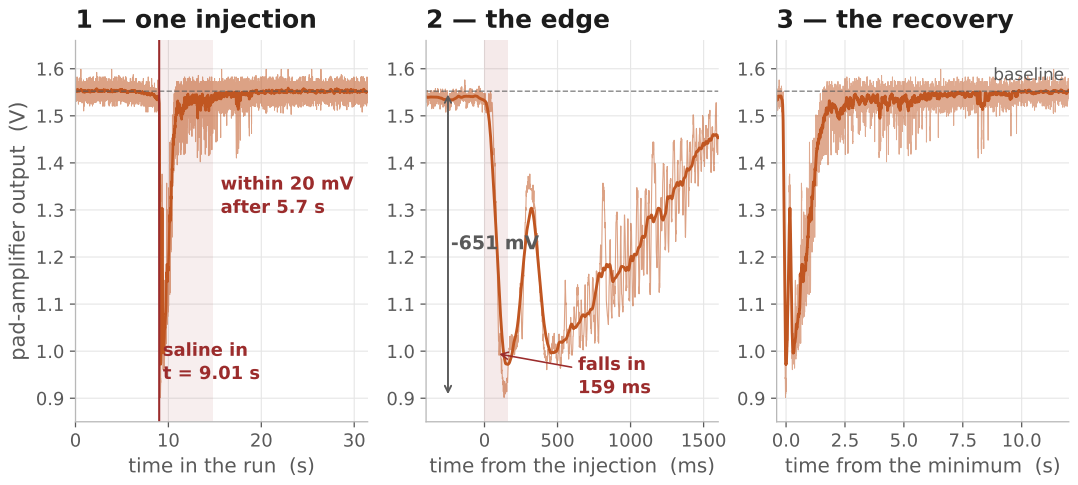
[picture p93: page 1]
time in the run (s); pad-ampli; fier output (V); saline in t = 9.01 s; within 20 mV after 5.7 s; 1 — one injection; falls in 159 ms; 2 — the edge; 0.0 2.5 5.0 7.5 10.0 time from the minimum (s); baseline; 3 — the recovery

time from the injection (ms)
