federicohyo/OSCAR/measurements/lna/figures/tio2_three_panel_report.pdf

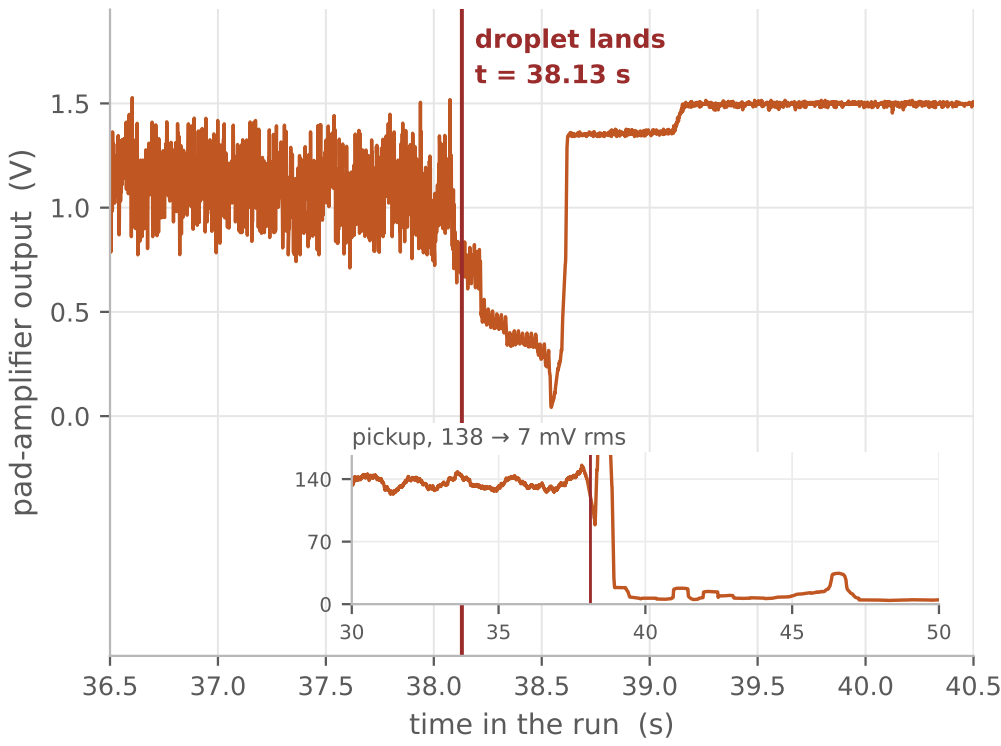
[picture p94: page 1]
36.5 37.0 37.5 38.0 38.5 39.0 39.5 40.0 40.5 time in the run (s); pad-ampli; fier output (V); droplet lands t = 38.13 s; pickup, 138 → 7 mV rms
