federicohyo/OSCAR/measurements/olfaction/figures/fig_pipeline_row.pdf

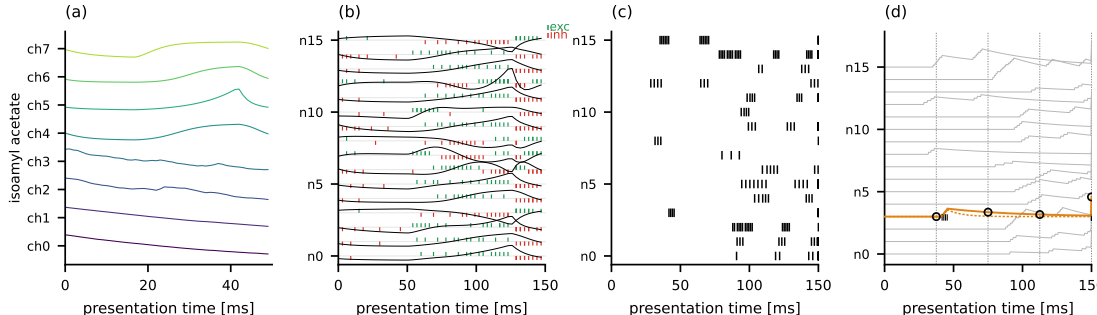
[picture p95: page 1]
presentation time [ms]; isoamyl acetate; exc inh

presentation time [ms]
