federicohyo/OSCAR/measurements/plotting/figures/coinc_13a_membrane.pdf

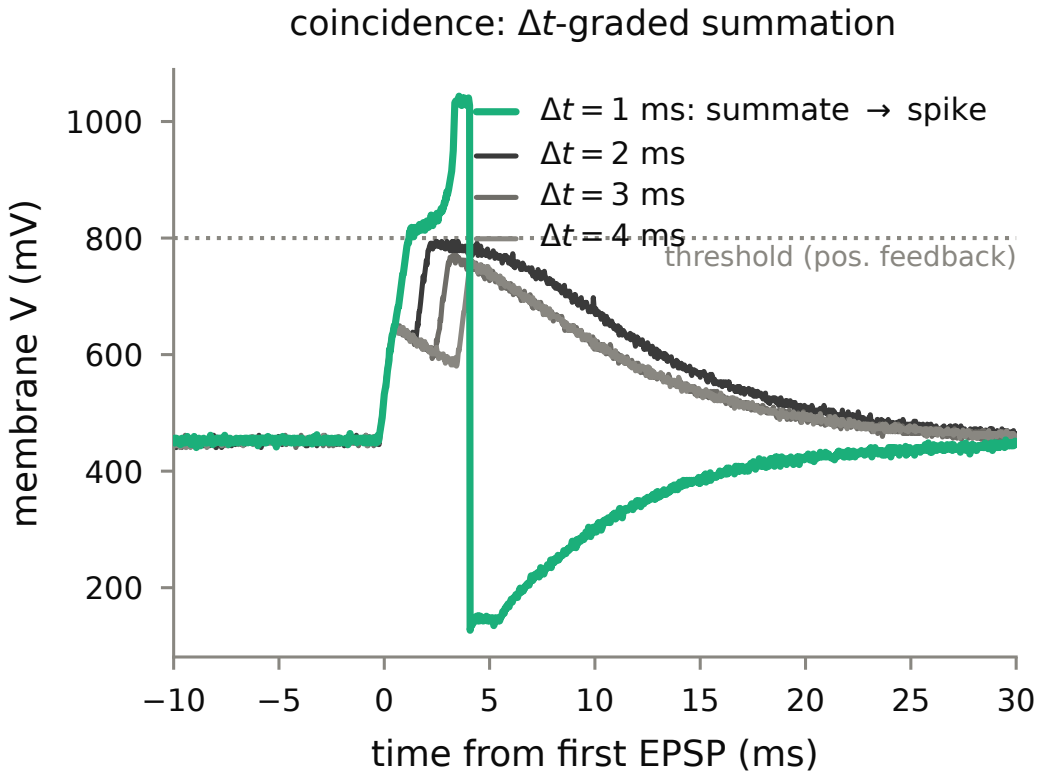
[picture p96: page 1]
membrane V (mV)

coincidence: Δt-graded summation

Δt = 1 ms: summate → spike

threshold (pos. feedback)

time from first EPSP (ms)
