federicohyo/OSCAR/measurements/plotting/figures/coincidence_membrane.pdf

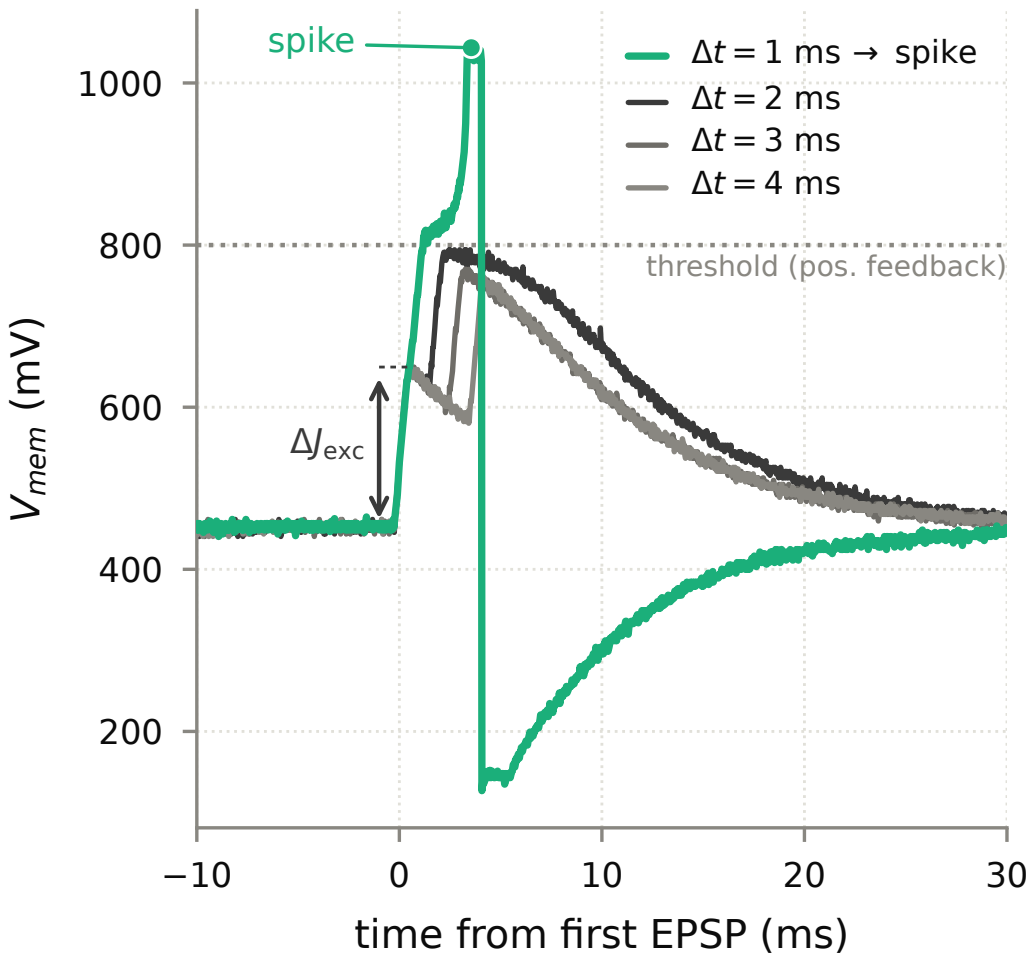
[picture p97: page 1]
Vmem (m; spike; Δt = 1 ms → spike

threshold (pos. feedback)

ΔJexc

time from first EPSP (ms)
