federicohyo/OSCAR/measurements/plotting/figures/comparator_cal_m.pdf

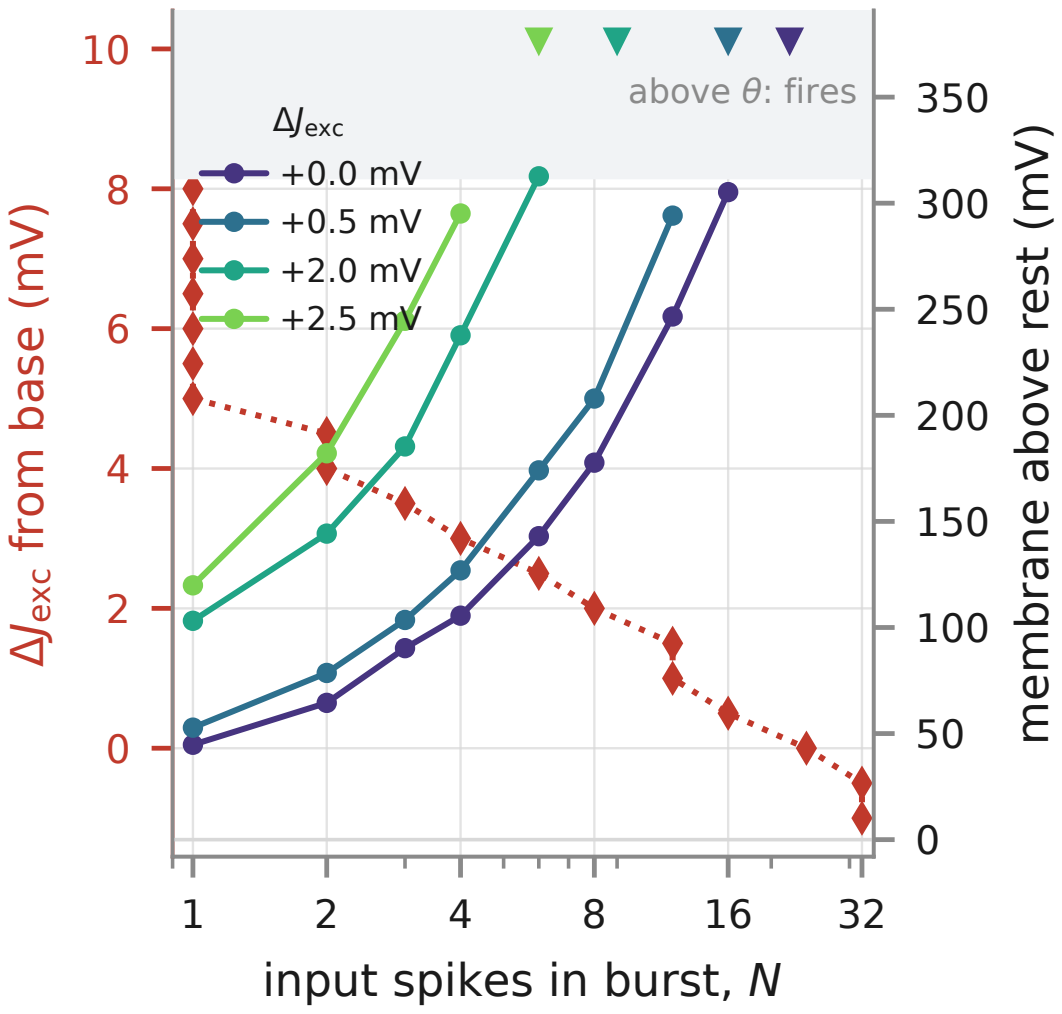
[picture p98: page 1]
32 input spikes in burst, N

ΔJ e +0.0 mV | x c | a b o v e | θ : fir e s

membrane above rest (mV)

ΔJexc from base (mV)
