federicohyo/OSCAR/measurements/plotting/figures/comparator_cal_pa.pdf

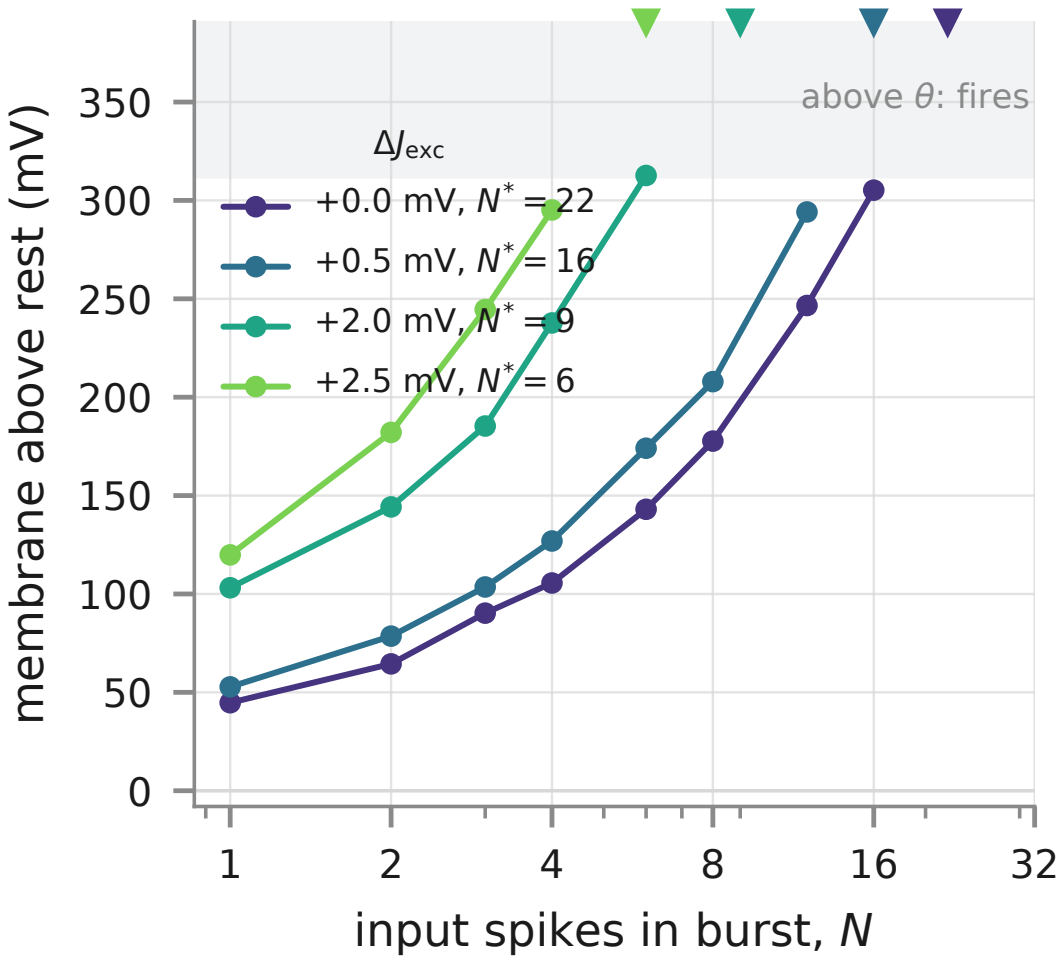
[picture p99: page 1]
32 input spikes in burst, N; fir

membrane above rest (mV)

+ 0 . 5 | m V , N * = | 1 6
+ 2 . 0 + 2 . 5 | m V , N * = * m V , N = | 9 6
