federicohyo/OSCAR/measurements/plotting/figures/comparator_drift3d.pdf

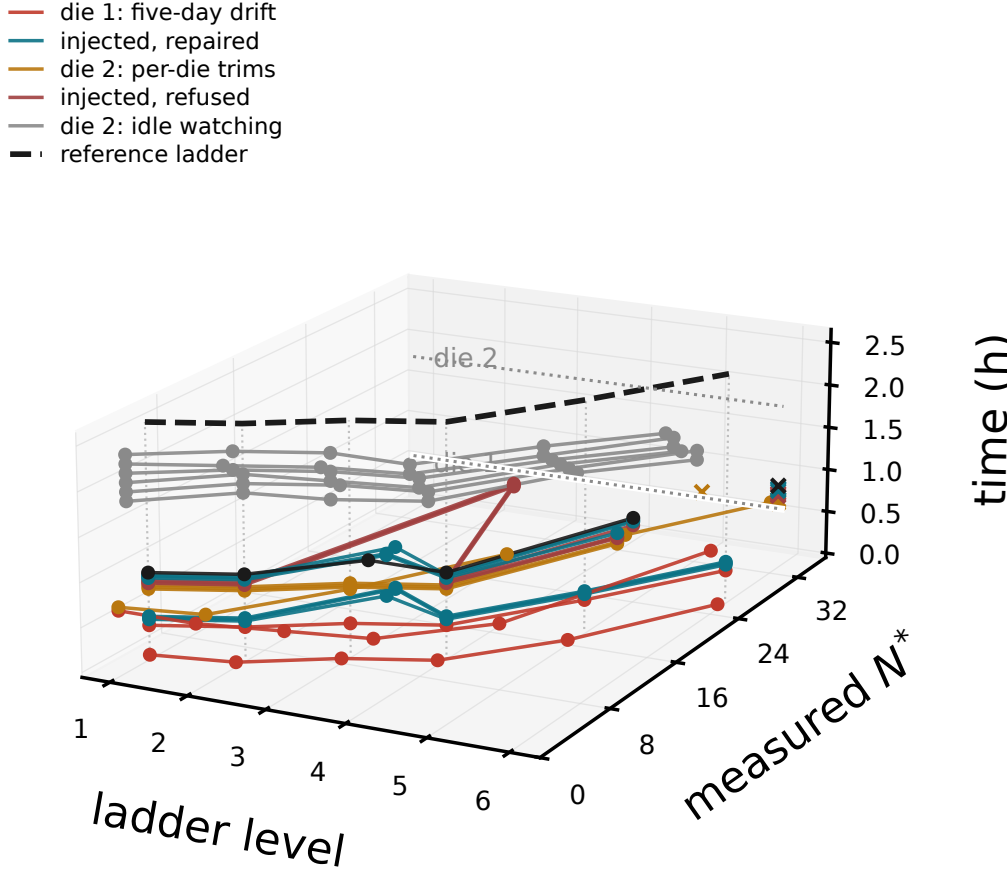
[picture p100: page 1]
ladder level; 32 measured N; time (h); die 1; die 2

die 1: five-day drift
injected, repaired
die 2: per-die trims
injected, refused
die 2: idle watching
reference ladder
