federicohyo/OSCAR/measurements/plotting/figures/deff_decomp.pdf

20

25

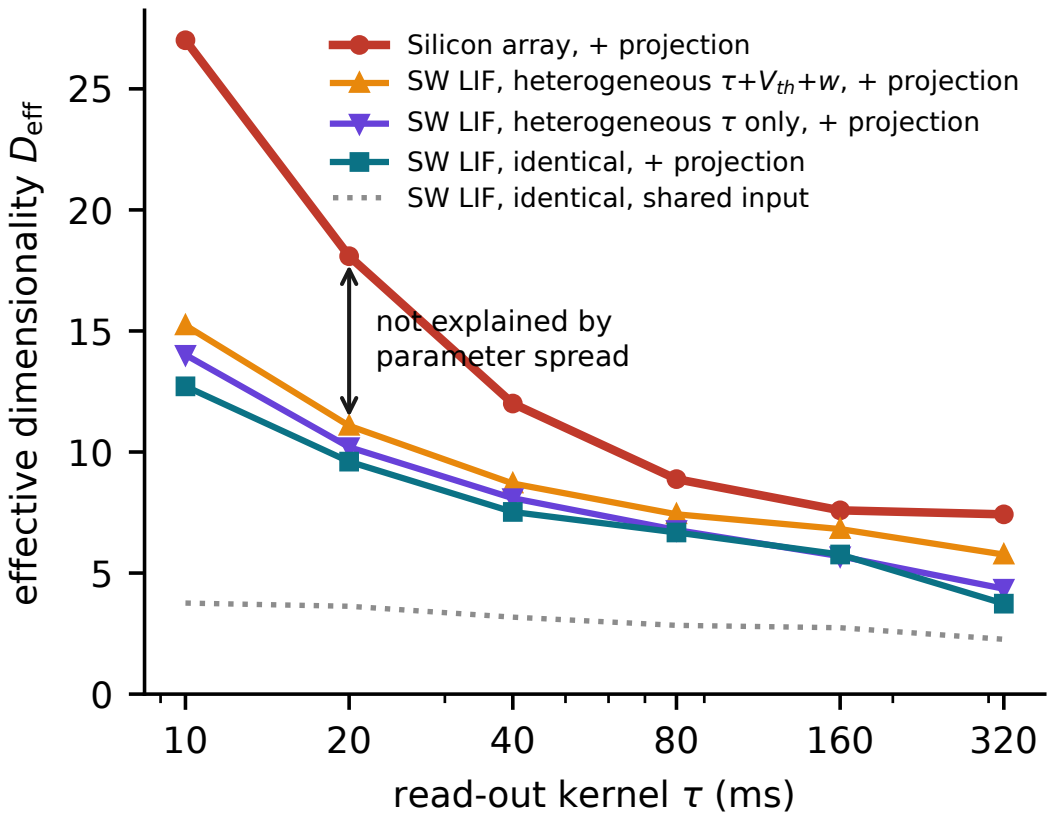
[picture p101: page 1]

Silicon array, + projection
SW LIF, heterogeneous τ+Vth+w, + projection
SW LIF, heterogeneous τ only, + projection
SW LIF, identical, + projection
SW LIF, identical, shared input

effective dimensionality Deff

not explained by
parameter spread

read-out kernel τ (ms)
