federicohyo/OSCAR/measurements/plotting/figures/olfaction_capacity.pdf

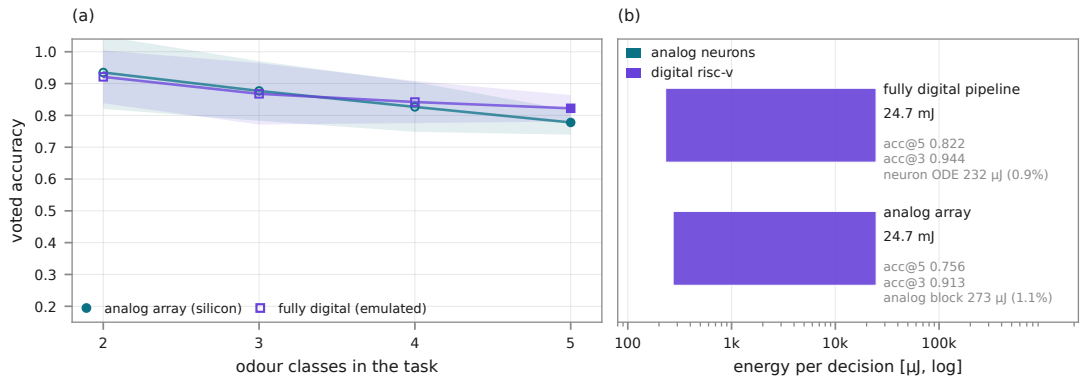
[picture p102: page 1]
voted accuracy; analog array (silicon); fully digital (emulated); analog array; analog neurons digital risc-v

fully digital pipeline

acc@5 0.822
acc@3 0.944
neuron ODE 232 µJ (0.9%)

acc@5 0.756
acc@3 0.913
analog block 273 µJ (1.1%)

odour classes in the task

energy per decision [µJ, log]
