federicohyo/OSCAR/measurements/plotting/figures/reservoir_demo.pdf

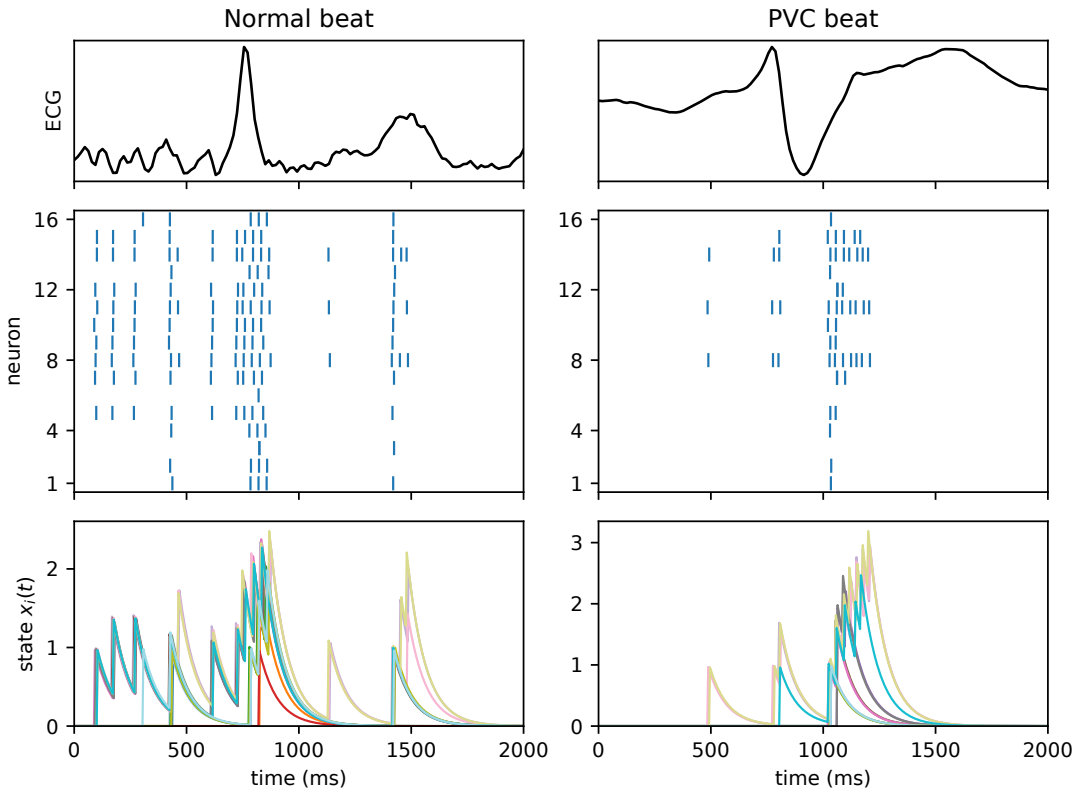
[picture p103: page 1]
ECG; Normal beat; PVC beat; neuron; time (ms); state
