federicohyo/OSCAR/measurements/wet_pad/figures/fig16_tio2_wetting.pdf

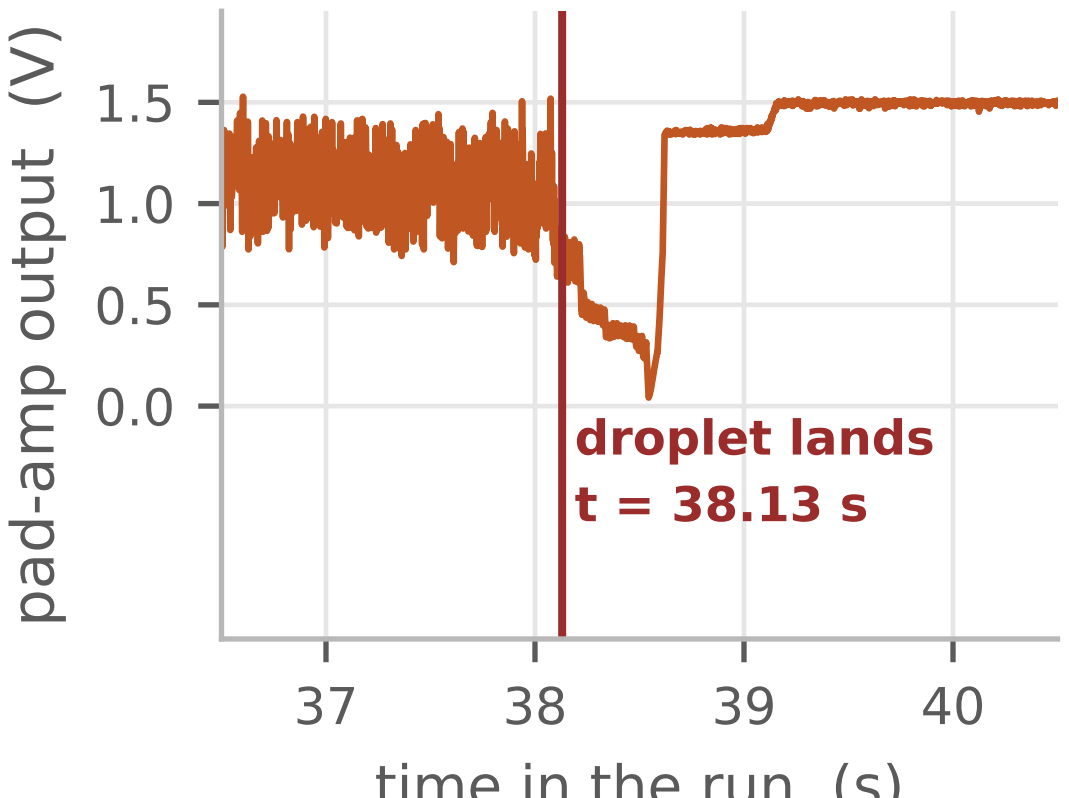
[picture p104: page 1]
pad-amp output (V); droplet lands t = 38.13 s

time in the run (s)
