federicohyo/OSCAR/measurements/wet_pad/figures/fig18_pad_evoked_chip1.pdf

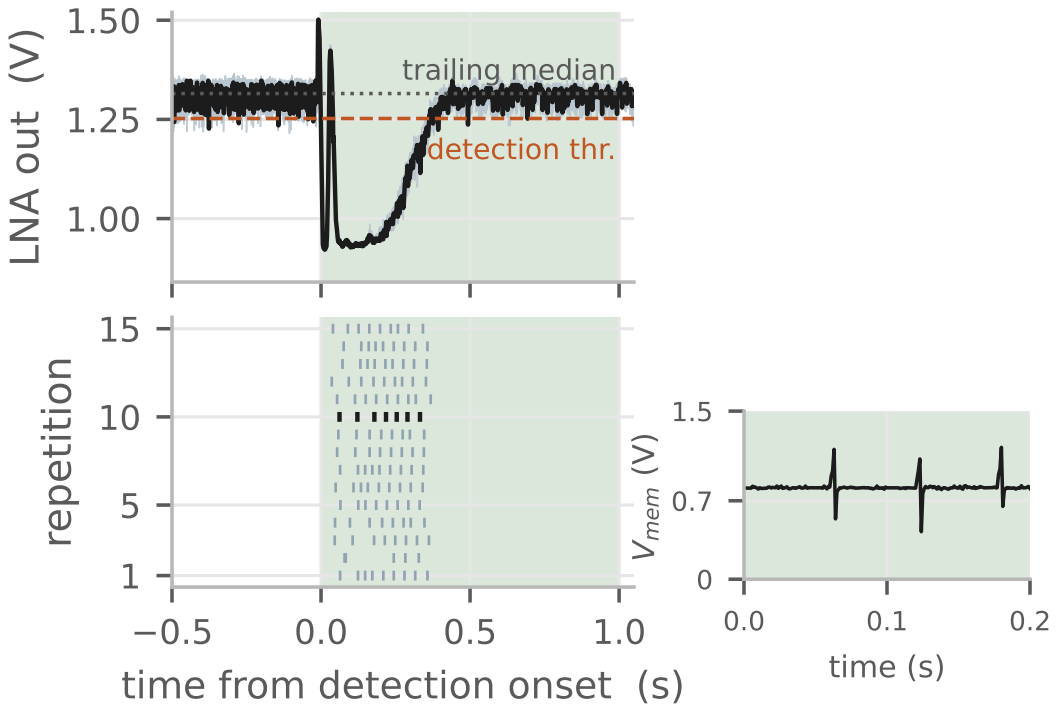
[picture p105: page 1]
LNA out (V); trailing median; detection thr.; repetition; time (s); Vmem (V)

time from detection onset (s)
