federicohyo/OSCAR/measurements/lna/clean_2026-08-26/figures/fig10_silicon_ab.pdf

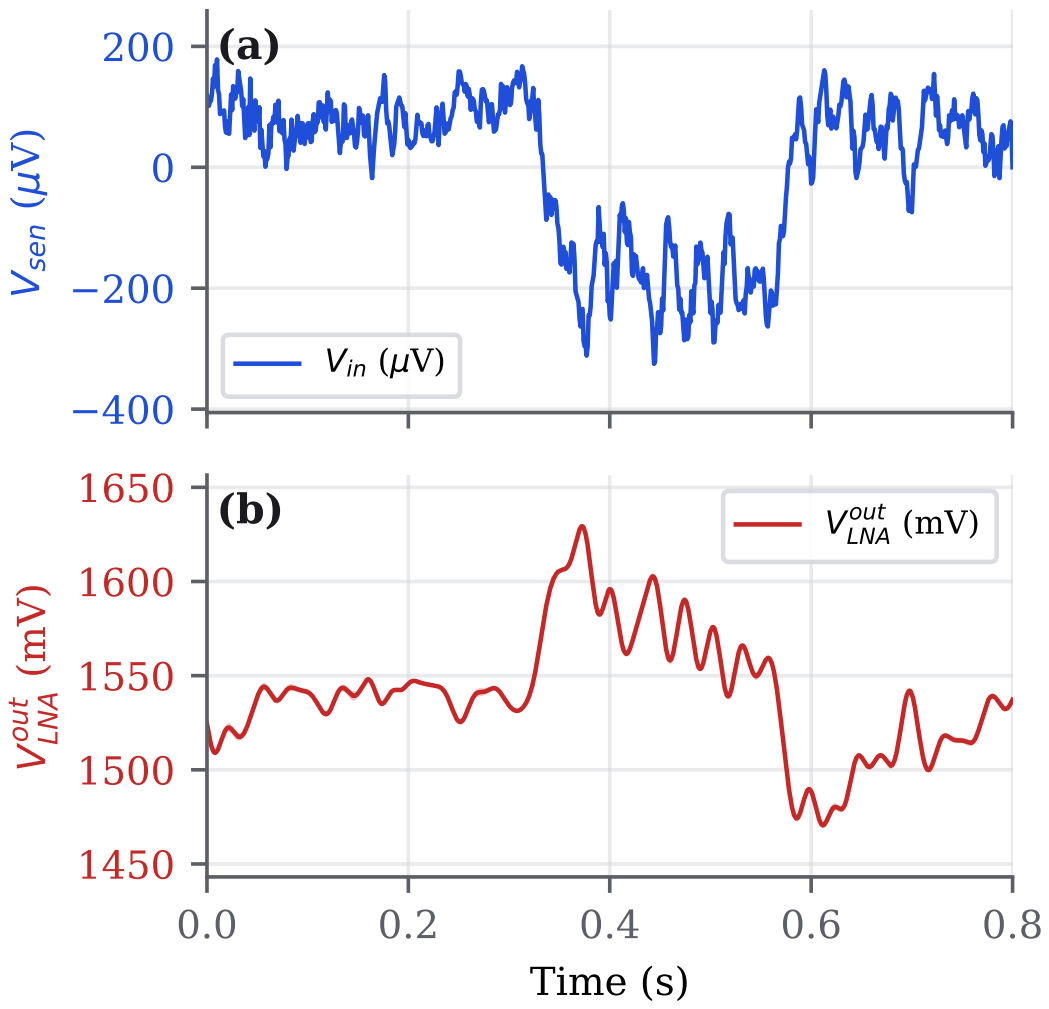
[picture p106: page 1]
Vsen (μ; Vin (μV); Time (s); out; LNA; out LNA
