federicohyo/OSCAR/measurements/lna/clean_2026-08-26/figures/fig10_silicon_full.pdf

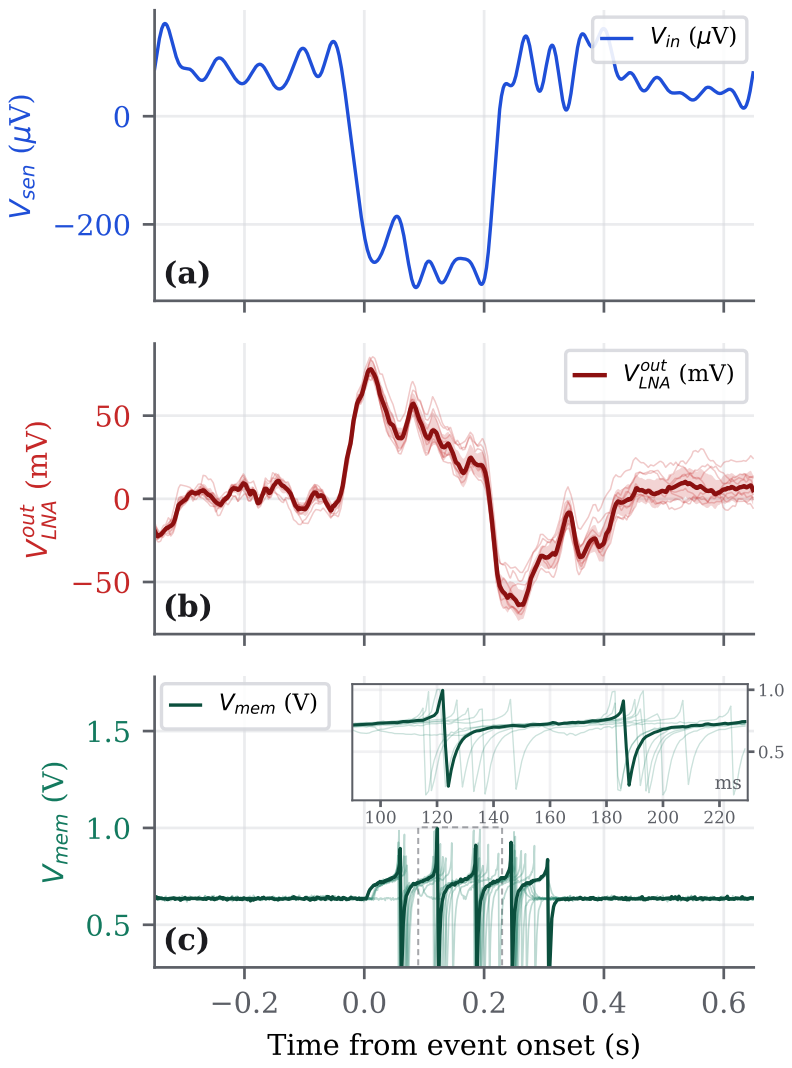
[picture p107: page 1]
Vsen (μ; Vin (μV); out; LNA; out LNA; Time from event onset (s); Vmem (V)
