federicohyo/OSCAR/measurements/lna/clean_2026-08-26/figures/gain_vs_level.pdf

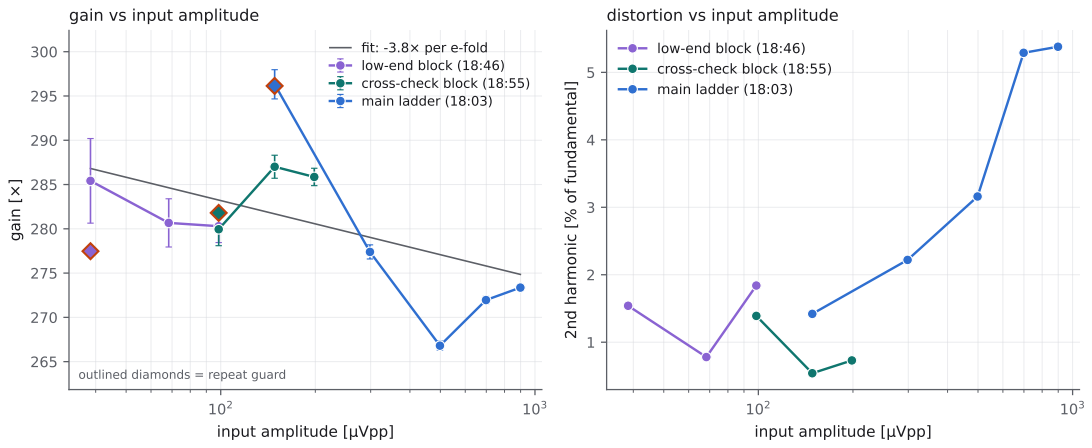
[picture p108: page 1]
gain [×]

gain vs input amplitude

distortion vs input amplitude
low-end block (18:46)
cross-check block (18:55)
main ladder (18:03)

fit: -3.8× per e-fold

2nd harmonic [% of fundamental]

outlined diamonds = repeat guard

input amplitude [µVpp]
