federicohyo/OSCAR/measurements/lna/clean_2026-08-26/figures/noise.pdf

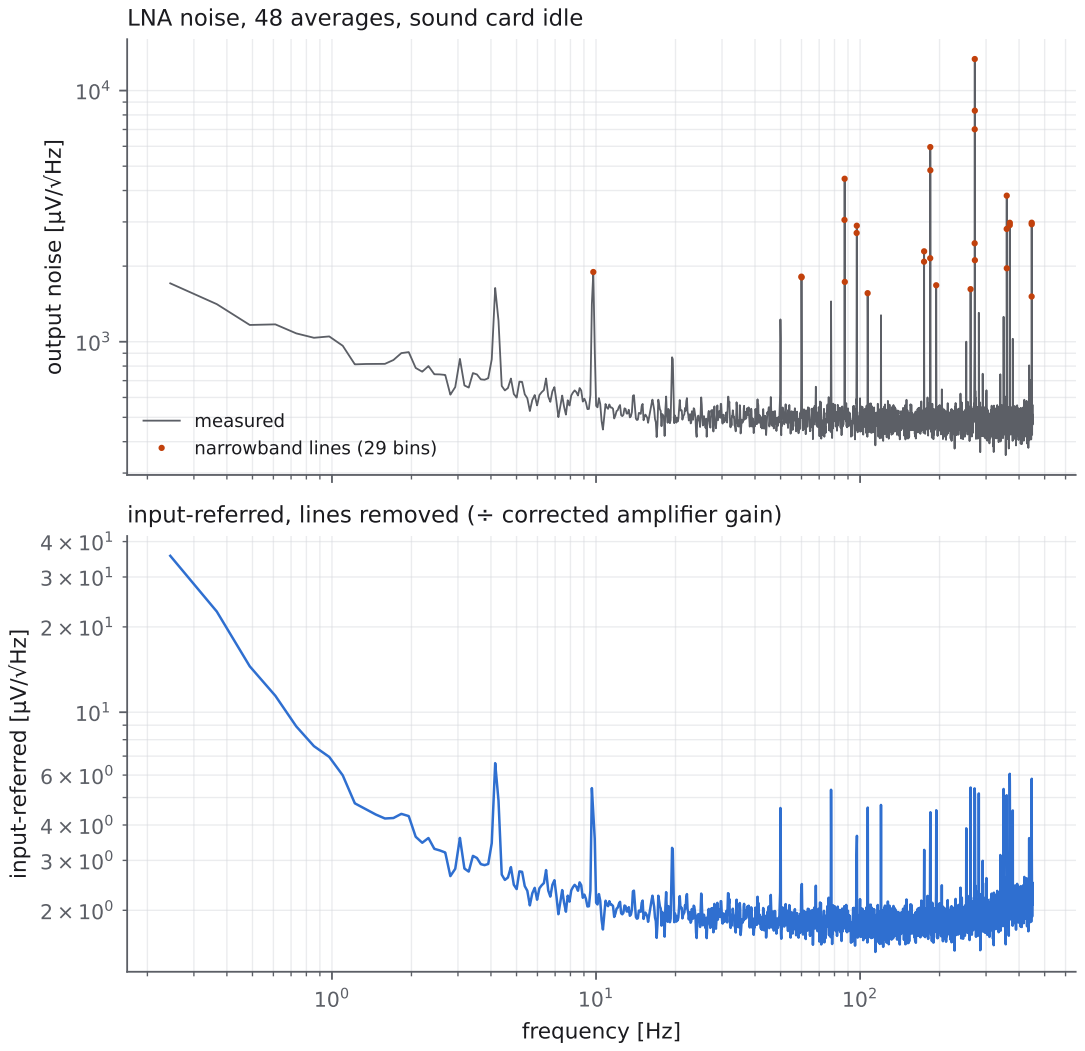
[picture p109: page 1]
measured; narrowband; lines (29 bins); frequency [Hz]

LNA noise, 48 averages, sound card idle

output noise [µV/

input-referred, lines removed (÷ corrected amplifier gain)

input-referred [µV/
