federicohyo/OSCAR/measurements/lna/clean_2026-08-26/figures/odor_neuron_chain.pdf

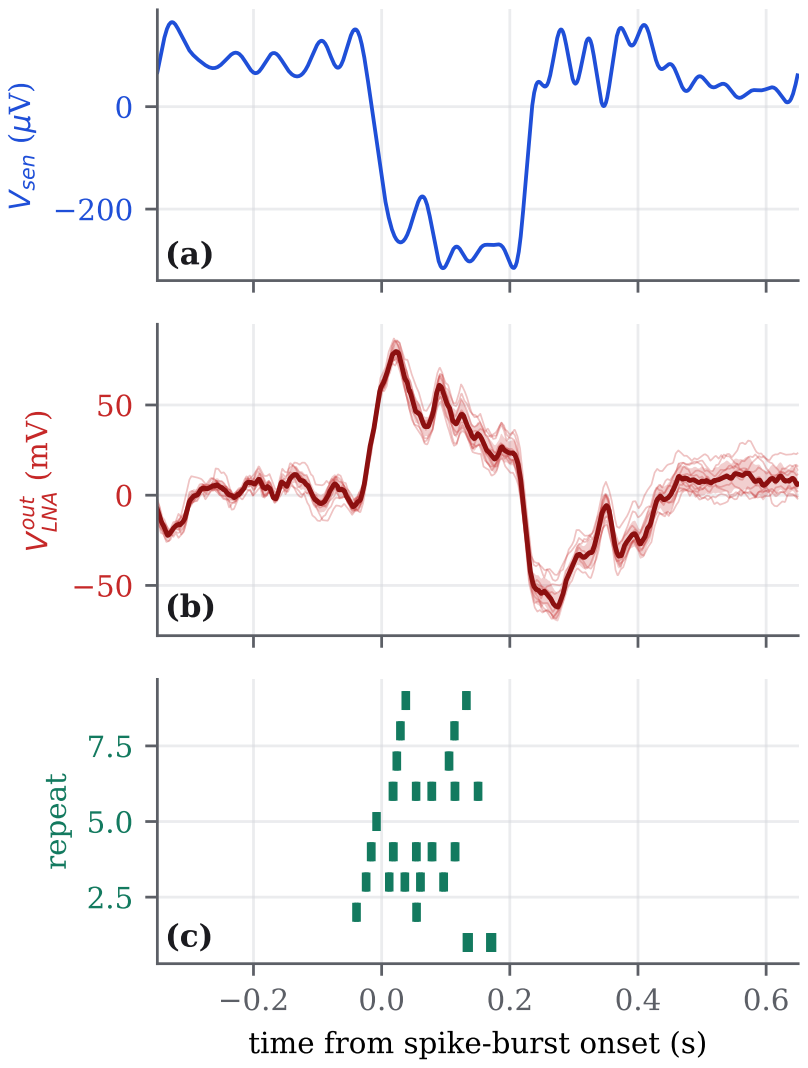
[picture p110: page 1]
Vsen (μ; out; LNA; time from spike-burst onset (s); repeat
