federicohyo/OSCAR/measurements/lna/clean_2026-08-26/figures/odor_response.pdf

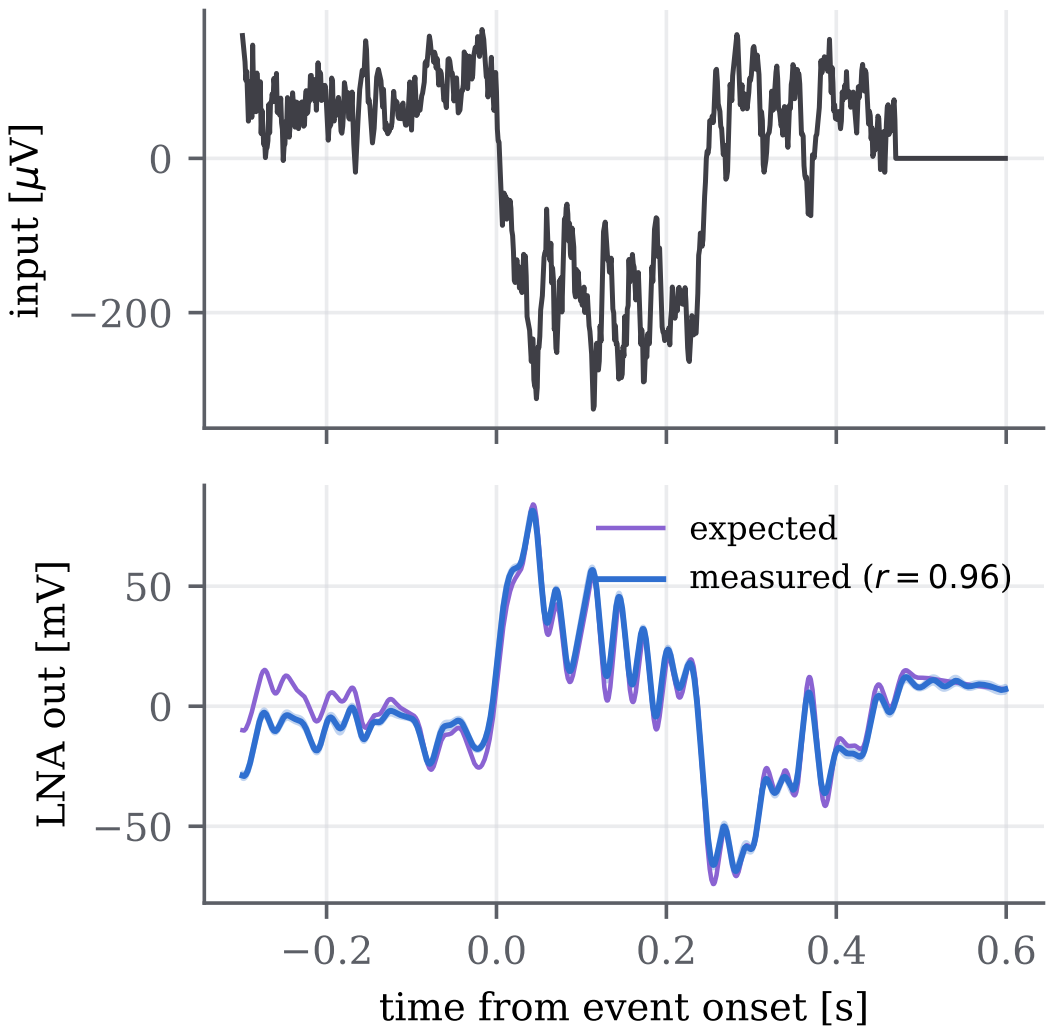
[picture p111: page 1]
expected measured (r = 0.96)

LNA out [mV]

time from event onset [s]
