federicohyo/OSCAR/design/netlists/user_analog_project_wrapper.spice

** sch_path: /home/federico/tue/projects/aVLSI-SkyWater130-2024/xschem/user_analog_project_wrapper.sch
.subckt user_analog_project_wrapper vdda1 vdda2 vssa1 vssa2 vccd1 vccd2 vssd1 vssd2 wb_clk_i wb_rst_i wbs_stb_i wbs_cyc_i wbs_we_i
+ wbs_sel_i[3] wbs_sel_i[2] wbs_sel_i[1] wbs_sel_i[0] wbs_dat_i[31] wbs_dat_i[30] wbs_dat_i[29] wbs_dat_i[28] wbs_dat_i[27] wbs_dat_i[26]
+ wbs_dat_i[25] wbs_dat_i[24] wbs_dat_i[23] wbs_dat_i[22] wbs_dat_i[21] wbs_dat_i[20] wbs_dat_i[19] wbs_dat_i[18] wbs_dat_i[17] wbs_dat_i[16]
+ wbs_dat_i[15] wbs_dat_i[14] wbs_dat_i[13] wbs_dat_i[12] wbs_dat_i[11] wbs_dat_i[10] wbs_dat_i[9] wbs_dat_i[8] wbs_dat_i[7] wbs_dat_i[6]
+ wbs_dat_i[5] wbs_dat_i[4] wbs_dat_i[3] wbs_dat_i[2] wbs_dat_i[1] wbs_dat_i[0] wbs_adr_i[31] wbs_adr_i[30] wbs_adr_i[29] wbs_adr_i[28]
+ wbs_adr_i[27] wbs_adr_i[26] wbs_adr_i[25] wbs_adr_i[24] wbs_adr_i[23] wbs_adr_i[22] wbs_adr_i[21] wbs_adr_i[20] wbs_adr_i[19] wbs_adr_i[18]
+ wbs_adr_i[17] wbs_adr_i[16] wbs_adr_i[15] wbs_adr_i[14] wbs_adr_i[13] wbs_adr_i[12] wbs_adr_i[11] wbs_adr_i[10] wbs_adr_i[9] wbs_adr_i[8]
+ wbs_adr_i[7] wbs_adr_i[6] wbs_adr_i[5] wbs_adr_i[4] wbs_adr_i[3] wbs_adr_i[2] wbs_adr_i[1] wbs_adr_i[0] wbs_ack_o wbs_dat_o[31] wbs_dat_o[30]
+ wbs_dat_o[29] wbs_dat_o[28] wbs_dat_o[27] wbs_dat_o[26] wbs_dat_o[25] wbs_dat_o[24] wbs_dat_o[23] wbs_dat_o[22] wbs_dat_o[21] wbs_dat_o[20]
+ wbs_dat_o[19] wbs_dat_o[18] wbs_dat_o[17] wbs_dat_o[16] wbs_dat_o[15] wbs_dat_o[14] wbs_dat_o[13] wbs_dat_o[12] wbs_dat_o[11] wbs_dat_o[10]
+ wbs_dat_o[9] wbs_dat_o[8] wbs_dat_o[7] wbs_dat_o[6] wbs_dat_o[5] wbs_dat_o[4] wbs_dat_o[3] wbs_dat_o[2] wbs_dat_o[1] wbs_dat_o[0]
+ la_data_in[127] la_data_in[126] la_data_in[125] la_data_in[124] la_data_in[123] la_data_in[122] la_data_in[121] la_data_in[120] la_data_in[119]
+ la_data_in[118] la_data_in[117] la_data_in[116] la_data_in[115] la_data_in[114] la_data_in[113] la_data_in[112] la_data_in[111] la_data_in[110]
+ la_data_in[109] la_data_in[108] la_data_in[107] la_data_in[106] la_data_in[105] la_data_in[104] la_data_in[103] la_data_in[102] la_data_in[101]
+ la_data_in[100] la_data_in[99] la_data_in[98] la_data_in[97] la_data_in[96] la_data_in[95] la_data_in[94] la_data_in[93] la_data_in[92]
+ la_data_in[91] la_data_in[90] la_data_in[89] la_data_in[88] la_data_in[87] la_data_in[86] la_data_in[85] la_data_in[84] la_data_in[83]
+ la_data_in[82] la_data_in[81] la_data_in[80] la_data_in[79] la_data_in[78] la_data_in[77] la_data_in[76] la_data_in[75] la_data_in[74]
+ la_data_in[73] la_data_in[72] la_data_in[71] la_data_in[70] la_data_in[69] la_data_in[68] la_data_in[67] la_data_in[66] la_data_in[65]
+ la_data_in[64] la_data_in[63] la_data_in[62] la_data_in[61] la_data_in[60] la_data_in[59] la_data_in[58] la_data_in[57] la_data_in[56]
+ la_data_in[55] la_data_in[54] la_data_in[53] la_data_in[52] la_data_in[51] la_data_in[50] la_data_in[49] la_data_in[48] la_data_in[47]
+ la_data_in[46] la_data_in[45] la_data_in[44] la_data_in[43] la_data_in[42] la_data_in[41] la_data_in[40] la_data_in[39] la_data_in[38]
+ la_data_in[37] la_data_in[36] la_data_in[35] la_data_in[34] la_data_in[33] la_data_in[32] la_data_in[31] la_data_in[30] la_data_in[29]
+ la_data_in[28] la_data_in[27] la_data_in[26] la_data_in[25] la_data_in[24] la_data_in[23] la_data_in[22] la_data_in[21] la_data_in[20]
+ la_data_in[19] la_data_in[18] la_data_in[17] la_data_in[16] la_data_in[15] la_data_in[14] la_data_in[13] la_data_in[12] la_data_in[11]
+ la_data_in[10] la_data_in[9] la_data_in[8] la_data_in[7] la_data_in[6] la_data_in[5] la_data_in[4] la_data_in[3] la_data_in[2] la_data_in[1]
+ la_data_in[0] la_data_out[127] la_data_out[126] la_data_out[125] la_data_out[124] la_data_out[123] la_data_out[122] la_data_out[121]
+ la_data_out[120] la_data_out[119] la_data_out[118] la_data_out[117] la_data_out[116] la_data_out[115] la_data_out[114] la_data_out[113]
+ la_data_out[112] la_data_out[111] la_data_out[110] la_data_out[109] la_data_out[108] la_data_out[107] la_data_out[106] la_data_out[105]
+ la_data_out[104] la_data_out[103] la_data_out[102] la_data_out[101] la_data_out[100] la_data_out[99] la_data_out[98] la_data_out[97]
+ la_data_out[96] la_data_out[95] la_data_out[94] la_data_out[93] la_data_out[92] la_data_out[91] la_data_out[90] la_data_out[89] la_data_out[88]
+ la_data_out[87] la_data_out[86] la_data_out[85] la_data_out[84] la_data_out[83] la_data_out[82] la_data_out[81] la_data_out[80] la_data_out[79]
+ la_data_out[78] la_data_out[77] la_data_out[76] la_data_out[75] la_data_out[74] la_data_out[73] la_data_out[72] la_data_out[71] la_data_out[70]
+ la_data_out[69] la_data_out[68] la_data_out[67] la_data_out[66] la_data_out[65] la_data_out[64] la_data_out[63] la_data_out[62] la_data_out[61]
+ la_data_out[60] la_data_out[59] la_data_out[58] la_data_out[57] la_data_out[56] la_data_out[55] la_data_out[54] la_data_out[53] la_data_out[52]
+ la_data_out[51] la_data_out[50] la_data_out[49] la_data_out[48] la_data_out[47] la_data_out[46] la_data_out[45] la_data_out[44] la_data_out[43]
+ la_data_out[42] la_data_out[41] la_data_out[40] la_data_out[39] la_data_out[38] la_data_out[37] la_data_out[36] la_data_out[35] la_data_out[34]
+ la_data_out[33] la_data_out[32] la_data_out[31] la_data_out[30] la_data_out[29] la_data_out[28] la_data_out[27] la_data_out[26] la_data_out[25]
+ la_data_out[24] la_data_out[23] la_data_out[22] la_data_out[21] la_data_out[20] la_data_out[19] la_data_out[18] la_data_out[17] la_data_out[16]
+ la_data_out[15] la_data_out[14] la_data_out[13] la_data_out[12] la_data_out[11] la_data_out[10] la_data_out[9] la_data_out[8] la_data_out[7]
+ la_data_out[6] la_data_out[5] la_data_out[4] la_data_out[3] la_data_out[2] la_data_out[1] la_data_out[0] io_in[26] io_in[25] io_in[24] io_in[23]
+ io_in[22] io_in[21] io_in[20] io_in[19] io_in[18] io_in[17] io_in[16] io_in[15] io_in[14] io_in[13] io_in[12] io_in[11] io_in[10] io_in[9]
+ io_in[8] io_in[7] io_in[6] io_in[5] io_in[4] io_in[3] io_in[2] io_in[1] io_in[0] io_in_3v3[26] io_in_3v3[25] io_in_3v3[24] io_in_3v3[23]
+ io_in_3v3[22] io_in_3v3[21] io_in_3v3[20] io_in_3v3[19] io_in_3v3[18] io_in_3v3[17] io_in_3v3[16] io_in_3v3[15] io_in_3v3[14] io_in_3v3[13]
+ io_in_3v3[12] io_in_3v3[11] io_in_3v3[10] io_in_3v3[9] io_in_3v3[8] io_in_3v3[7] io_in_3v3[6] io_in_3v3[5] io_in_3v3[4] io_in_3v3[3]
+ io_in_3v3[2] io_in_3v3[1] io_in_3v3[0] user_clock2 io_out[26] io_out[25] io_out[24] io_out[23] io_out[22] io_out[21] io_out[20] io_out[19]
+ io_out[18] io_out[17] io_out[16] io_out[15] io_out[14] io_out[13] io_out[12] io_out[11] io_out[10] io_out[9] io_out[8] io_out[7] io_out[6]
+ io_out[5] io_out[4] io_out[3] io_out[2] io_out[1] io_out[0] io_oeb[26] io_oeb[25] io_oeb[24] io_oeb[23] io_oeb[22] io_oeb[21] io_oeb[20]
+ io_oeb[19] io_oeb[18] io_oeb[17] io_oeb[16] io_oeb[15] io_oeb[14] io_oeb[13] io_oeb[12] io_oeb[11] io_oeb[10] io_oeb[9] io_oeb[8] io_oeb[7]
+ io_oeb[6] io_oeb[5] io_oeb[4] io_oeb[3] io_oeb[2] io_oeb[1] io_oeb[0] gpio_analog[17] gpio_analog[16] gpio_analog[15] gpio_analog[14]
+ gpio_analog[13] gpio_analog[12] gpio_analog[11] gpio_analog[10] gpio_analog[9] gpio_analog[8] gpio_analog[7] gpio_analog[6] gpio_analog[5]
+ gpio_analog[4] gpio_analog[3] gpio_analog[2] gpio_analog[1] gpio_analog[0] gpio_noesd[17] gpio_noesd[16] gpio_noesd[15] gpio_noesd[14]
+ gpio_noesd[13] gpio_noesd[12] gpio_noesd[11] gpio_noesd[10] gpio_noesd[9] gpio_noesd[8] gpio_noesd[7] gpio_noesd[6] gpio_noesd[5] gpio_noesd[4]
+ gpio_noesd[3] gpio_noesd[2] gpio_noesd[1] gpio_noesd[0] io_analog[10] io_analog[9] io_analog[8] io_analog[7] io_analog[6] io_analog[5]
+ io_analog[4] io_analog[3] io_analog[2] io_analog[1] io_analog[0] io_clamp_high[2] io_clamp_high[1] io_clamp_high[0] io_clamp_low[2]
+ io_clamp_low[1] io_clamp_low[0] user_irq[2] user_irq[1] user_irq[0] la_oenb[127] la_oenb[126] la_oenb[125] la_oenb[124] la_oenb[123] la_oenb[122]
+ la_oenb[121] la_oenb[120] la_oenb[119] la_oenb[118] la_oenb[117] la_oenb[116] la_oenb[115] la_oenb[114] la_oenb[113] la_oenb[112] la_oenb[111]
+ la_oenb[110] la_oenb[109] la_oenb[108] la_oenb[107] la_oenb[106] la_oenb[105] la_oenb[104] la_oenb[103] la_oenb[102] la_oenb[101] la_oenb[100]
+ la_oenb[99] la_oenb[98] la_oenb[97] la_oenb[96] la_oenb[95] la_oenb[94] la_oenb[93] la_oenb[92] la_oenb[91] la_oenb[90] la_oenb[89]
+ la_oenb[88] la_oenb[87] la_oenb[86] la_oenb[85] la_oenb[84] la_oenb[83] la_oenb[82] la_oenb[81] la_oenb[80] la_oenb[79] la_oenb[78]
+ la_oenb[77] la_oenb[76] la_oenb[75] la_oenb[74] la_oenb[73] la_oenb[72] la_oenb[71] la_oenb[70] la_oenb[69] la_oenb[68] la_oenb[67]
+ la_oenb[66] la_oenb[65] la_oenb[64] la_oenb[63] la_oenb[62] la_oenb[61] la_oenb[60] la_oenb[59] la_oenb[58] la_oenb[57] la_oenb[56]
+ la_oenb[55] la_oenb[54] la_oenb[53] la_oenb[52] la_oenb[51] la_oenb[50] la_oenb[49] la_oenb[48] la_oenb[47] la_oenb[46] la_oenb[45]
+ la_oenb[44] la_oenb[43] la_oenb[42] la_oenb[41] la_oenb[40] la_oenb[39] la_oenb[38] la_oenb[37] la_oenb[36] la_oenb[35] la_oenb[34]
+ la_oenb[33] la_oenb[32] la_oenb[31] la_oenb[30] la_oenb[29] la_oenb[28] la_oenb[27] la_oenb[26] la_oenb[25] la_oenb[24] la_oenb[23]
+ la_oenb[22] la_oenb[21] la_oenb[20] la_oenb[19] la_oenb[18] la_oenb[17] la_oenb[16] la_oenb[15] la_oenb[14] la_oenb[13] la_oenb[12]
+ la_oenb[11] la_oenb[10] la_oenb[9] la_oenb[8] la_oenb[7] la_oenb[6] la_oenb[5] la_oenb[4] la_oenb[3] la_oenb[2] la_oenb[1] la_oenb[0]
*.PININFO vdda1:B vdda2:B vssa1:B vssa2:B vccd1:B vccd2:B vssd1:B vssd2:B wb_clk_i:I wb_rst_i:I wbs_stb_i:I wbs_cyc_i:I wbs_we_i:I
*+ wbs_sel_i[3:0]:I wbs_dat_i[31:0]:I wbs_adr_i[31:0]:I wbs_ack_o:O wbs_dat_o[31:0]:O la_data_in[127:0]:I la_data_out[127:0]:O io_in[26:0]:I
*+ io_in_3v3[26:0]:I user_clock2:I io_out[26:0]:O io_oeb[26:0]:O gpio_analog[17:0]:B gpio_noesd[17:0]:B io_analog[10:0]:B io_clamp_high[2:0]:B
*+ io_clamp_low[2:0]:B user_irq[2:0]:O la_oenb[127:0]:I
x3 gpio_analog[14] gpio_analog[13] gpio_analog[12] gpio_analog[11] gpio_analog[0] la_data_in[11] la_data_in[12] la_data_in[13]
+ la_data_in[14] gpio_analog[7] gpio_analog[6] gpio_analog[5] gpio_analog[4] gpio_analog[3] la_data_in[7] la_data_in[8] la_data_in[9]
+ la_data_in[10] gpio_analog[10] gpio_analog[8] io_analog[3] gpio_analog[15] la_data_in[6] la_data_in[3] gpio_analog[9] gpio_analog[2]
+ la_data_in[5] gpio_analog[17] gpio_analog[1] la_data_in[4] gpio_analog[16] vssd2 vccd2 vccd1 vssd1 la_data_in[70] la_data_in[68]
+ la_data_out[69] neuron_32syn_v1
x5 la_data_in[27] la_data_in[28] la_data_in[29] la_data_in[30] la_data_out[61] io_analog[0] la_data_in[68] la_data_out[65]
+ la_data_out[64] la_data_out[63] la_data_out[62] gpio_analog[0] la_data_in[22] la_data_in[60] gpio_analog[14] gpio_analog[13] gpio_analog[12]
+ gpio_analog[11] gpio_analog[3] gpio_analog[7] gpio_analog[6] gpio_analog[5] gpio_analog[4] gpio_analog[10] la_data_in[23] la_data_in[24]
+ la_data_in[25] la_data_in[26] gpio_analog[8] gpio_analog[15] la_data_in[67] la_data_in[21] la_data_in[66] gpio_analog[16] gpio_analog[2]
+ la_data_in[19] la_data_in[18] la_data_in[17] la_data_in[16] gpio_analog[1] la_data_in[15] gpio_analog[17] gpio_analog[9] la_data_in[20] vssd1
+ vssd2 vccd1 vccd2 neuron_synapse_array_with_input_output_logic_v1
x4 io_analog[2] io_analog[7] io_analog[6] io_analog[8] io_analog[9] io_analog[1] io_analog[3] io_analog[10] io_analog[5]
+ low_noise_amp_fc_v3
x6 io_analog[1] io_analog[7] io_analog[2] io_analog[5] io_analog[3] io_analog[6] io_analog[4] low_noise_amp_fc_v3_withpad
R1 io_oeb[7] vccd1 sky130_fd_pr__res_generic_m3 W=0.56 L=0.56 m=1
R2 io_oeb[8] vccd1 sky130_fd_pr__res_generic_m3 W=0.56 L=0.56 m=1
R3 io_oeb[9] vccd1 sky130_fd_pr__res_generic_m3 W=0.56 L=0.56 m=1
R4 io_oeb[10] vccd1 sky130_fd_pr__res_generic_m3 W=0.56 L=0.56 m=1
R5 io_oeb[12] vccd1 sky130_fd_pr__res_generic_m3 W=0.56 L=0.56 m=1
R6 io_oeb[13] vccd1 sky130_fd_pr__res_generic_m3 W=0.56 L=0.56 m=1
R7 io_oeb[11] vccd1 sky130_fd_pr__res_generic_m3 W=0.56 L=0.56 m=1
R8 io_oeb[14] vccd2 sky130_fd_pr__res_generic_m3 W=0.56 L=0.56 m=1
R9 io_oeb[15] vccd2 sky130_fd_pr__res_generic_m3 W=0.56 L=0.56 m=1
R10 io_oeb[16] vccd2 sky130_fd_pr__res_generic_m3 W=0.56 L=0.56 m=1
R11 io_oeb[17] vccd2 sky130_fd_pr__res_generic_m3 W=0.56 L=0.56 m=1
R12 io_oeb[18] vccd2 sky130_fd_pr__res_generic_m3 W=0.56 L=0.56 m=1
R13 io_oeb[19] vccd2 sky130_fd_pr__res_generic_m3 W=0.56 L=0.56 m=1
R14 io_oeb[20] vccd2 sky130_fd_pr__res_generic_m3 W=0.56 L=0.56 m=1
R15 io_oeb[21] vccd2 sky130_fd_pr__res_generic_m3 W=0.56 L=0.56 m=1
R16 io_oeb[22] vccd2 sky130_fd_pr__res_generic_m3 W=0.56 L=0.56 m=1
R17 io_oeb[23] vccd2 sky130_fd_pr__res_generic_m3 W=0.56 L=0.56 m=1
R18 io_oeb[24] vccd2 sky130_fd_pr__res_generic_m3 W=0.56 L=0.56 m=1
.ends

* expanding   symbol:  neuron_32syn_v1.sym # of pins=26
** sym_path: /home/federico/tue/projects/aVLSI-SkyWater130-2024/xschem/neuron_32syn_v1.sym
** sch_path: /home/federico/tue/projects/aVLSI-SkyWater130-2024/xschem/neuron_32syn_v1.sch
.subckt neuron_32syn_v1 JExcWn[0] JExcWn[1] JExcWn[2] JExcWn[3] ifdcp W[0] W[1] W[2] W[3] JInhWp[0] JInhWp[1] JInhWp[2] JInhWp[3]
+ buffermonp syn_addr[0] syn_addr[1] syn_addr[2] syn_addr[3] vleakn vipulseextp monout vepulseextp resetW syn_req vtaun vrefn setW vtaup
+ vthrdp exc vthrdn dGND dVDD aVDD aGND ack_out nRes req
*.PININFO ack_out:I dGND:B dVDD:B vepulseextp:I syn_addr[0:3]:I W[0:3]:I setW:I resetW:I syn_req:I exc:I vipulseextp:I req:O
*+ vleakn:I ifdcp:I vrefn:I nRes:I aVDD:B buffermonp:I monout:B JExcWn[0:3]:I JInhWp[0:3]:I vtaun:I vthrdp:I vtaup:I vthrdn:I aGND:B
x11 nRes req ack_out ack_cel1 dVDD dGND c_element_rj
x4 setW exc dGND dGND dVDD dVDD setWe sky130_fd_sc_hd__and2_1
x5 exc dGND dGND dVDD dVDD nExc sky130_fd_sc_hd__inv_1
x6 setW nExc dGND dGND dVDD dVDD setWi sky130_fd_sc_hd__and2_1
x7 resetW exc dGND dGND dVDD dVDD resetWe sky130_fd_sc_hd__and2_1
x8 resetW nExc dGND dGND dVDD dVDD resetWi sky130_fd_sc_hd__and2_1
x10 syn_req exc dGND dGND dVDD dVDD reqe sky130_fd_sc_hd__and2_1
x12 syn_req nExc dGND dGND dVDD dVDD reqi sky130_fd_sc_hd__and2_1
x14 ack_cel1 dGND dGND dVDD dVDD net2 sky130_fd_sc_hd__inv_1
x1 W[0] W[1] W[2] W[3] JExcWn[0] JExcWn[1] JExcWn[2] JExcWn[3] net1 syn_addr[0] syn_addr[1] syn_addr[2] syn_addr[3] vepulseextp
+ resetWe reqe setWe vthrdn vtaup dGND dVDD aGND aVDD synapse_array_programmable_16_to_sout_v1
x2 net1 W[0] W[1] W[2] W[3] JInhWp[0] JInhWp[1] JInhWp[2] JInhWp[3] syn_addr[0] syn_addr[1] syn_addr[2] syn_addr[3] vipulseextp
+ resetWi reqi vthrdp setWi vtaun dGND dVDD aVDD aGND synapse_array_programmable_inh_16_to_sout_v1
x9 nreq_neu1 req dVDD dGND schmitt_trigger
x3 aGND aVDD nreq_neu1 ifdcp net2 net1 vleakn vrefn neuron_analog_fc_v2_norail
x13 buffermonp monout net1 aGND aVDD buffer_mon_p_norail
.ends


* expanding   symbol:  neuron_synapse_array_with_input_output_logic_v1.sym # of pins=30
** sym_path: /home/federico/tue/projects/aVLSI-SkyWater130-2024/xschem/neuron_synapse_array_with_input_output_logic_v1.sym
** sch_path: /home/federico/tue/projects/aVLSI-SkyWater130-2024/xschem/neuron_synapse_array_with_input_output_logic_v1.sch
.subckt neuron_synapse_array_with_input_output_logic_v1 W[0] W[1] W[2] W[3] req_o monout nRes aer_o[0] aer_o[1] aer_o[2] aer_o[3]
+ ifdcp resetW ack JExcWn[0] JExcWn[1] JExcWn[2] JExcWn[3] bufmonp JInhWp[0] JInhWp[1] JInhWp[2] JInhWp[3] vleakn syn_addr[0] syn_addr[1]
+ syn_addr[2] syn_addr[3] vipulseextp vepulseextp Da setW CLK vthrdn vrefn neu_addr[0] neu_addr[1] neu_addr[2] neu_addr[3] vthrdp req_inp vtaup
+ vtaun exc aGND dGND aVDD dVDD
*.PININFO vleakn:I vrefn:I ifdcp:I bufmonp:I req_o:O aer_o[0:3]:O dGND:B dVDD:B nRes:I ack:I neu_addr[0:3]:I req_inp:I
*+ syn_addr[0:3]:I exc:I aVDD:B monout:B W[0:3]:I resetW:I setW:I vepulseextp:I vipulseextp:I JExcWn[0:3]:I JInhWp[0:3]:I vthrdp:I vtaun:I vthrdn:I
*+ vtaup:I Da:I CLK:I aGND:B
x1 JInhWp[0] JInhWp[1] JInhWp[2] JInhWp[3] bufmonp ifdcp JExcWn[0] JExcWn[1] JExcWn[2] JExcWn[3] W[0] W[1] W[2] W[3]
+ syn_addr_latched[0] syn_addr_latched[1] syn_addr_latched[2] syn_addr_latched[3] ack_neu[0] ack_neu[1] ack_neu[2] ack_neu[3] ack_neu[4] ack_neu[5]
+ ack_neu[6] ack_neu[7] ack_neu[8] ack_neu[9] ack_neu[10] ack_neu[11] ack_neu[12] ack_neu[13] ack_neu[14] ack_neu[15] vleakn vipulseextp
+ vepulseextp monout[0] monout[1] monout[2] monout[3] monout[4] monout[5] monout[6] monout[7] monout[8] monout[9] monout[10] monout[11]
+ monout[12] monout[13] monout[14] monout[15] resetW neu_req[0] neu_req[1] neu_req[2] neu_req[3] neu_req[4] neu_req[5] neu_req[6] neu_req[7]
+ neu_req[8] neu_req[9] neu_req[10] neu_req[11] neu_req[12] neu_req[13] neu_req[14] neu_req[15] vrefn req_o[0] req_o[1] req_o[2] req_o[3]
+ req_o[4] req_o[5] req_o[6] req_o[7] req_o[8] req_o[9] req_o[10] req_o[11] req_o[12] req_o[13] req_o[14] req_o[15] vthrdn vthrdp setW
+ exc_latched vtaup vtaun aGND dGND aVDD dVDD nRes neuro_synaptic_core_16neu_32syn_v1
x5 req_o[0] req_o[1] req_o[2] req_o[3] req_o[4] req_o[5] req_o[6] req_o[7] req_o[8] req_o[9] req_o[10] req_o[11] req_o[12]
+ req_o[13] req_o[14] req_o[15] ack ack_neu[0] ack_neu[1] ack_neu[2] ack_neu[3] ack_neu[4] ack_neu[5] ack_neu[6] ack_neu[7] ack_neu[8]
+ ack_neu[9] ack_neu[10] ack_neu[11] ack_neu[12] ack_neu[13] ack_neu[14] ack_neu[15] req_o dVDD dGND arbiter_tree_sixteen_bits
x6 aer_o[0] aer_o[1] aer_o[2] aer_o[3] ack_neu[0] ack_neu[1] ack_neu[2] ack_neu[3] ack_neu[4] ack_neu[5] ack_neu[6] ack_neu[7]
+ ack_neu[8] ack_neu[9] ack_neu[10] ack_neu[11] ack_neu[12] ack_neu[13] ack_neu[14] ack_neu[15] dVDD dGND encoder_16_to_4
x3 req_inp syn_addr_latched[0] syn_addr_latched[1] syn_addr_latched[2] syn_addr_latched[3] syn_addr[0] syn_addr[1] syn_addr[2]
+ syn_addr[3] nRes neu_addr_latched[0] neu_addr_latched[1] neu_addr_latched[2] neu_addr_latched[3] neu_addr[0] neu_addr[1] neu_addr[2]
+ neu_addr[3] exc_latched exc req_inp_array dVDD dGND inputs_latch_16neu
x8 dVDD Da CLK dGND nRes monout monout[0] monout[1] monout[2] monout[3] monout[4] monout[5] monout[6] monout[7] monout[8]
+ monout[9] monout[10] monout[11] monout[12] monout[13] monout[14] monout[15] monitor_select
x7 neu_addr_latched[0] neu_addr_latched[1] neu_addr_latched[2] neu_addr_latched[3] neu_req[0] neu_req[1] neu_req[2] neu_req[3]
+ neu_req[4] neu_req[5] neu_req[6] neu_req[7] neu_req[8] neu_req[9] neu_req[10] neu_req[11] neu_req[12] neu_req[13] neu_req[14] neu_req[15]
+ dGND dVDD req_inp_array input_neuron_address_decoder_16_to_1
.ends


* expanding   symbol:  low_noise_amp_fc_v3.sym # of pins=10
** sym_path: /home/federico/tue/projects/aVLSI-SkyWater130-2024/xschem/low_noise_amp_fc_v3.sym
** sch_path: /home/federico/tue/projects/aVLSI-SkyWater130-2024/xschem/low_noise_amp_fc_v3.sch
.subckt low_noise_amp_fc_v3 vss vb1 vb2 vout input vdd iref vref tunep
*.PININFO vdd:B vss:B vref:I iref:I input:I vout:O tunep:I vb1:I vb2:I
XM1 vy vin vp vdd sky130_fd_pr__pfet_01v8 L=2.0 W=4.0 nf=1 m=300
XM2 vx vref vp vdd sky130_fd_pr__pfet_01v8 L=2.0 W=4.0 nf=1 m=300
XM5 vp iref vdd vdd sky130_fd_pr__pfet_01v8 L=0.3 W=3 nf=1 m=120
XC6 vin vout sky130_fd_pr__cap_mim_m3_1 W=5 L=5 m=1
XM6 vx net1 net2 vss sky130_fd_pr__nfet_01v8 L=20.0 W=8.0 nf=1 m=1
XM9 vy net1 net3 vss sky130_fd_pr__nfet_01v8 L=20.0 W=8.0 nf=1 m=1
XM10 net1 net4 vx vss sky130_fd_pr__nfet_01v8 L=1.0 W=10.0 nf=1 m=1
XM12 vout net7 vy vss sky130_fd_pr__nfet_01v8 L=1.0 W=10.0 nf=1 m=1
XM15 net4 vx vss vss sky130_fd_pr__nfet_01v8 L=2.0 W=15.0 nf=1 m=1
XM16 net4 tunep vdd vdd sky130_fd_pr__pfet_01v8 L=3.0 W=1.0 nf=1 m=1
XM17 net1 vb2 net5 vdd sky130_fd_pr__pfet_01v8 L=3.0 W=1.0 nf=1 m=1
XM24 vout vb2 net6 vdd sky130_fd_pr__pfet_01v8 L=3.0 W=1.0 nf=1 m=1
XM25 net5 vb1 vdd vdd sky130_fd_pr__pfet_01v8 L=3.0 W=1.0 nf=1 m=1
XM26 net6 vb1 vdd vdd sky130_fd_pr__pfet_01v8 L=3.0 W=1.0 nf=1 m=1
XM7 net7 vy vss vss sky130_fd_pr__nfet_01v8 L=2.0 W=15.0 nf=1 m=1
XM27 net7 tunep vdd vdd sky130_fd_pr__pfet_01v8 L=3.0 W=1.0 nf=1 m=1.0
XM36 vres vres vin vin sky130_fd_pr__pfet_01v8_hvt L=3.0 W=1.0 nf=1 m=1
XM37 vres vres vout vout sky130_fd_pr__pfet_01v8_hvt L=3.0 W=1.0 nf=1 m=1
XM3 net2 net1 vss vss sky130_fd_pr__nfet_01v8 L=20.0 W=8.0 nf=1 m=1
XM4 net3 net1 vss vss sky130_fd_pr__nfet_01v8 L=20.0 W=8.0 nf=1 m=1
XC1 vin input sky130_fd_pr__cap_mim_m3_1 W=132 L=70 m=1
.ends


* expanding   symbol:  low_noise_amp_fc_v3_withpad.sym # of pins=7
** sym_path: /home/federico/tue/projects/aVLSI-SkyWater130-2024/xschem/low_noise_amp_fc_v3_withpad.sym
** sch_path: /home/federico/tue/projects/aVLSI-SkyWater130-2024/xschem/low_noise_amp_fc_v3_withpad.sch
.subckt low_noise_amp_fc_v3_withpad vdd vb1 vss tunep iref vb2 vout
*.PININFO vdd:B vss:B iref:I vout:O tunep:I vb1:I vb2:I
XM1 vy vin vp vdd sky130_fd_pr__pfet_01v8 L=2.0 W=4.0 nf=1 m=300
XM2 vx padref vp vdd sky130_fd_pr__pfet_01v8 L=2.0 W=4.0 nf=1 m=300
XM5 vp iref vdd vdd sky130_fd_pr__pfet_01v8 L=0.3 W=3 nf=1 m=120
XC6 vin vout sky130_fd_pr__cap_mim_m3_1 W=5 L=5 m=1
XM6 vx net1 net2 vss sky130_fd_pr__nfet_01v8 L=20.0 W=8.0 nf=1 m=1
XM9 vy net1 net3 vss sky130_fd_pr__nfet_01v8 L=20.0 W=8.0 nf=1 m=1
XM10 net1 net4 vx vss sky130_fd_pr__nfet_01v8 L=1.0 W=10.0 nf=1 m=1
XM12 vout net7 vy vss sky130_fd_pr__nfet_01v8 L=1.0 W=10.0 nf=1 m=1
XM15 net4 vx vss vss sky130_fd_pr__nfet_01v8 L=2.0 W=15.0 nf=1 m=1
XM16 net4 tunep vdd vdd sky130_fd_pr__pfet_01v8 L=3.0 W=1.0 nf=1 m=1
XM17 net1 vb2 net5 vdd sky130_fd_pr__pfet_01v8 L=3.0 W=1.0 nf=1 m=1
XM24 vout vb2 net6 vdd sky130_fd_pr__pfet_01v8 L=3.0 W=1.0 nf=1 m=1
XM25 net5 vb1 vdd vdd sky130_fd_pr__pfet_01v8 L=3.0 W=1.0 nf=1 m=1
XM26 net6 vb1 vdd vdd sky130_fd_pr__pfet_01v8 L=3.0 W=1.0 nf=1 m=1
XM7 net7 vy vss vss sky130_fd_pr__nfet_01v8 L=2.0 W=15.0 nf=1 m=1
XM27 net7 tunep vdd vdd sky130_fd_pr__pfet_01v8 L=3.0 W=1.0 nf=1 m=1.0
XM36 vres vres vin vin sky130_fd_pr__pfet_01v8_hvt L=3.0 W=1.0 nf=1 m=1
XM37 vres vres vout vout sky130_fd_pr__pfet_01v8_hvt L=3.0 W=1.0 nf=1 m=1
XM3 net2 net1 vss vss sky130_fd_pr__nfet_01v8 L=20.0 W=8.0 nf=1 m=1
XM4 net3 net1 vss vss sky130_fd_pr__nfet_01v8 L=20.0 W=8.0 nf=1 m=1
XC1 vin inputpad sky130_fd_pr__cap_mim_m3_1 W=132 L=70 m=1
.ends


* expanding   symbol:  c_element_rj.sym # of pins=6
** sym_path: /home/federico/tue/projects/aVLSI-SkyWater130-2024/xschem/c_element_rj.sym
** sch_path: /home/federico/tue/projects/aVLSI-SkyWater130-2024/xschem/c_element_rj.sch
.subckt c_element_rj nrst a b c dVDD dGND
*.PININFO dGND:B dVDD:B c:O b:I a:I nrst:I
XM14 c net6 dVDD dVDD sky130_fd_pr__pfet_01v8 L=0.15 W=1 nf=1 m=1
XM5 net6 nrst dVDD dVDD sky130_fd_pr__pfet_01v8 L=0.15 W=1 nf=1 m=1
XM6 net5 b dVDD dVDD sky130_fd_pr__pfet_01v8 L=0.15 W=1 nf=1 m=1
XM4 net4 a dVDD dVDD sky130_fd_pr__pfet_01v8 L=0.15 W=1 nf=1 m=1
XM7 net3 b net4 dVDD sky130_fd_pr__pfet_01v8 L=0.15 W=1 nf=1 m=1
XM8 net3 a net5 dVDD sky130_fd_pr__pfet_01v8 L=0.15 W=1 nf=1 m=1
XM10 net5 c net4 dVDD sky130_fd_pr__pfet_01v8 L=0.15 W=1 nf=1 m=1
XM12 c net6 dGND dGND sky130_fd_pr__nfet_01v8 L=0.15 W=0.65 nf=1 m=1
XM1 net3 nrst net6 dGND sky130_fd_pr__nfet_01v8 L=0.15 W=0.65 nf=1 m=1
XM2 net3 b net1 dGND sky130_fd_pr__nfet_01v8 L=0.15 W=0.65 nf=1 m=1
XM3 net3 a net2 dGND sky130_fd_pr__nfet_01v8 L=0.15 W=0.65 nf=1 m=1
XM9 net2 c net1 dGND sky130_fd_pr__nfet_01v8 L=0.15 W=0.65 nf=1 m=1
XM11 net1 a dGND dGND sky130_fd_pr__nfet_01v8 L=0.15 W=0.65 nf=1 m=1
XM13 net2 b dGND dGND sky130_fd_pr__nfet_01v8 L=0.15 W=0.65 nf=1 m=1
.ends


* expanding   symbol:  synapse_array_programmable_16_to_sout_v1.sym # of pins=14
** sym_path: /home/federico/tue/projects/aVLSI-SkyWater130-2024/xschem/synapse_array_programmable_16_to_sout_v1.sym
** sch_path: /home/federico/tue/projects/aVLSI-SkyWater130-2024/xschem/synapse_array_programmable_16_to_sout_v1.sch
.subckt synapse_array_programmable_16_to_sout_v1 W[0] W[1] W[2] W[3] JExcWn[0] JExcWn[1] JExcWn[2] JExcWn[3] sout syn_addr[0]
+ syn_addr[1] syn_addr[2] syn_addr[3] vpulseextp resetW req setW vthrdn vtaup GND VDD aGND aVDD
*.PININFO GND:B VDD:B vpulseextp:I syn_addr[0:3]:I W[0:3]:I JExcWn[0:3]:I sout:B setW:I resetW:I req:I vthrdn:I vtaup:I aVDD:B
*+ aGND:B
x3 syn_addr[0] syn_addr[1] syn_addr[2] syn_addr[3] D[0] D[1] D[2] D[3] D[4] D[5] D[6] D[7] D[8] D[9] D[10] D[11] D[12] D[13] D[14]
+ D[15] req req_syn VDD GND decoder_4_to_16
x2[0] req_syn D[0] GND GND VDD VDD net1[15] sky130_fd_sc_hd__and2_1
x2[1] req_syn D[1] GND GND VDD VDD net1[14] sky130_fd_sc_hd__and2_1
x2[2] req_syn D[2] GND GND VDD VDD net1[13] sky130_fd_sc_hd__and2_1
x2[3] req_syn D[3] GND GND VDD VDD net1[12] sky130_fd_sc_hd__and2_1
x2[4] req_syn D[4] GND GND VDD VDD net1[11] sky130_fd_sc_hd__and2_1
x2[5] req_syn D[5] GND GND VDD VDD net1[10] sky130_fd_sc_hd__and2_1
x2[6] req_syn D[6] GND GND VDD VDD net1[9] sky130_fd_sc_hd__and2_1
x2[7] req_syn D[7] GND GND VDD VDD net1[8] sky130_fd_sc_hd__and2_1
x2[8] req_syn D[8] GND GND VDD VDD net1[7] sky130_fd_sc_hd__and2_1
x2[9] req_syn D[9] GND GND VDD VDD net1[6] sky130_fd_sc_hd__and2_1
x2[10] req_syn D[10] GND GND VDD VDD net1[5] sky130_fd_sc_hd__and2_1
x2[11] req_syn D[11] GND GND VDD VDD net1[4] sky130_fd_sc_hd__and2_1
x2[12] req_syn D[12] GND GND VDD VDD net1[3] sky130_fd_sc_hd__and2_1
x2[13] req_syn D[13] GND GND VDD VDD net1[2] sky130_fd_sc_hd__and2_1
x2[14] req_syn D[14] GND GND VDD VDD net1[1] sky130_fd_sc_hd__and2_1
x2[15] req_syn D[15] GND GND VDD VDD net1[0] sky130_fd_sc_hd__and2_1
x1[0] sout JExcWn[0] JExcWn[1] JExcWn[2] JExcWn[3] net1[15] resetW vpulseextp net2[15] vthrdn W[0] W[1] W[2] W[3] vtaup VDD GND
+ aVDD aGND synapse_4bit_memory_v1_norail
x1[1] sout JExcWn[0] JExcWn[1] JExcWn[2] JExcWn[3] net1[14] resetW vpulseextp net2[14] vthrdn W[0] W[1] W[2] W[3] vtaup VDD GND
+ aVDD aGND synapse_4bit_memory_v1_norail
x1[2] sout JExcWn[0] JExcWn[1] JExcWn[2] JExcWn[3] net1[13] resetW vpulseextp net2[13] vthrdn W[0] W[1] W[2] W[3] vtaup VDD GND
+ aVDD aGND synapse_4bit_memory_v1_norail
x1[3] sout JExcWn[0] JExcWn[1] JExcWn[2] JExcWn[3] net1[12] resetW vpulseextp net2[12] vthrdn W[0] W[1] W[2] W[3] vtaup VDD GND
+ aVDD aGND synapse_4bit_memory_v1_norail
x1[4] sout JExcWn[0] JExcWn[1] JExcWn[2] JExcWn[3] net1[11] resetW vpulseextp net2[11] vthrdn W[0] W[1] W[2] W[3] vtaup VDD GND
+ aVDD aGND synapse_4bit_memory_v1_norail
x1[5] sout JExcWn[0] JExcWn[1] JExcWn[2] JExcWn[3] net1[10] resetW vpulseextp net2[10] vthrdn W[0] W[1] W[2] W[3] vtaup VDD GND
+ aVDD aGND synapse_4bit_memory_v1_norail
x1[6] sout JExcWn[0] JExcWn[1] JExcWn[2] JExcWn[3] net1[9] resetW vpulseextp net2[9] vthrdn W[0] W[1] W[2] W[3] vtaup VDD GND aVDD
+ aGND synapse_4bit_memory_v1_norail
x1[7] sout JExcWn[0] JExcWn[1] JExcWn[2] JExcWn[3] net1[8] resetW vpulseextp net2[8] vthrdn W[0] W[1] W[2] W[3] vtaup VDD GND aVDD
+ aGND synapse_4bit_memory_v1_norail
x1[8] sout JExcWn[0] JExcWn[1] JExcWn[2] JExcWn[3] net1[7] resetW vpulseextp net2[7] vthrdn W[0] W[1] W[2] W[3] vtaup VDD GND aVDD
+ aGND synapse_4bit_memory_v1_norail
x1[9] sout JExcWn[0] JExcWn[1] JExcWn[2] JExcWn[3] net1[6] resetW vpulseextp net2[6] vthrdn W[0] W[1] W[2] W[3] vtaup VDD GND aVDD
+ aGND synapse_4bit_memory_v1_norail
x1[10] sout JExcWn[0] JExcWn[1] JExcWn[2] JExcWn[3] net1[5] resetW vpulseextp net2[5] vthrdn W[0] W[1] W[2] W[3] vtaup VDD GND
+ aVDD aGND synapse_4bit_memory_v1_norail
x1[11] sout JExcWn[0] JExcWn[1] JExcWn[2] JExcWn[3] net1[4] resetW vpulseextp net2[4] vthrdn W[0] W[1] W[2] W[3] vtaup VDD GND
+ aVDD aGND synapse_4bit_memory_v1_norail
x1[12] sout JExcWn[0] JExcWn[1] JExcWn[2] JExcWn[3] net1[3] resetW vpulseextp net2[3] vthrdn W[0] W[1] W[2] W[3] vtaup VDD GND
+ aVDD aGND synapse_4bit_memory_v1_norail
x1[13] sout JExcWn[0] JExcWn[1] JExcWn[2] JExcWn[3] net1[2] resetW vpulseextp net2[2] vthrdn W[0] W[1] W[2] W[3] vtaup VDD GND
+ aVDD aGND synapse_4bit_memory_v1_norail
x1[14] sout JExcWn[0] JExcWn[1] JExcWn[2] JExcWn[3] net1[1] resetW vpulseextp net2[1] vthrdn W[0] W[1] W[2] W[3] vtaup VDD GND
+ aVDD aGND synapse_4bit_memory_v1_norail
x1[15] sout JExcWn[0] JExcWn[1] JExcWn[2] JExcWn[3] net1[0] resetW vpulseextp net2[0] vthrdn W[0] W[1] W[2] W[3] vtaup VDD GND
+ aVDD aGND synapse_4bit_memory_v1_norail
x3[0] D[0] setW GND GND VDD VDD net2[15] sky130_fd_sc_hd__and2_1
x3[1] D[1] setW GND GND VDD VDD net2[14] sky130_fd_sc_hd__and2_1
x3[2] D[2] setW GND GND VDD VDD net2[13] sky130_fd_sc_hd__and2_1
x3[3] D[3] setW GND GND VDD VDD net2[12] sky130_fd_sc_hd__and2_1
x3[4] D[4] setW GND GND VDD VDD net2[11] sky130_fd_sc_hd__and2_1
x3[5] D[5] setW GND GND VDD VDD net2[10] sky130_fd_sc_hd__and2_1
x3[6] D[6] setW GND GND VDD VDD net2[9] sky130_fd_sc_hd__and2_1
x3[7] D[7] setW GND GND VDD VDD net2[8] sky130_fd_sc_hd__and2_1
x3[8] D[8] setW GND GND VDD VDD net2[7] sky130_fd_sc_hd__and2_1
x3[9] D[9] setW GND GND VDD VDD net2[6] sky130_fd_sc_hd__and2_1
x3[10] D[10] setW GND GND VDD VDD net2[5] sky130_fd_sc_hd__and2_1
x3[11] D[11] setW GND GND VDD VDD net2[4] sky130_fd_sc_hd__and2_1
x3[12] D[12] setW GND GND VDD VDD net2[3] sky130_fd_sc_hd__and2_1
x3[13] D[13] setW GND GND VDD VDD net2[2] sky130_fd_sc_hd__and2_1
x3[14] D[14] setW GND GND VDD VDD net2[1] sky130_fd_sc_hd__and2_1
x3[15] D[15] setW GND GND VDD VDD net2[0] sky130_fd_sc_hd__and2_1
.ends
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
