federicohyo/OSCAR/(commit log)

2026-10-03 Initial OSCAR release: design, firmware, host, measurements, data and docs
    Open-silicon chemosensing analog RISC-V array (SkyWater 130 nm,
    Caravel/Caravan): chip design sources, RISC-V firmware + host bridge,
    archived paper-linked datasets and the scripts to replot the ISCAS 2026 /
    ISCAS 2027 results. No papers/LaTeX are redistributed; oversized design
    files omitted (see NOTICE).
    [02_new_divider_level_sweep.csv, 123initialstatetest.sch, 16-to-1_analog_mux.sch, 4-to-1_analog_mux.sch, 420x150_lvt_flat.sch, LNA_singletrace.sch, analog_mux.sch, arbiter_cell_two_bits_fc.sch]
2026-10-03 Make OSCAR self-contained: remove paper/manuscript references
    [energy_table.csv, odor_sim_ref.csv, reservoir_frontier.json]
2026-10-03 Fix reproduction paths, capacity row, schematic ref; add author
    [constants.py, deff_noise_ceiling.py, lna_bringup_check.py, lna_gain_tune.py, lna_phase_sweep.py]
