federicohyo/OSCAR/(notices)

Notices in the files:
design/README.md:
License: Apache 2.0
